ISU-MAVRIC/MAVRIC_Hardware/Pre-2016/Arm/Arm Design 2013-2014/Pictures/arm base.PNG

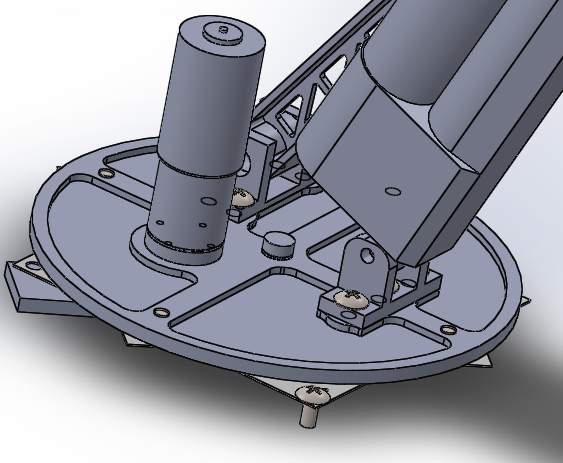
Pre-2016/Arm/Arm Design 2013-2014/Pictures/arm base.PNG
