ISU-MAVRIC/MAVRIC_Hardware/README.md

MAVRIC_Hardware
===============

Hardware design files for MAVRIC
