ISU-MAVRIC/MAVRIC_Hardware/Pre-2016/Chassis/Chassis 1 (Box Chassis)/Renders/Crossmember.JPG

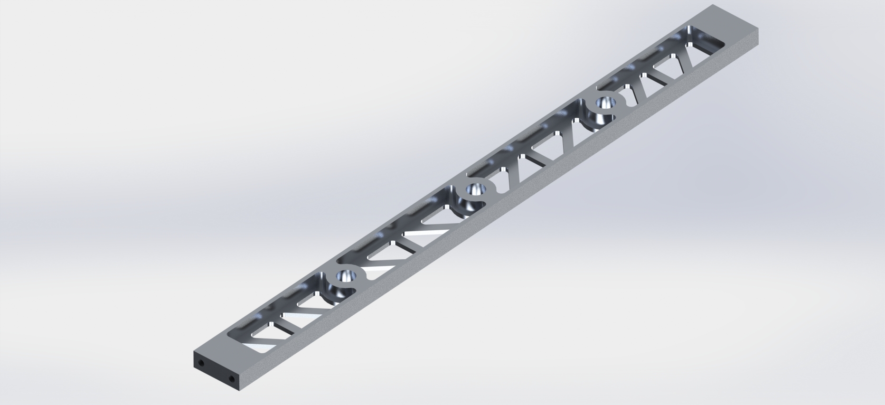
Pre-2016/Chassis/Chassis 1 (Box Chassis)/Renders/Crossmember.JPG
