ISU-MAVRIC/MAVRIC_Hardware/Pre-2016/Chassis/Chassis 1 (Box Chassis)/Renders/Diff Bar Render.JPG

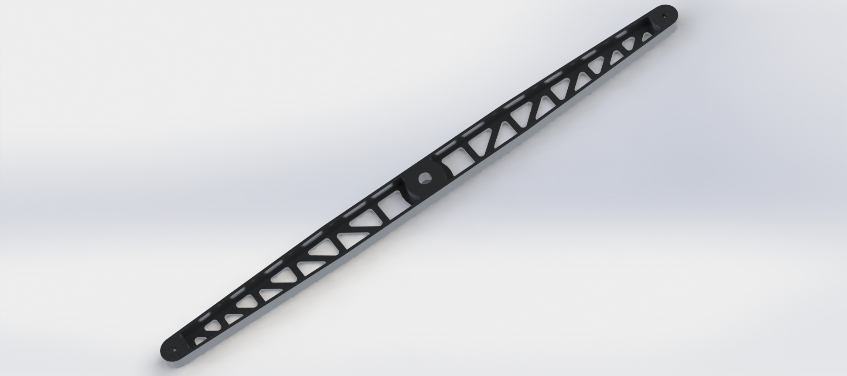
Pre-2016/Chassis/Chassis 1 (Box Chassis)/Renders/Diff Bar Render.JPG
