ISU-MAVRIC/MAVRIC_Hardware/Pre-2016/Photos/MAVRIC side view (Poster).JPG

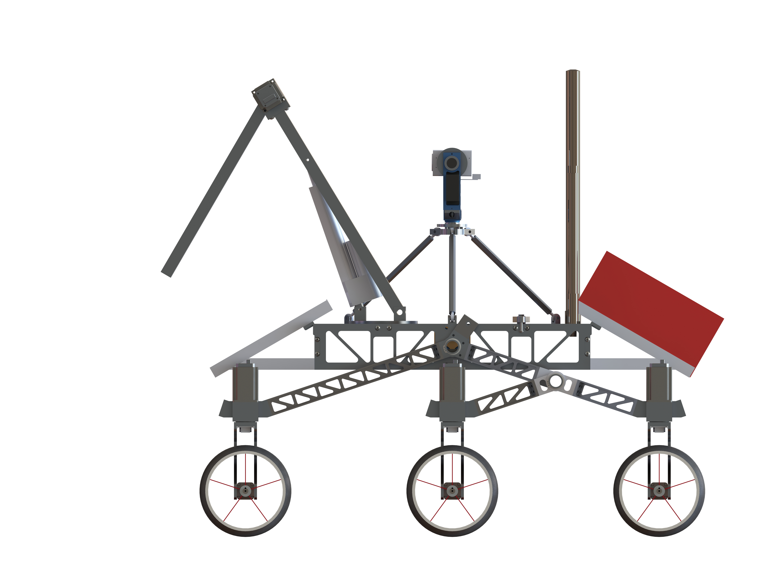
Pre-2016/Photos/MAVRIC side view (Poster).JPG
