ISU-MAVRIC/MAVRIC_Hardware/2017/Motherboard/BOMs/Motherboard BOM.xlsx

Sheet: BOM
Part | Package | Cost | Qty. | Total
Motherboard
4.7uF Cap (http://www.digikey.com/product-detail/en/samsung-electro-mechanics-america-inc/CL10B475KQ8NQNC/1276-2087-1-ND/3890173) | 603 | 0.1
0.1uF Cap (http://www.digikey.com/product-detail/en/avx-corporation/08055C104KAT2A/478-1395-1-ND/564427) | 805 | 0.1
22pF Cap (http://www.digikey.com/product-detail/en/avx-corporation/06035A220JAT2A/478-1167-1-ND/564199) | 603 | 0.1
10uF Cap (http://www.digikey.com/product-detail/en/murata-electronics-north-america/GRM21BR60J106ME19L/490-1718-1-ND/587425) | 805 | 0.1
22uF Cap (http://www.digikey.com/product-detail/en/samsung-electro-mechanics-america-inc/CL21A226MQCLQNC/1276-2412-1-ND/3890498) | 805 | 0.1
Green LED (http://www.digikey.com/product-detail/en/lite-on-inc/LTST-C191KGKT/160-1446-1-ND/386834) | 603 | 0.29
Red LED (http://www.digikey.com/product-detail/en/lite-on-inc/LTST-C190KRKT/160-1436-1-ND/386816) | 603 | 0.27
Female DB9 (http://www.digikey.com/product-detail/en/norcomp-inc/190-009-263R001/190-09FA-ND/1086934) | SMT | 2.53
Female DB9 (http://www.digikey.com/product-detail/en/assmann-wsw-components/A-DF-09-A-KG-T2S/AE10921-ND/1241800) | Through Hole | 0.78
PCIe 36 (http://www.digikey.com/product-detail/en/molex-llc/0877159008/WM12799-ND/3469125) | Through Hole | 1.36
10k Res (http://www.digikey.com/product-detail/en/stackpole-electronics-inc/RMCF0805JT10K0/RMCF0805JT10K0CT-ND/1942577) | 805 | 0.1
220 Res (http://www.digikey.com/product-detail/en/yageo/RC1206FR-07220RL/311-220FRCT-ND/731640) | 1206 | 0.1
2.2k Res (http://www.digikey.com/product-detail/en/stackpole-electronics-inc/RMCF0805JT2K20/RMCF0805JT2K20CT-ND/1942563) | 805 | 0.1
SPST Button (http://www.digikey.com/product-detail/en/c-k/PTS645SM43SMTR92-LFS/CKN9112CT-ND/1146934) | SW_SPSTEVQP0 | 0.15
MSP432P401 (http://www.digikey.com/product-detail/en/texas-instruments/MSP432P401RIPZR/296-44715-1-ND/6167110) | LQFP_100_14mmx14mm | 8.31
LM340MP-5.0 (http://www.digikey.com/product-detail/en/texas-instruments/LM340MP-5.0-NOPB/LM340MP-5.0-NOPBCT-ND/270747) | SOT-223-4 | 1.24
LD1086DT33TR (http://www.digikey.com/product-detail/en/stmicroelectronics/LD1086DT33TR/497-3446-1-ND/669240) | TO-252 | 0.98
MCP9808 (http://www.digikey.com/product-detail/en/microchip-technology/MCP9808T-E-MS/MCP9808T-E-MSCT-ND/5169548) | MSOP8_3mmx3mm | 1.16
Enclosure (http://www.newark.com/multicomp/mc001109/enclosure-ip65-pc-grey/dp/84Y6290) |  | 14.66

Sheet: Power Budget
Part | Qty | Voltage | Current (mA) | Total Current | Notes | Temp
Motherboard
Green LED (http://www.digikey.com/product-detail/en/lite-on-inc/LTST-C191KGKT/160-1446-1-ND/386834) | 3 | 3.3v | 0.05 | 0.15
Red LED (http://www.digikey.com/product-detail/en/lite-on-inc/LTST-C190KRKT/160-1436-1-ND/386816) | 4 | 3.3v | 0.05 | 0.2
MSP432P401 (http://www.digikey.com/product-detail/en/texas-instruments/MSP432P401RIPZR/296-44715-1-ND/6167110) | 1 | 3.3v | 3.84 | 3.84
LM340MP-5.0 (http://www.digikey.com/product-detail/en/texas-instruments/LM340MP-5.0-NOPB/LM340MP-5.0-NOPBCT-ND/270747) | -- | -- | -- | -- | 1.5A Limit
LD1086DT33TR (http://www.digikey.com/product-detail/en/stmicroelectronics/LD1086DT33TR/497-3446-1-ND/669240) | -- | -- | -- | -- | 1.5A Limit
MCP9808 (http://www.digikey.com/product-detail/en/microchip-technology/MCP9808T-E-MS/MCP9808T-E-MSCT-ND/5169548) | 1 | 3.3v | 0.2 | 0.2
PWM Board
PCA9685 (http://www.nxp.com/documents/data_sheet/PCA9685.pdf) | 1 | 3.3v | 200 | 200 | Per pin, can sink 25mA and source 10mA | -40C to +85C
ADS1015 (http://www.digikey.com/product-detail/en/texas-instruments/ADS1015IDGSR/296-41185-1-ND/5222640) | 2 | 3.3v | 0.15 | 0.3 |  | -40C to +125C
