ISU-MAVRIC/MAVRIC_Hardware/2017/Arduino Practice Board/Ordering Information/ArduinoPracticeBoard BOM.xlsx

Part | Package Size | Supplier | Price Each | # | Total Price
PCB (https://oshpark.com/) | 1.5"x1.44" | OSH Park | $11.00 | 1 | $11.00
10uf Tantalum Capacitor (http://www.digikey.com/product-detail/en/kemet/T491A106K010AT/399-3684-1-ND/819009) | 1206 | Digikey | $0.38 | 3 | $1.14
18pF Cer. Capacitor (http://www.digikey.com/product-detail/en/murata-electronics-north-america/GRM1555C1H180FA01D/490-6203-1-ND/3845400) | 0402 | Digikey | $0.04 | 10 | $0.43
Green LED (http://www.digikey.com/product-detail/en/lite-on-inc/LTST-C230KGKT/160-1456-1-ND/386854) | 1206 | Digikey | $0.34 | 3 | $1.02
10k Resistor (http://www.digikey.com/product-detail/en/yageo/RC0603JR-0710KL/311-10KGRCT-ND/729647) | 0603 | Digikey | $0.01 | 10 | $0.11
16MHz Crystal (http://www.digikey.com/product-detail/en/abracon-llc/ABLS-16.000MHZ-B4-T/535-10226-1-ND/2184261) | HC49/US | Digikey | $0.25 | 3 | $0.75
Tactile Switch (http://www.digikey.com/product-detail/en/c-k-components/PTS645SM43SMTR92-LFS/CKN9112CT-ND/1146934) | 6.0mmx6.0mm | Digikey | $0.15 | 3 | $0.45
ATMEGA328-AU-ND (http://www.digikey.com/scripts/DkSearch/dksus.dll?Detail&itemSeq=211061238&uq=636138769219925247) | 32-TQFP | Digikey | $3.25 | 3 | $9.75
2.54mm Header | 50pcsx40row | Amazon | $6.06 | 1 | $6.06
 |  |  |  |  | Total
 |  |  |  |  | $30.71
