ISU-MAVRIC/MAVRIC_Hardware/MAVRIC.SLDASM

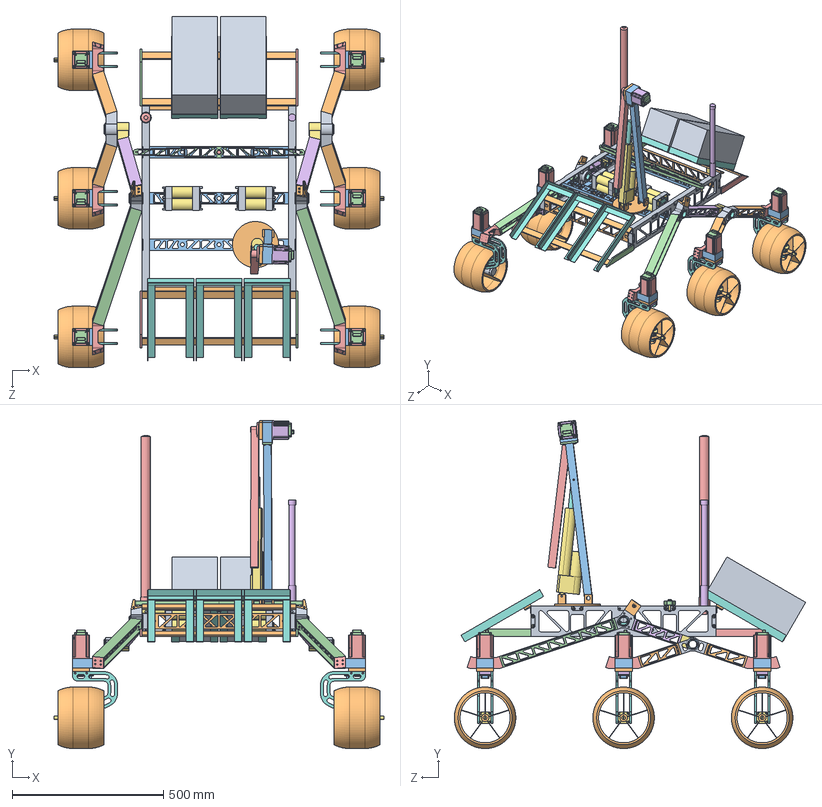
[picture p57: CAD file, 2013-12-05]
MAVRIC.SLDASM
1089.2 x 1083.1 x 1159.7 mm
Chassis Side Rail x 2
Front Bar x 2
Cross Bar x 3
Diff Bar
Diff Bar Axle
98585A109 x 2
socket button head cap screw_ai x 31
King Pin x 2
King Joint x 2
Diff Yoke x 2
98585A127 x 4
Rocker Leg x 2
Wheel Joint x 6
Rocker Rear Leg x 2
Bogie-Rocker Joint x 2
Joint Pin x 2
Bogie Joint x 2
Bogie Leg x 4
Dual Stage Housing x 7
6383K140 Input bearing x 7
Dual Stage Eccentric Cam x 7
5905K230 Roller Bearing x 7
First Stage Cycloidal Profile-Reduced Diameter Version x 7
Second Stage Cycloidal Profile-Reduced Diamter Version x 7
Dual Stage Output Disk-Reduced Diameter Version x 7
Cover x 7
6383K120 x 28
5909K370 x 14
Stepper 23079 x 6
Steering Top Plate x 6
P60_64_Gearbox x 6
Drop Plate x 12
RS555 Motor x 6
Wheel x 6
Wheel Driver x 6
Stepper Driver x 7
Data Antenna
Video Antenna
M Cell Battery x 8
Battery Bar x 6
Cell Holder x 8
Rotary Plate
Lower Arm
Gearbox Mount
Upper Arm
Stepper 23055
Firgelli Base
Firgelli Extension
Payload Support Clip x 2
Payload Cross Member x 4
Payload Bottom Clip x 2
Payload Bottom Member x 2
MirrorPayload Bottom Member x 2
MirrorPayload Bottom Clip x 2
MirrorPayload Support Clip x 2
Payload Frame x 5
Large Payload x 2
