ISU-MAVRIC/MAVRIC_Hardware/Pre-2016/Camera/Camera Assembly.SLDASM

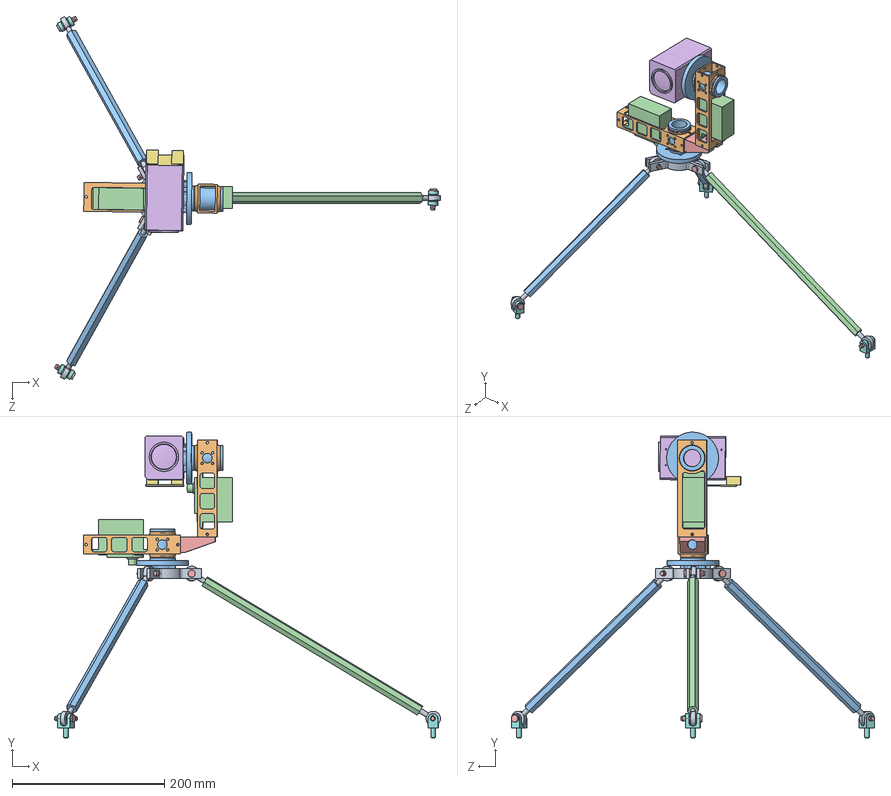
[picture p58: CAD file, 2014-04-26]
Pre-2016/Camera/Camera Assembly.SLDASM
507.2 x 401.7 x 477.6 mm
Camera Mount
Servo Frame x 2
Servo Axle x 2
HS785HB Servo x 2
Elbow
FCB EX1020
Camera Board
Camera Anchor x 3
Ball Joint Housing x 6
Ball Joint Ball x 6
Camera Leg x 2
Side Leg
90156A259 x 6
