ISU-MAVRIC/MAVRIC_Hardware/Pre-2016/Chassis/Chassis 1 (Box Chassis)/Chassis Assembly.SLDASM

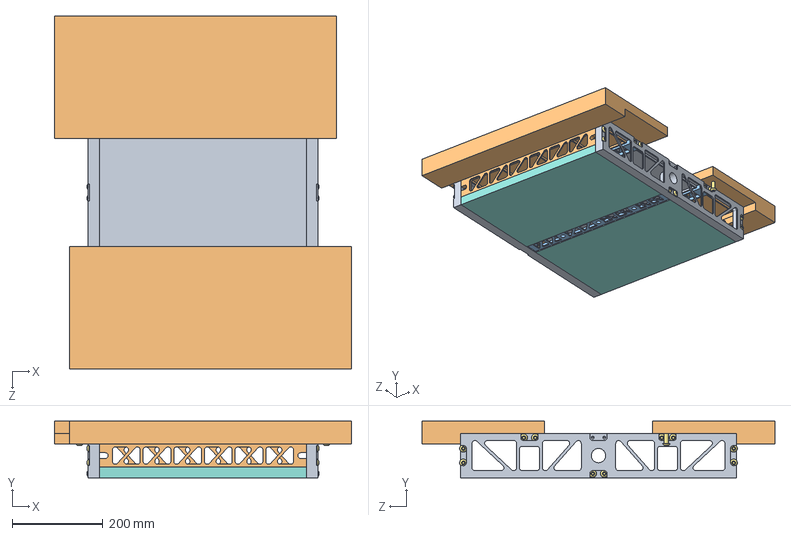
[picture p59: CAD file, 2014-04-26]
Pre-2016/Chassis/Chassis 1 (Box Chassis)/Chassis Assembly.SLDASM
656.0 x 125.4 x 779.5 mm
Chassis Side Rail x 2
Front Bar x 2
Cross Bar x 3
Diff Bar
Diff Bar Axle
98585A109 x 2
socket button head cap screw_ai x 22
Fiberglass Bottom Covers x 2
Center composite panel
Chassis Top Right Composite x 2
