ISU-MAVRIC/MAVRIC_Hardware/Pre-2016/Chassis/Chassis 1 (Box Chassis)/Major components/Mold Cavity.SLDASM

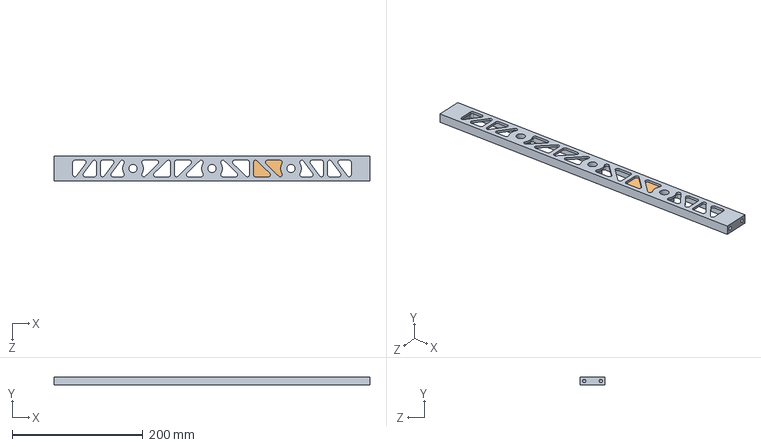
[picture p60: CAD file, 2014-04-17]
Pre-2016/Chassis/Chassis 1 (Box Chassis)/Major components/Mold Cavity.SLDASM
482.6 x 12.7 x 38.1 mm
Cross Bar
Cross Bar Mount 2
