ISU-MAVRIC/MAVRIC_Hardware/Pre-2016/Electrical/Cell Battery Assembly.SLDASM

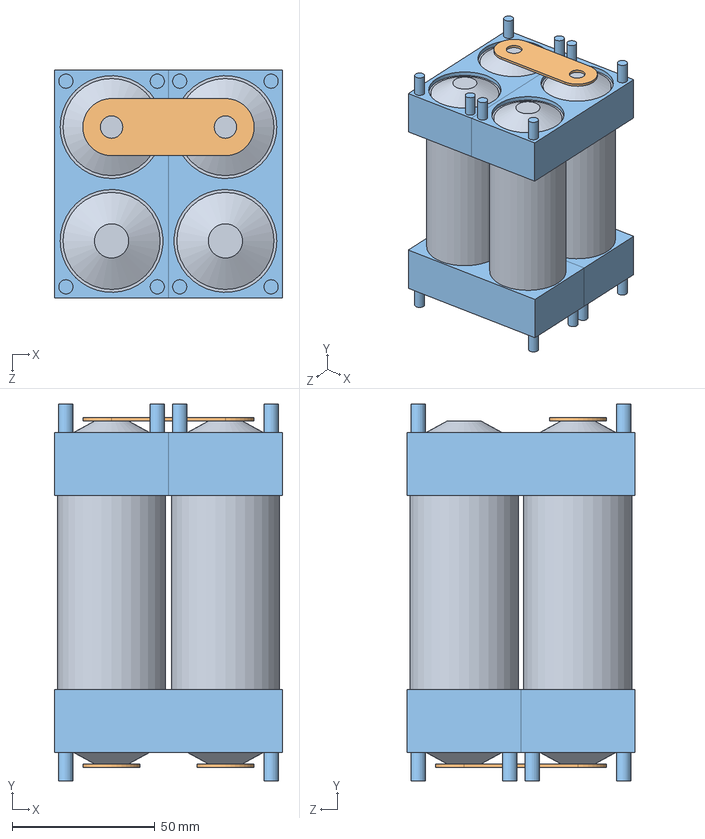
[picture p61: CAD file, 2014-04-26]
Pre-2016/Electrical/Cell Battery Assembly.SLDASM
80.0 x 132.0 x 80.0 mm
M Cell Battery x 4
Battery Bar x 3
Cell Holder x 4
