ISU-MAVRIC/MAVRIC_Hardware/Pre-2016/End Effector/End Effector Assemblies/End Effector Assembly 4.SLDASM

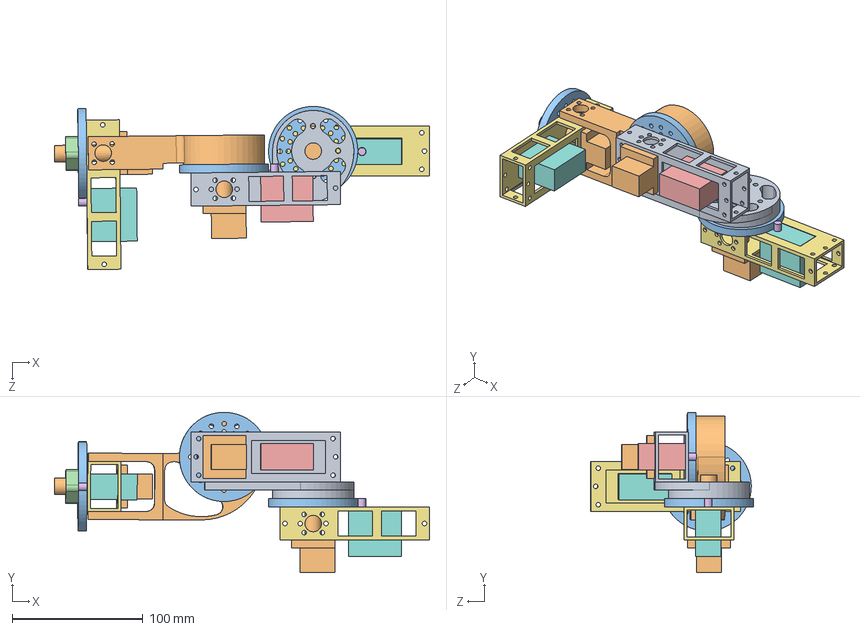
[picture p62: CAD file, 2014-04-15]
Pre-2016/End Effector/End Effector Assemblies/End Effector Assembly 4.SLDASM
286.7 x 122.6 x 124.7 mm
High Torque Gear Box Bracket
Large Spindle x 3
Big Gear x 3
Big Gear Hub x 3
High Torque Servo
Small Spindle x 3
Low Torque Gear Box Bracket x 2
Low Torque Servo x 2
bracket1-2
bracket2-3
