ISU-MAVRIC/MAVRIC_Hardware/Pre-2016/End Effector/Servo Assemblies/High Torque Gear Box Assembly.SLDASM

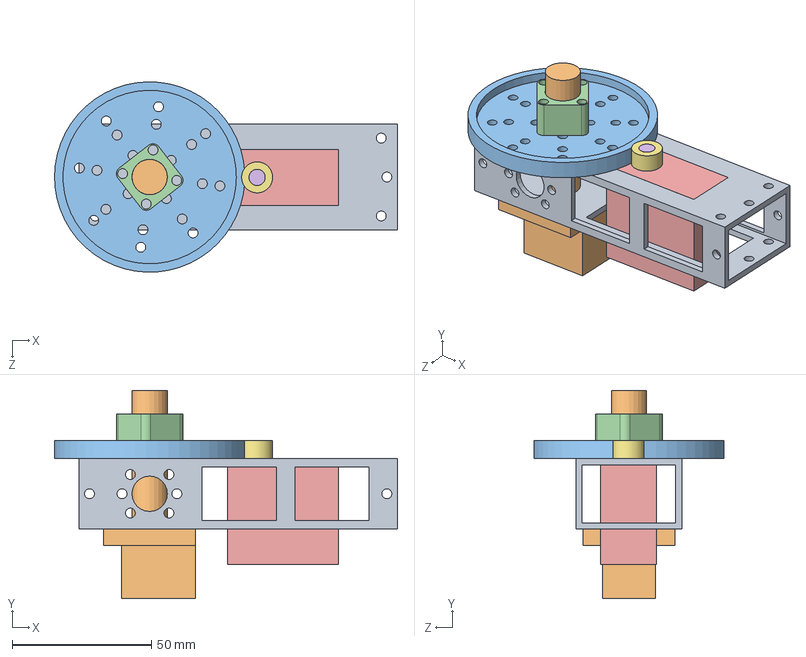
[picture p63: CAD file, 2014-03-13]
Pre-2016/End Effector/Servo Assemblies/High Torque Gear Box Assembly.SLDASM
123.0 x 74.7 x 68.2 mm
High Torque Gear Box Bracket
Large Spindle
Big Gear
Big Gear Hub
High Torque Servo
Small Spindle
Small Gear
