ISU-MAVRIC/MAVRIC_Hardware/Pre-2016/Steering Assembly.SLDASM

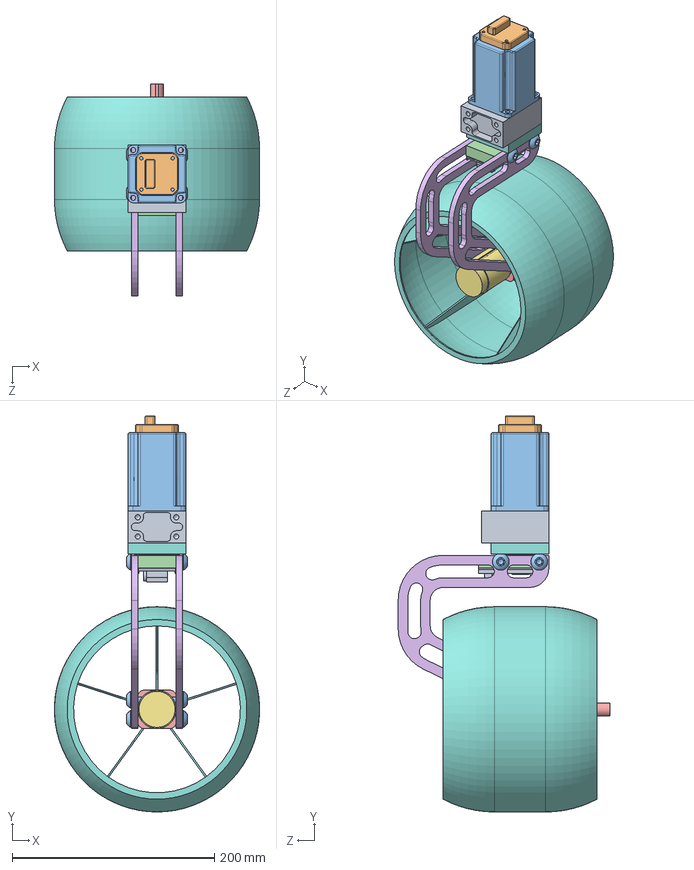
[picture p64: CAD file, 2014-02-13]
Pre-2016/Steering Assembly.SLDASM
203.0 x 391.9 x 209.6 mm
Dual Stage Housing
6383K140 Input bearing
Dual Stage Eccentric Cam
5905K230 Roller Bearing
First Stage Cycloidal Profile-Reduced Diameter Version
Second Stage Cycloidal Profile-Reduced Diamter Version
Dual Stage Output Disk-Reduced Diameter Version
Cover
6383K120 x 4
5909K370 x 2
Stepper 23079
Steering Top Plate
P60_64_Gearbox
Drop Plate x 2
RS555 Motor
Wheel
Wheel Driver
Stepper Driver
socket button head cap screw_ai x 13
