ISU-MAVRIC/MAVRIC_Hardware/Pre-2016/Steering Gearbox/Cover Assembly.SLDASM

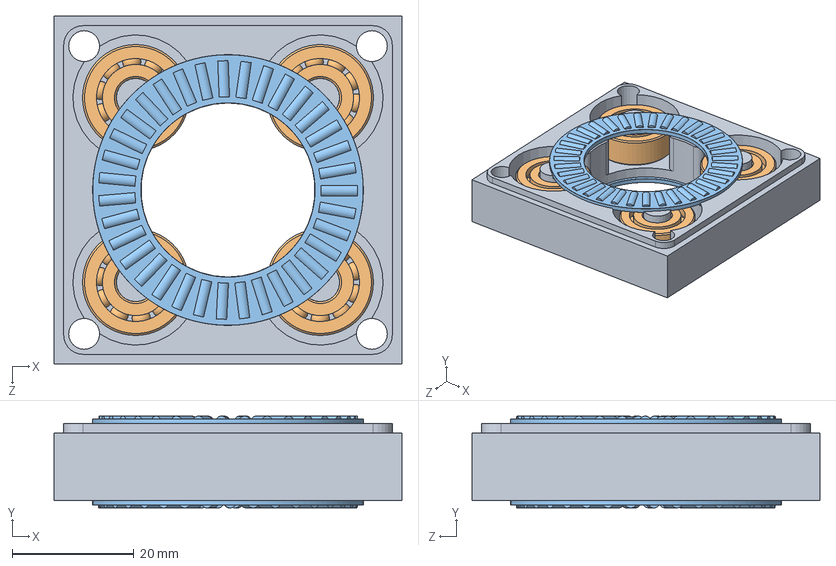
[picture p65: CAD file, 2014-04-26]
Pre-2016/Steering Gearbox/Cover Assembly.SLDASM
57.1 x 15.1 x 57.1 mm
Cover
6383K120 x 4
5909K370 x 2
