ISU-MAVRIC/MAVRIC_Hardware/Pre-2016/Suspension/Suspension Mirror.SLDASM

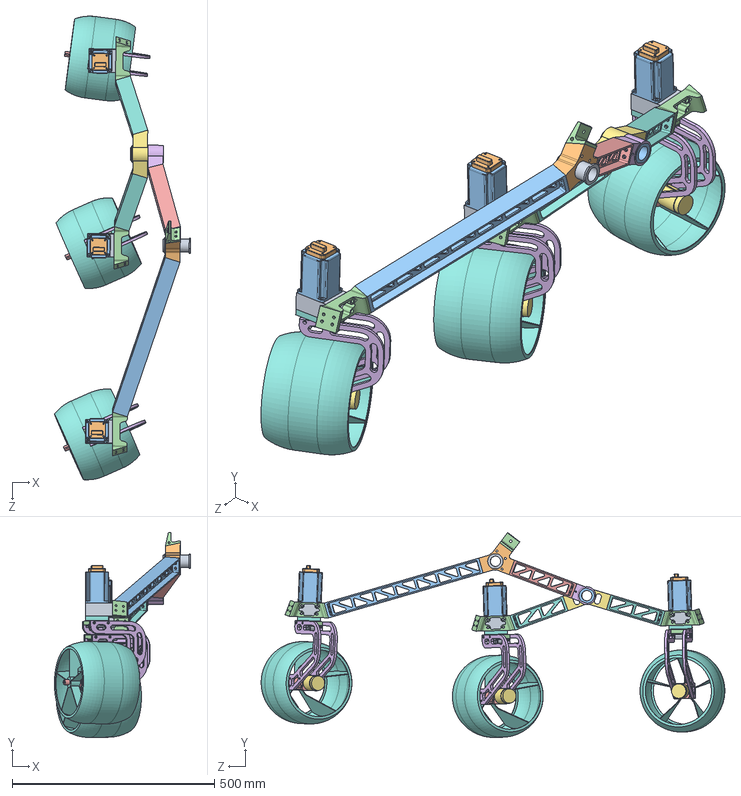
[picture p66: CAD file, 2014-04-26]
Pre-2016/Suspension/Suspension Mirror.SLDASM
337.0 x 507.4 x 1147.7 mm
King Pin
King Joint
Rocker Leg
Wheel Joint x 3
Rocker Rear Leg
Bogie-Rocker Joint
Bogie Joint
Bogie Leg x 2
Dual Stage Housing x 3
6383K140 Input bearing x 3
Dual Stage Eccentric Cam x 3
5905K230 Roller Bearing x 3
First Stage Cycloidal Profile-Reduced Diameter Version x 3
Second Stage Cycloidal Profile-Reduced Diamter Version x 3
Dual Stage Output Disk-Reduced Diameter Version x 3
Cover x 3
6383K120 x 12
5909K370 x 6
Stepper 23079 x 3
Steering Top Plate x 3
P60_64_Gearbox x 3
Drop Plate x 6
RS555 Motor x 3
Wheel x 3
Wheel Driver x 3
Stepper Driver x 3
Joint Pin
Diff Yoke
98585A127 x 2
