ISU-MAVRIC/MAVRIC_Hardware/Pre-2016/Wheel Pod/Wheel Assembly.SLDASM

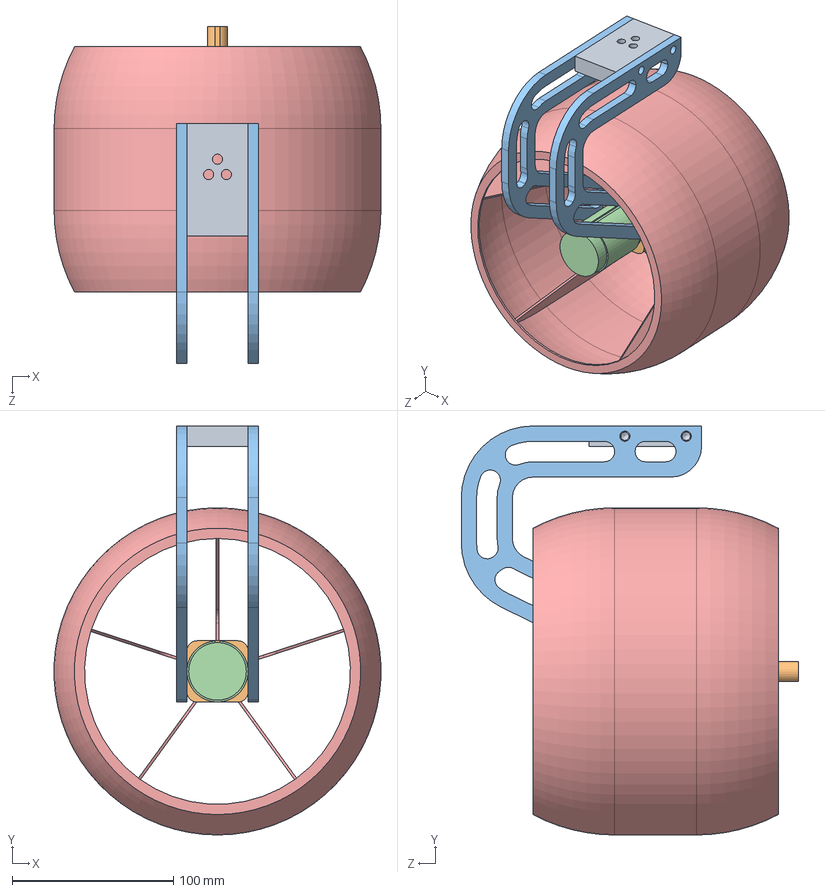
[picture p67: CAD file, 2014-04-26]
Pre-2016/Wheel Pod/Wheel Assembly.SLDASM
203.0 x 254.0 x 209.6 mm
Steering Top Plate
P60_64_Gearbox
Drop Plate x 2
RS555 Motor
Wheel
