ISU-MAVRIC/MAVRIC_Hardware/Pre-2016/Wheel Pod/Wheel Testing/Wheel Testing.SLDASM

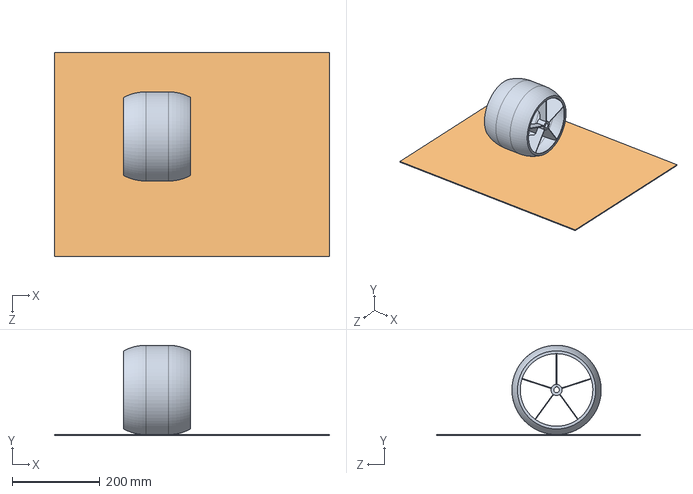
[picture p68: CAD file, 2013-11-02]
Pre-2016/Wheel Pod/Wheel Testing/Wheel Testing.SLDASM
625.5 x 205.7 x 464.9 mm
