ISU-MAVRIC/MAVRIC_Hardware/Pre-2016/Arm/Arm Design 2012-2013/Arm Assembly.SLDASM

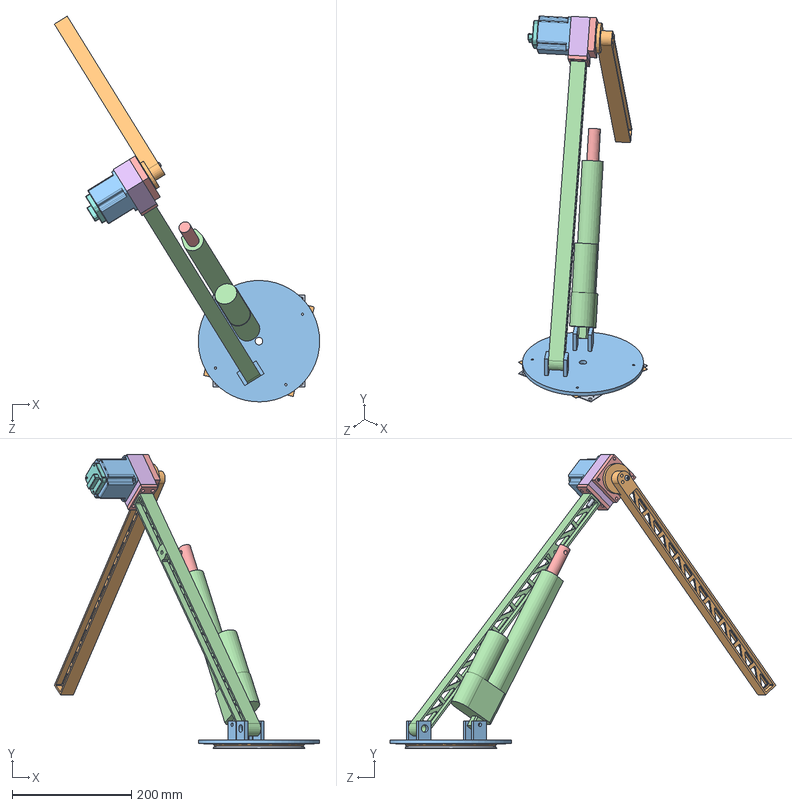
[picture p69: CAD file, 2014-02-13]
Pre-2016/Arm/Arm Design 2012-2013/Arm Assembly.SLDASM
444.2 x 492.1 x 645.7 mm
Turn Table Bottom
Turn Table Top
Rotary Plate
Lower Arm
Gearbox Mount
Dual Stage Housing
6383K140 Input bearing
Dual Stage Eccentric Cam
5905K230 Roller Bearing
First Stage Cycloidal Profile-Reduced Diameter Version
Second Stage Cycloidal Profile-Reduced Diamter Version
Dual Stage Output Disk-Reduced Diameter Version
Cover
6383K120 x 4
5909K370 x 2
Stepper Driver
socket button head cap screw_ai x 2
Upper Arm
Stepper 23055
Firgelli Base
Firgelli Extension
