ISU-MAVRIC/MAVRIC_Hardware/Pre-2016/Arm/Commercial Parts/Firgelli Linear/Firgelli Linear.SLDASM

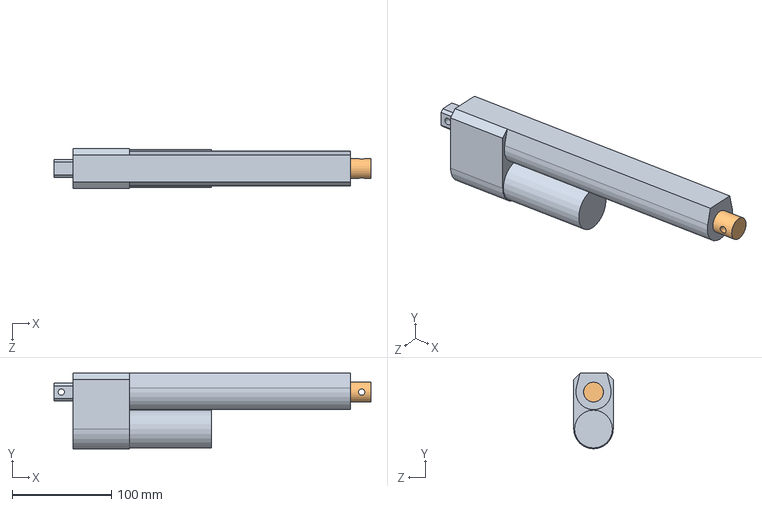
[picture p70: CAD file, 2013-12-04]
Pre-2016/Arm/Commercial Parts/Firgelli Linear/Firgelli Linear.SLDASM
319.0 x 76.2 x 39.9 mm
Firgelli Base
Firgelli Extension
