ISU-MAVRIC/MAVRIC_Hardware/Pre-2016/Camera/Camera CAM Mount Assembly.SLDASM

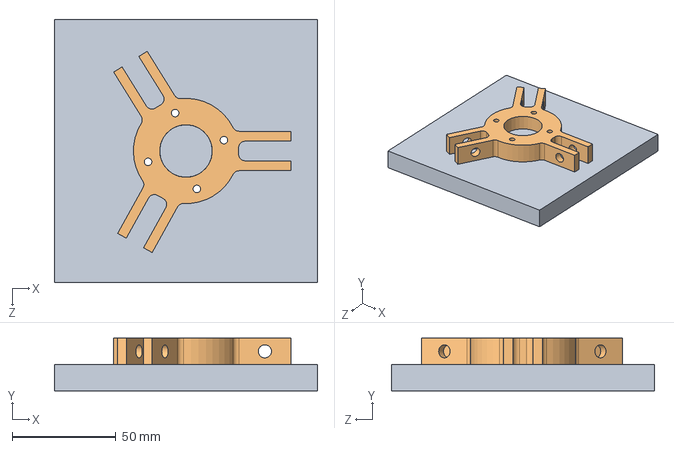
[picture p71: CAD file, 2014-02-20]
Pre-2016/Camera/Camera CAM Mount Assembly.SLDASM
127.0 x 25.4 x 127.0 mm
Camera Fixture
Camera Mount
