ISU-MAVRIC/MAVRIC_Hardware/Pre-2016/End Effector/End Effector Assemblies/End Effector Assembly 3.SLDASM

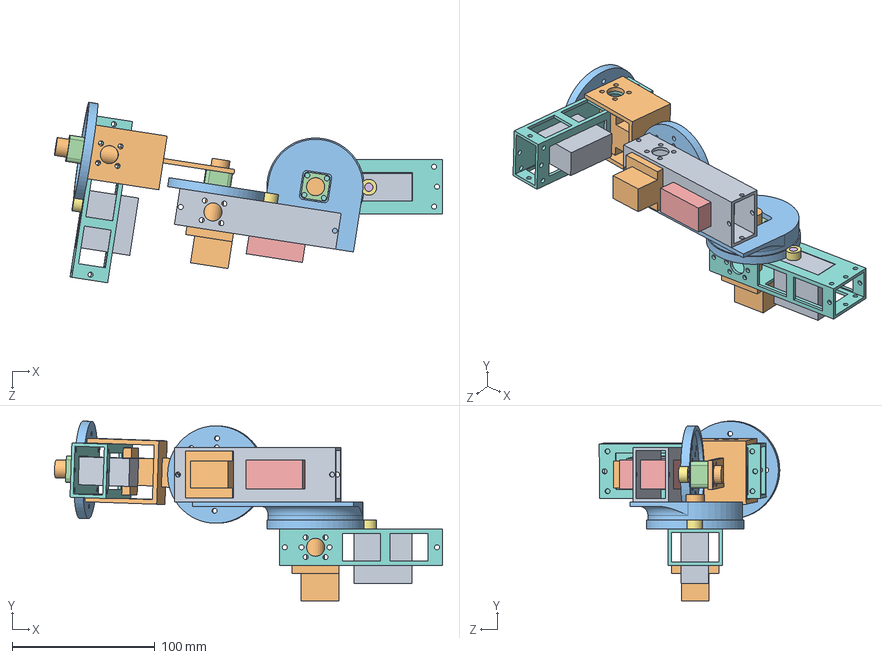
[picture p72: CAD file, 2014-03-08]
Pre-2016/End Effector/End Effector Assemblies/End Effector Assembly 3.SLDASM
271.8 x 126.0 x 126.5 mm
High Torque Gear Box Bracket
Large Spindle x 3
Big Gear x 3
Big Gear Hub x 3
High Torque Servo
Small Spindle x 3
Small Gear x 3
Low Torque Gear Box Bracket x 2
Low Torque Servo x 2
Bracket (s2 to s3)
bracket1-2
