ISU-MAVRIC/MAVRIC_Hardware/Pre-2016/Suspension/Fixturing/Hole Plate Assembly.SLDASM

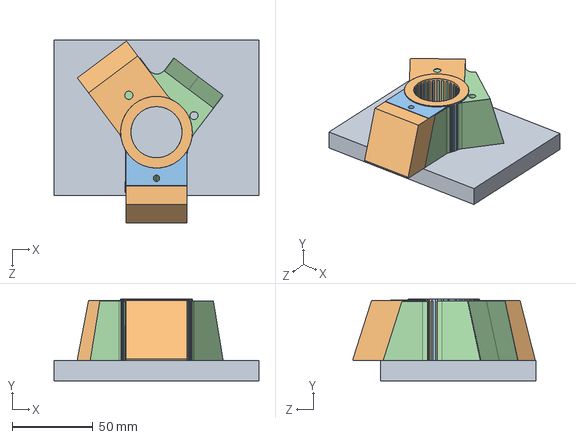
[picture p73: CAD file, 2014-01-03]
Pre-2016/Suspension/Fixturing/Hole Plate Assembly.SLDASM
127.0 x 50.8 x 113.5 mm
Hole Fixturing Plate
King Joint
