ISU-MAVRIC/MAVRIC_Hardware/Pre-2016/Suspension/Suspension Assembly.SLDASM

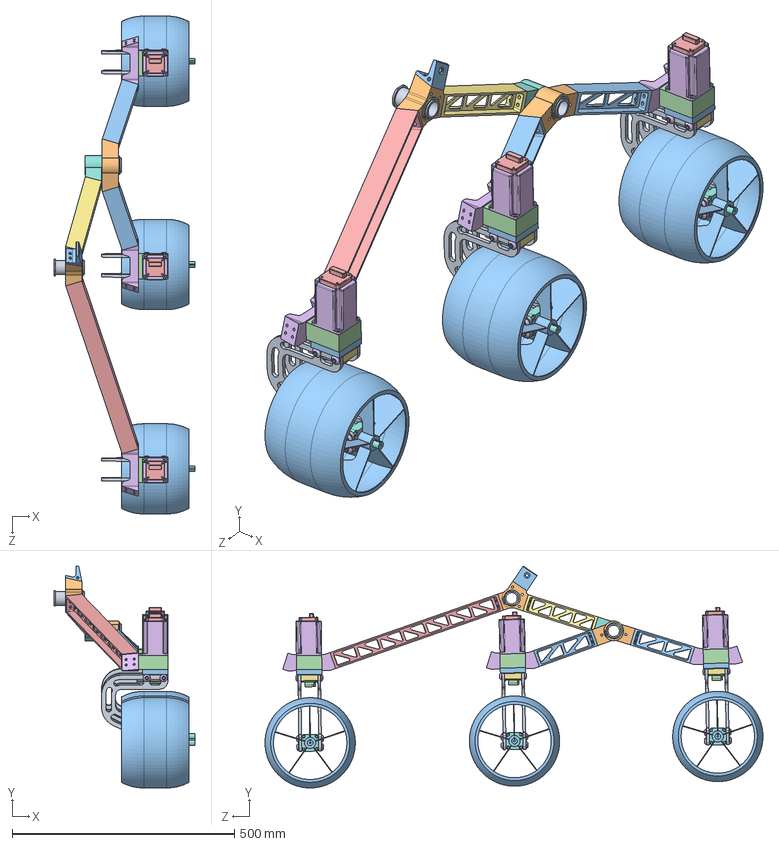
[picture p74: CAD file, 2014-04-26]
Pre-2016/Suspension/Suspension Assembly.SLDASM
316.0 x 499.1 x 1119.7 mm
King Pin
King Joint
Diff Yoke
98585A127 x 2
Rocker Leg
Wheel Joint x 3
Rocker Rear Leg
Bogie-Rocker Joint
Joint Pin
Bogie Joint
Bogie Leg x 2
Dual Stage Housing x 3
6383K140 Input bearing x 3
Dual Stage Eccentric Cam x 3
5905K230 Roller Bearing x 3
First Stage Cycloidal Profile-Reduced Diameter Version x 3
Second Stage Cycloidal Profile-Reduced Diamter Version x 3
Dual Stage Output Disk-Reduced Diameter Version x 3
Cover x 3
6383K120 x 12
5909K370 x 6
Stepper 23079 x 3
Steering Top Plate x 3
P60_64_Gearbox x 3
Drop Plate x 6
RS555 Motor x 3
Wheel x 3
Wheel Driver x 3
Stepper Driver x 3
socket button head cap screw_ai x 39
