ISU-MAVRIC/MAVRIC_Hardware/Pre-2016/Arm/Commercial Parts/Turn Table/Turn Table Assembly.SLDASM

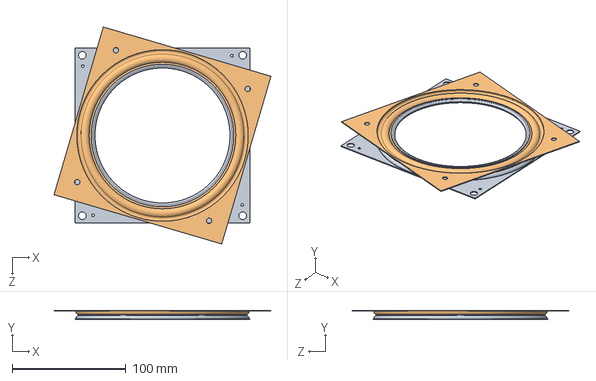
[picture p75: CAD file, 2014-01-10]
Pre-2016/Arm/Commercial Parts/Turn Table/Turn Table Assembly.SLDASM
191.2 x 8.13 x 191.2 mm
Turn Table Bottom
Turn Table Top
