ISU-MAVRIC/MAVRIC_Hardware/Pre-2016/Chassis/Chassis 1 (Box Chassis)/Diff/Diff Linkage Assembly.SLDASM

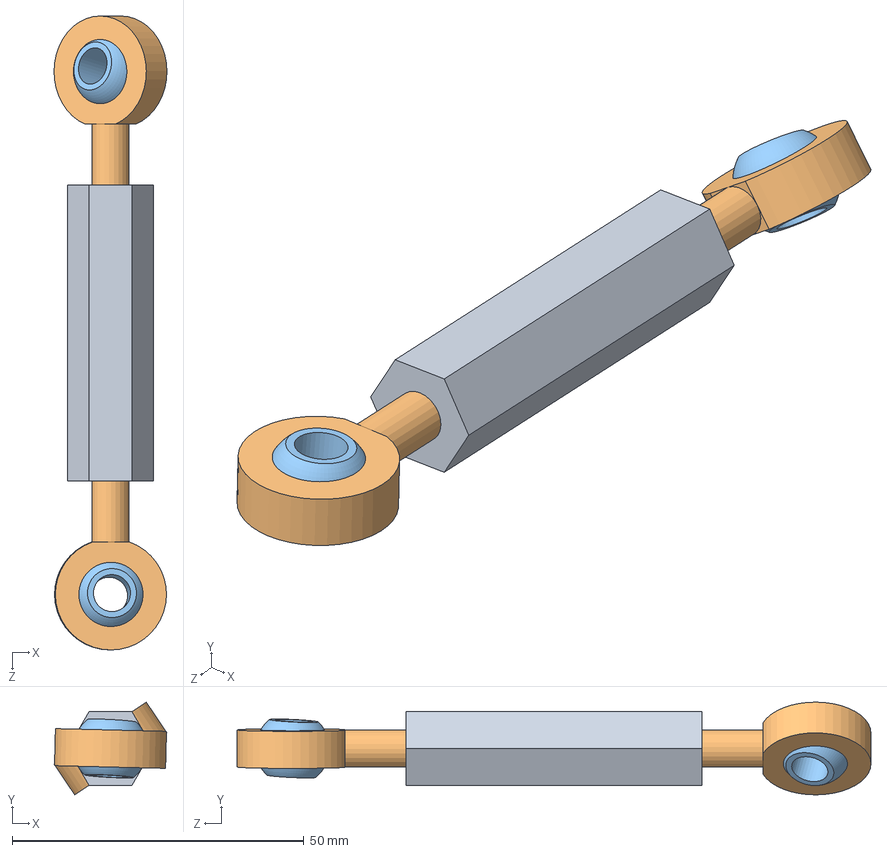
[picture p76: CAD file, 2013-11-14]
Pre-2016/Chassis/Chassis 1 (Box Chassis)/Diff/Diff Linkage Assembly.SLDASM
19.4 x 15.9 x 108.6 mm
Diff Link
Ball Joint Housing x 2
Ball Joint Ball x 2
