ISU-MAVRIC/MAVRIC_Hardware/Pre-2016/End Effector/End Effector Assemblies/End Effector Assembly 2.SLDASM

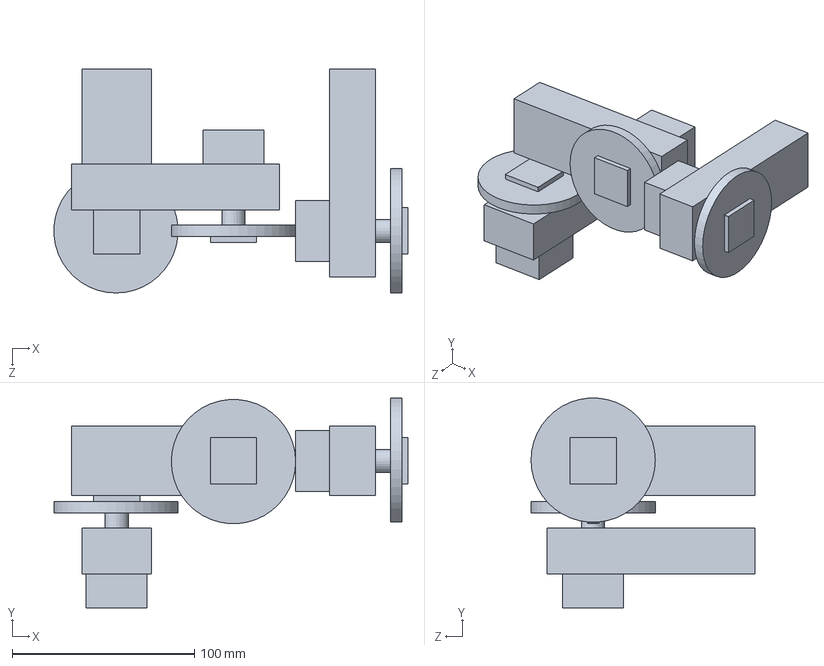
[picture p77: CAD file, 2014-02-22]
Pre-2016/End Effector/End Effector Assemblies/End Effector Assembly 2.SLDASM
194.5 x 115.2 x 123.0 mm
Test Servo x 3
