ISU-MAVRIC/MAVRIC_Hardware/Pre-2016/End Effector/Servo Assembly Components/Big Gear Assembly.SLDASM

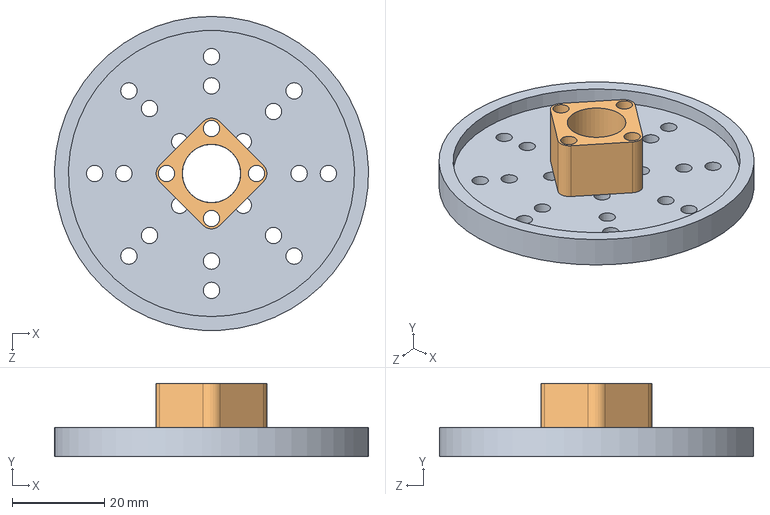
[picture p78: CAD file, 2014-04-10]
Pre-2016/End Effector/Servo Assembly Components/Big Gear Assembly.SLDASM
68.2 x 15.9 x 68.3 mm
Big Gear
Big Gear Hub
