ISU-MAVRIC/MAVRIC_Hardware/Pre-2016/Soil Sample Tool/bottomfixturingplate.SLDASM

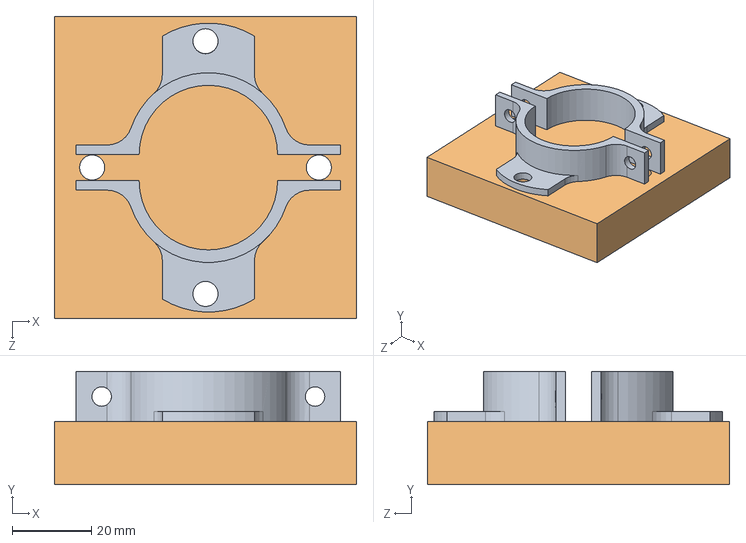
[picture p79: CAD file, 2014-01-09]
Pre-2016/Soil Sample Tool/bottomfixturingplate.SLDASM
76.2 x 28.6 x 76.2 mm
bottomtabssoilsamplenew2013
fixturing plate
