ISU-MAVRIC/MAVRIC_Hardware/Pre-2016/Wheel Pod/Fabrication/Drop Plate Waterjet.SLDASM

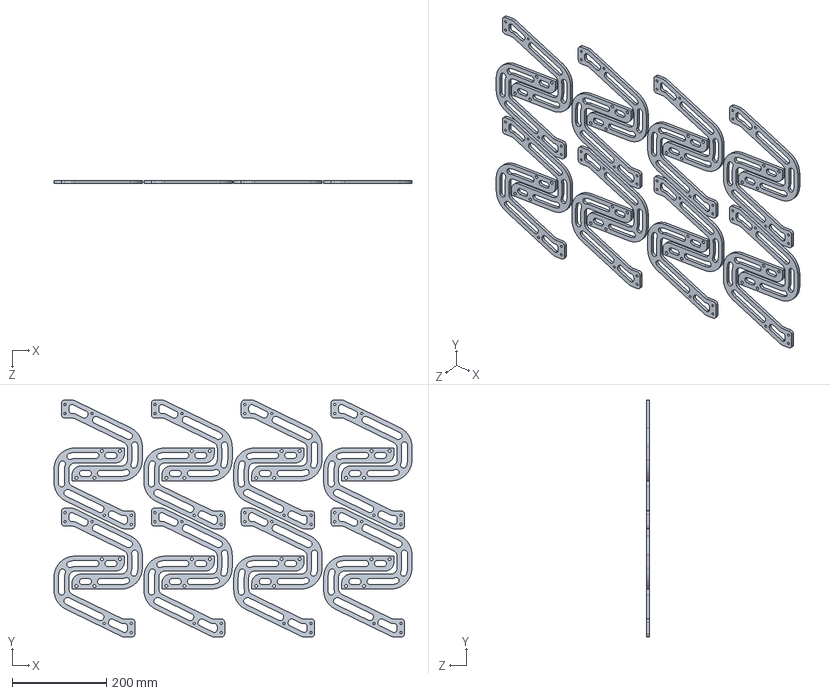
[picture p80: CAD file, 2014-01-06]
Pre-2016/Wheel Pod/Fabrication/Drop Plate Waterjet.SLDASM
758.8 x 502.2 x 6.35 mm
Drop Plate x 16
