ISU-MAVRIC/MAVRIC_Hardware/Pre-2016/Arm/Arm Design 2013-2014/gear assembly.SLDASM

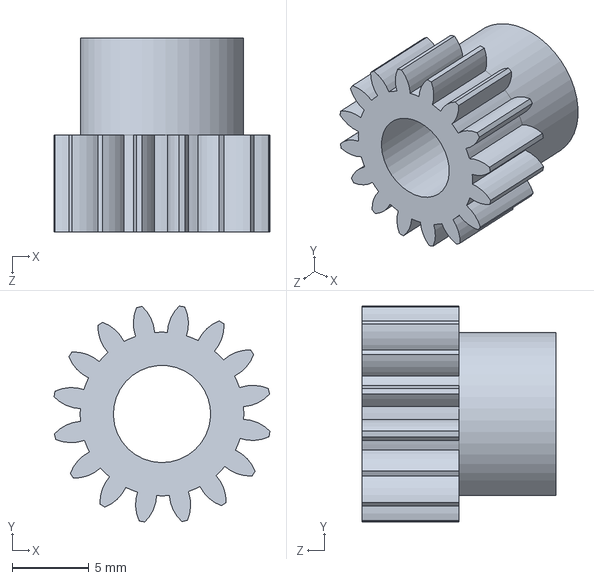
[picture p81: CAD file, 2014-04-26]
Pre-2016/Arm/Arm Design 2013-2014/gear assembly.SLDASM
14.1 x 14.1 x 12.7 mm
