ISU-MAVRIC/MAVRIC_Hardware/Pre-2016/Camera/Servo Assembly.SLDASM

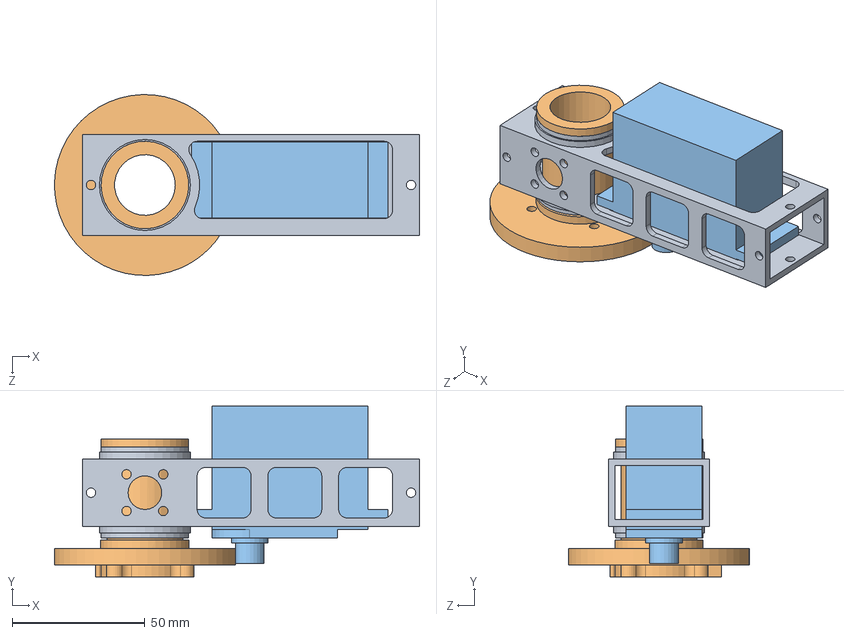
[picture p82: CAD file, 2014-01-21]
Pre-2016/Camera/Servo Assembly.SLDASM
137.6 x 64.4 x 68.2 mm
Servo Frame
Servo Axle
HS785HB Servo
