ISU-MAVRIC/MAVRIC_Hardware/Pre-2016/Chassis/Chassis 1 (Box Chassis)/Covers/Composite/Bottom cover Mold Assembly.SLDASM

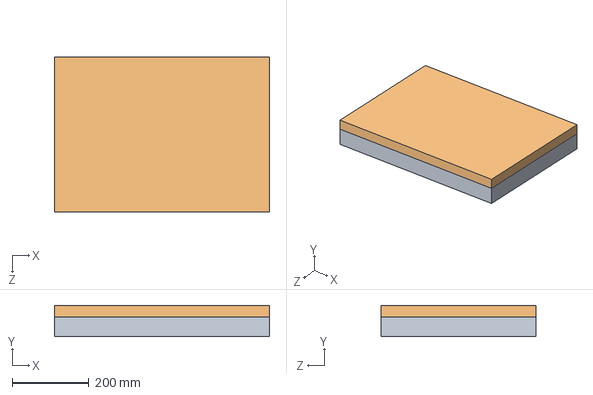
[picture p83: CAD file, 2014-04-01]
Pre-2016/Chassis/Chassis 1 (Box Chassis)/Covers/Composite/Bottom cover Mold Assembly.SLDASM
558.8 x 81.0 x 403.2 mm
Bottom Cover Mold
Bottom Cover Mold Top
