ISU-MAVRIC/MAVRIC_Hardware/Pre-2016/End Effector/End Effector Assemblies/End Effector Assembly.SLDASM

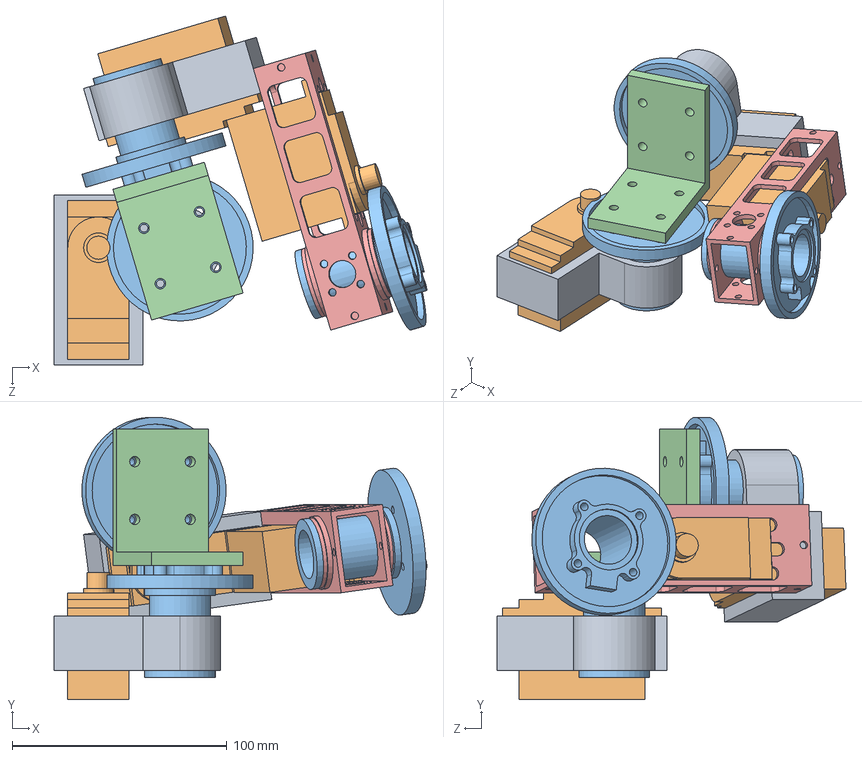
[picture p84: CAD file, 2014-02-13]
Pre-2016/End Effector/End Effector Assemblies/End Effector Assembly.SLDASM
173.6 x 131.5 x 162.5 mm
Servo Bracket x 2
HS785HB Servo x 3
Servo Axle x 3
L bracket
Servo Frame
