ISU-MAVRIC/MAVRIC_Hardware/Pre-2016/Steering Gearbox/Gearbox Assembly.SLDASM

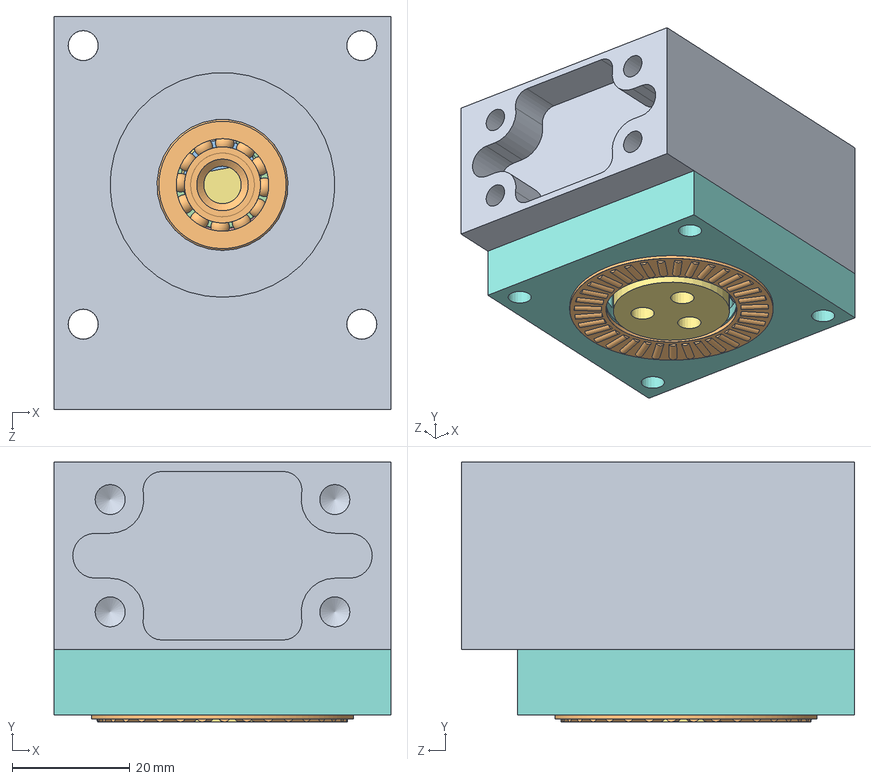
[picture p85: CAD file, 2014-02-13]
Pre-2016/Steering Gearbox/Gearbox Assembly.SLDASM
57.1 x 44.1 x 66.7 mm
Dual Stage Housing
6383K140 Input bearing
Dual Stage Eccentric Cam
5905K230 Roller Bearing
First Stage Cycloidal Profile-Reduced Diameter Version
Second Stage Cycloidal Profile-Reduced Diamter Version
Dual Stage Output Disk-Reduced Diameter Version
Cover
6383K120 x 4
5909K370 x 2
