ISU-MAVRIC/MAVRIC_Hardware/Pre-2016/Suspension/Fixturing/Wheel Joint Hole Pattern.SLDASM

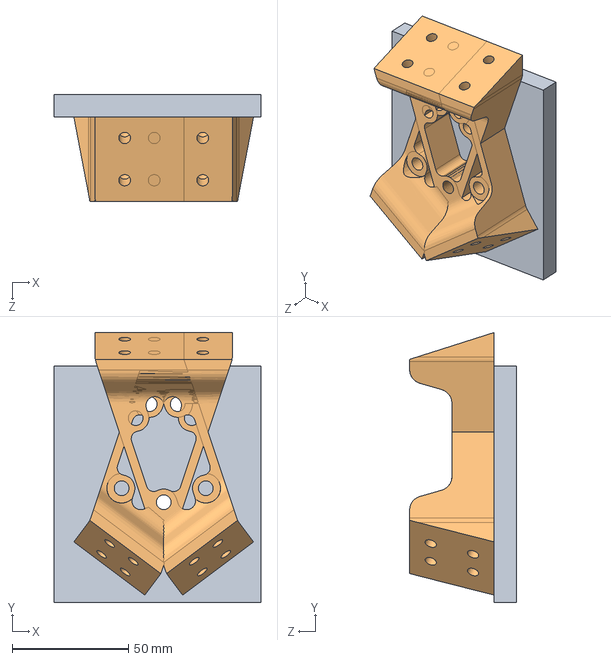
[picture p86: CAD file, 2014-01-03]
Pre-2016/Suspension/Fixturing/Wheel Joint Hole Pattern.SLDASM
88.9 x 116.0 x 45.8 mm
Wheel Joint Hole Plate
Wheel Joint x 2
