ISU-MAVRIC/MAVRIC_Hardware/Pre-2016/Wheel Pod/Wheel Cut Pattern.SLDASM

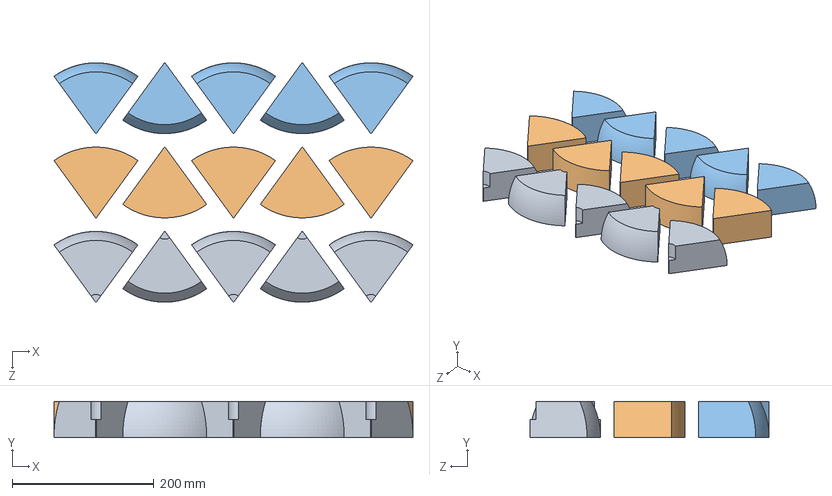
[picture p87: CAD file, 2013-11-14]
Pre-2016/Wheel Pod/Wheel Cut Pattern.SLDASM
506.6 x 50.8 x 337.8 mm
Wheel Fixturing Wedge1 x 5
Wheel Fixturing Wedge2 x 5
Wheel Fixturing Wedge3 x 5
