ISU-MAVRIC/MAVRIC_Hardware/Pre-2016/End Effector/Servo Assembly Components/Small Gear and Low Torque Servo Assembly.SLDASM

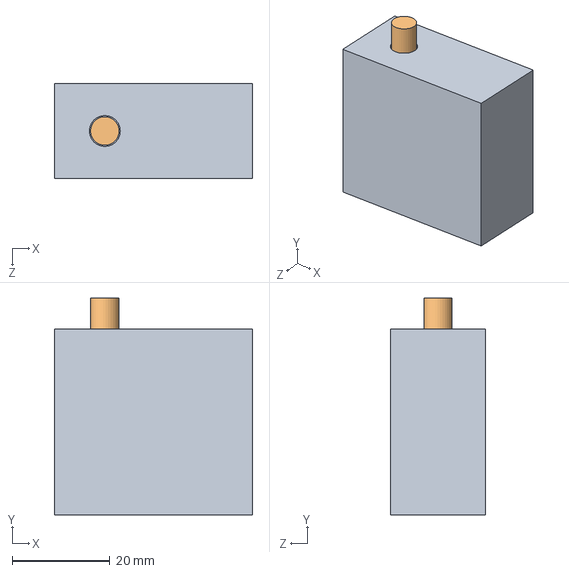
[picture p88: CAD file, 2014-03-27]
Pre-2016/End Effector/Servo Assembly Components/Small Gear and Low Torque Servo Assembly.SLDASM
40.6 x 44.5 x 19.6 mm
Low Torque Servo
Small Spindle
