ISU-MAVRIC/MAVRIC_Hardware/Pre-2016/Payload/Payload System.sldasm

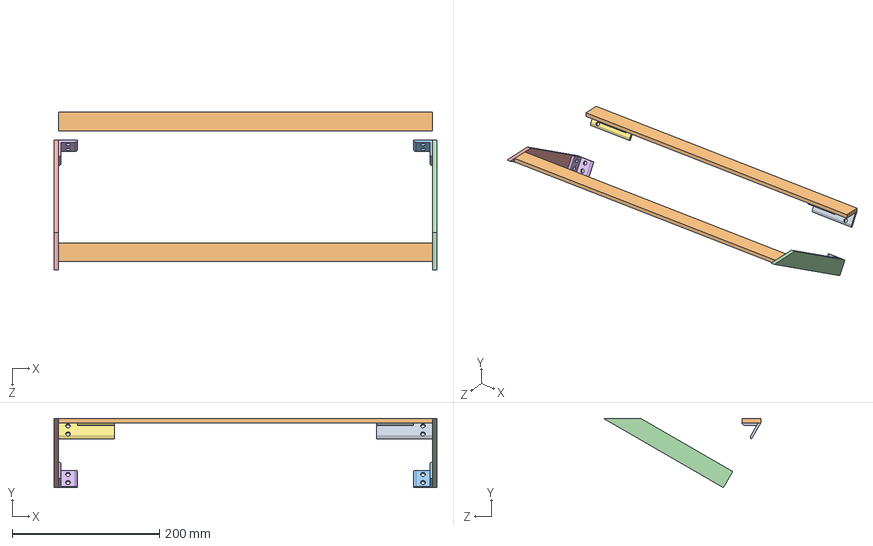
[picture p89: CAD file, 2013-12-05]
Pre-2016/Payload/Payload System.sldasm
520.7 x 94.3 x 214.2 mm
Payload Support Clip
Payload Cross Member x 2
Payload Bottom Clip
Payload Bottom Member
MirrorPayload Bottom Member
MirrorPayload Bottom Clip
MirrorPayload Support Clip
