ISU-MAVRIC/MAVRIC_Hardware/Pre-2016/End Effector/Servo Assembly Components/Small Gear Assembly.SLDASM

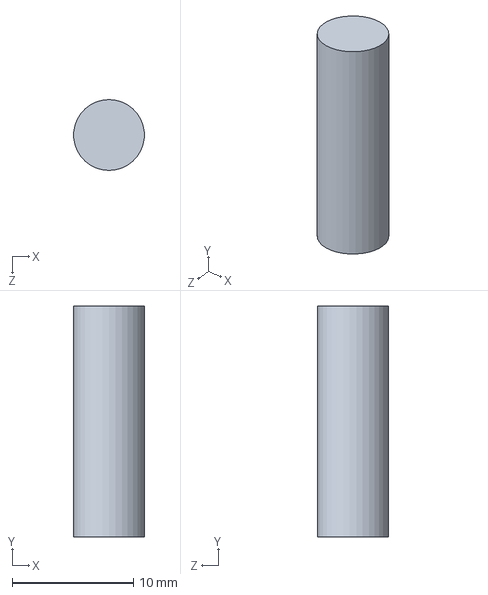
[picture p90: CAD file, 2014-03-27]
Pre-2016/End Effector/Servo Assembly Components/Small Gear Assembly.SLDASM
5.82 x 19.1 x 5.84 mm
