ISU-MAVRIC/MAVRIC_Hardware/Pre-2016/Arm/Arm Design 2013-2014/arm.SLDASM

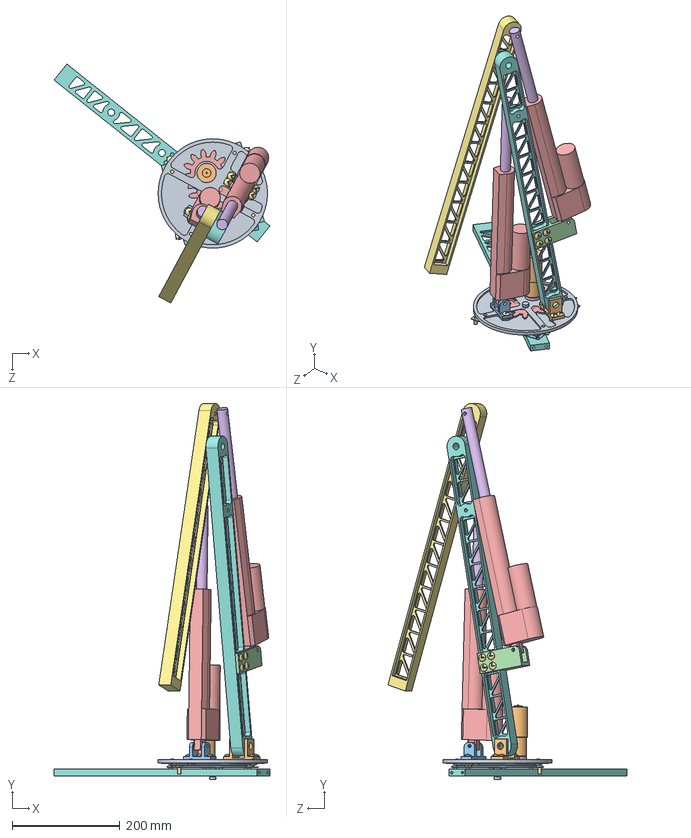
[picture p91: CAD file, 2014-04-26]
Pre-2016/Arm/Arm Design 2013-2014/arm.SLDASM
401.1 x 698.6 x 444.0 mm
rotary plate new
lower arm mount
lower actuator mount
actuator mount
Firgelli Base x 2
Firgelli Extension x 2
upper arm 2014
axis for base
Drive Motor
Turn Table Bottom
Turn Table Top
spur gear_ai x 2
motor mount
truss head screw_ai x 25
lower arm (1.5in Thick)
gear mount x 2
chassis mount 2
chassis mount
