ISU-MAVRIC/MAVRIC_Hardware/Pre-2016/End Effector/Servo Assembly Components/Small Gear and High Torque Servo Assembly.SLDASM

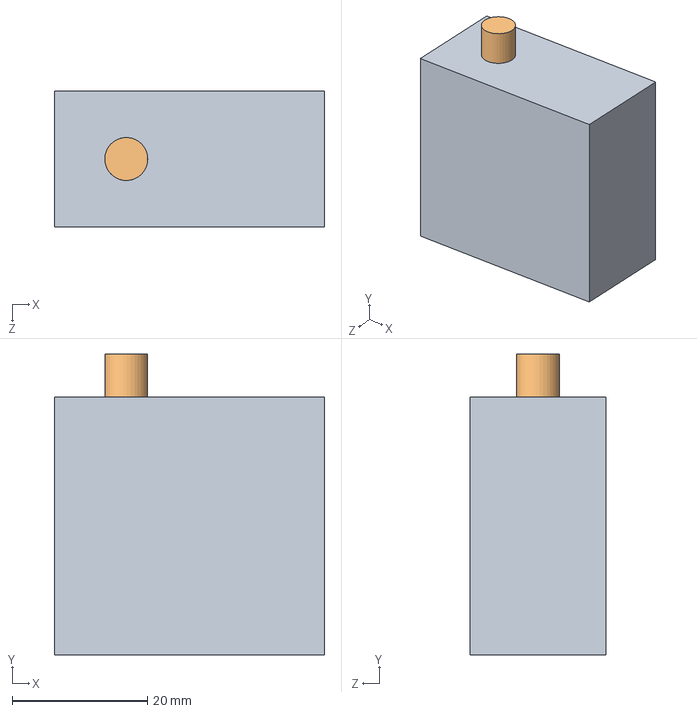
[picture p92: CAD file, 2014-03-27]
Pre-2016/End Effector/Servo Assembly Components/Small Gear and High Torque Servo Assembly.SLDASM
39.9 x 44.5 x 20.1 mm
High Torque Servo
Small Spindle
