ISU-MAVRIC/MAVRIC_Hardware/Pre-2016/Suspension/Fixturing/Wheel Joint Fixturing Assembly.SLDASM

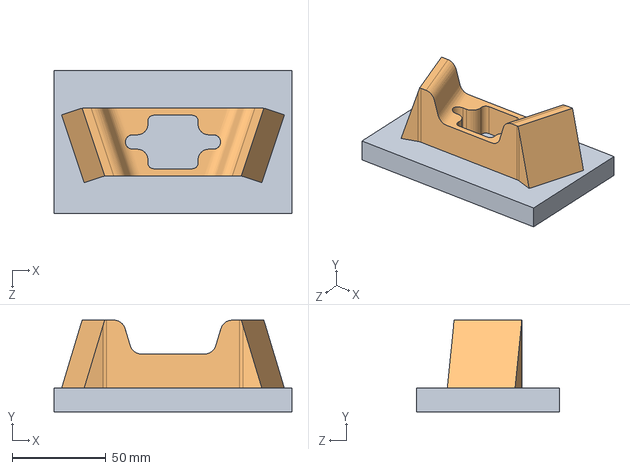
[picture p93: CAD file, 2013-12-13]
Pre-2016/Suspension/Fixturing/Wheel Joint Fixturing Assembly.SLDASM
127.0 x 49.0 x 76.2 mm
Wheel Joint Fixturing Plate
Wheel Joint (Modified for CAM)
