ISU-MAVRIC/MAVRIC_Hardware/Pre-2016/Wheel Pod/Wheel Fixture.SLDASM

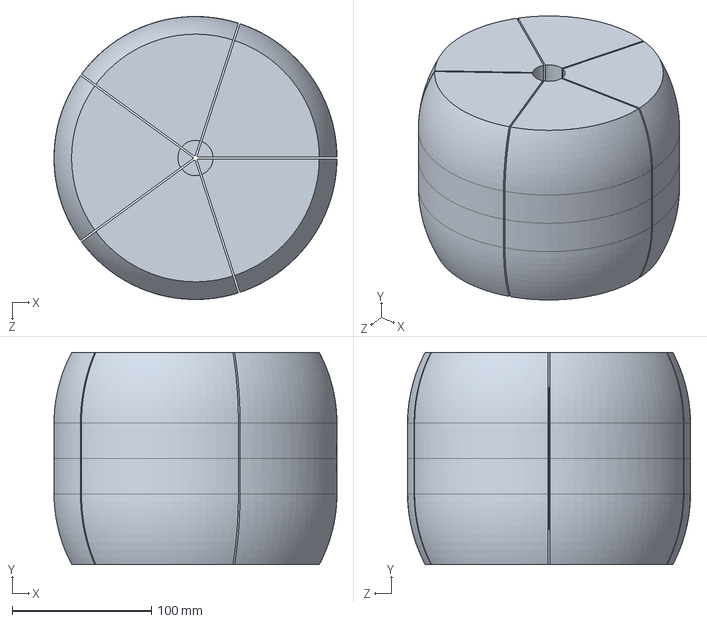
[picture p94: CAD file, 2013-11-02]
Pre-2016/Wheel Pod/Wheel Fixture.SLDASM
203.2 x 152.4 x 203.2 mm
Wheel Fixturing Wedge1 x 10
