ISU-MAVRIC/MAVRIC_Hardware/Pre-2016/Suspension/Fixturing/Bogie Joint Fixturing Assembly.SLDASM

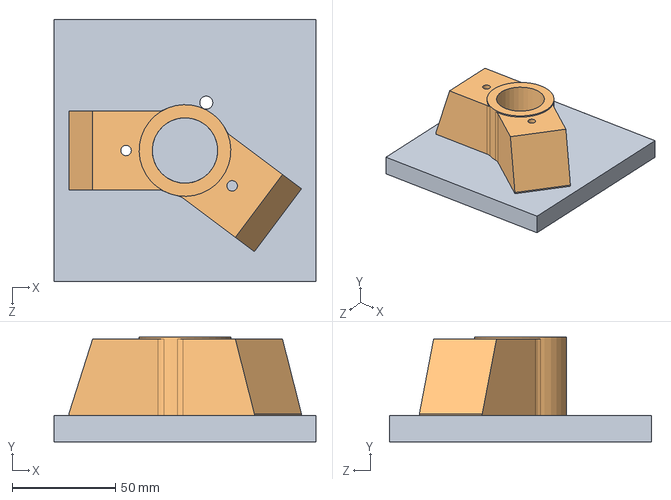
[picture p95: CAD file, 2013-12-11]
Pre-2016/Suspension/Fixturing/Bogie Joint Fixturing Assembly.SLDASM
127.0 x 50.8 x 127.0 mm
King Joint Fixturing plate
Bogie Joint (Modified for CAM)
