ISU-MAVRIC/MAVRIC_Hardware/Pre-2016/Suspension/Fixturing/Bogie-Rocker Fixture.SLDASM

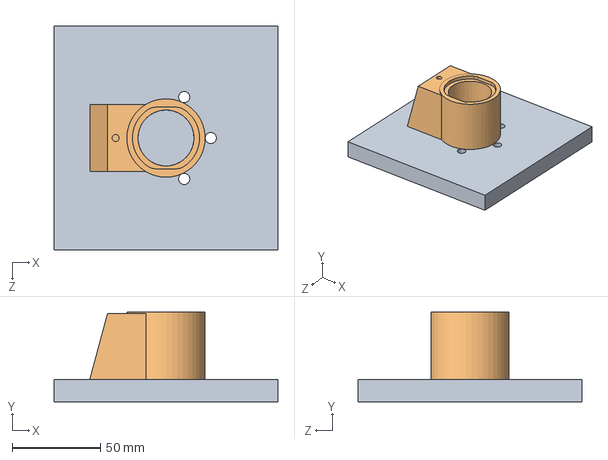
[picture p96: CAD file, 2013-11-26]
Pre-2016/Suspension/Fixturing/Bogie-Rocker Fixture.SLDASM
127.0 x 50.8 x 127.0 mm
King Joint Fixturing plate
Bogie-Rocker Joint (Modified for Cam)
