ISU-MAVRIC/MAVRIC_Hardware/Pre-2016/Suspension/Fixturing/Fixturing Assembly.SLDASM

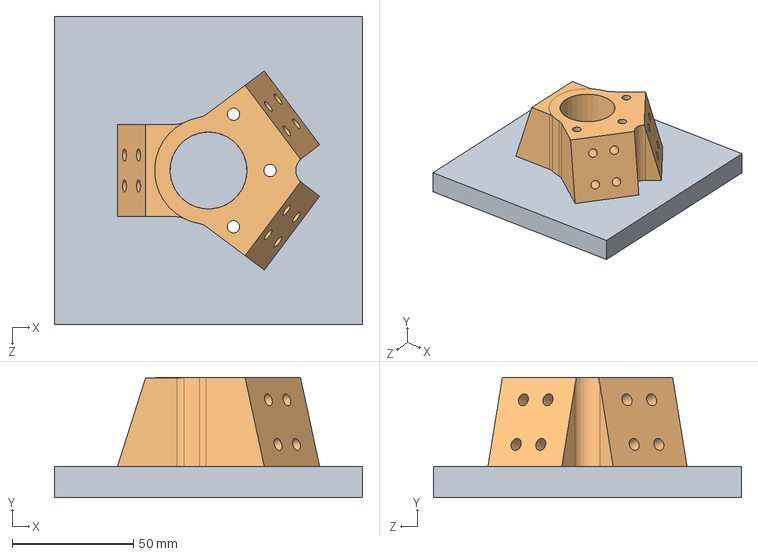
[picture p97: CAD file, 2013-11-22]
Pre-2016/Suspension/Fixturing/Fixturing Assembly.SLDASM
127.0 x 49.5 x 127.0 mm
King Joint Fixturing plate
King Joint
