ISU-MAVRIC/MAVRIC_Hardware/Pre-2016/Suspension/Fixturing/King Joint Fixturing Assembly.SLDASM

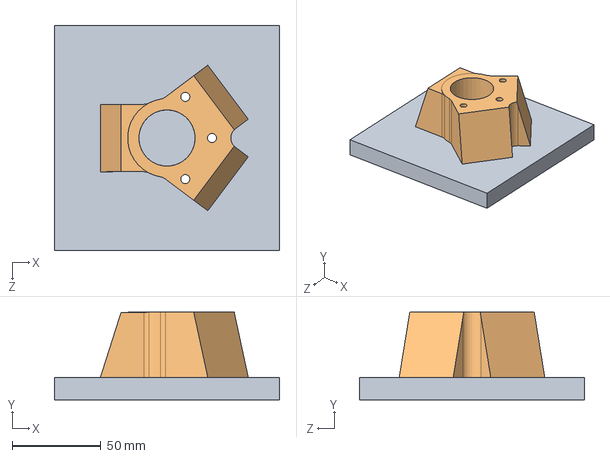
[picture p98: CAD file, 2013-11-22]
Pre-2016/Suspension/Fixturing/King Joint Fixturing Assembly.SLDASM
127.0 x 49.5 x 127.0 mm
King Joint Fixturing plate
King Joint
