ISU-MAVRIC/MAVRIC_Hardware/Pre-2016/Alex'scrap/alexWheel.SLDPRT

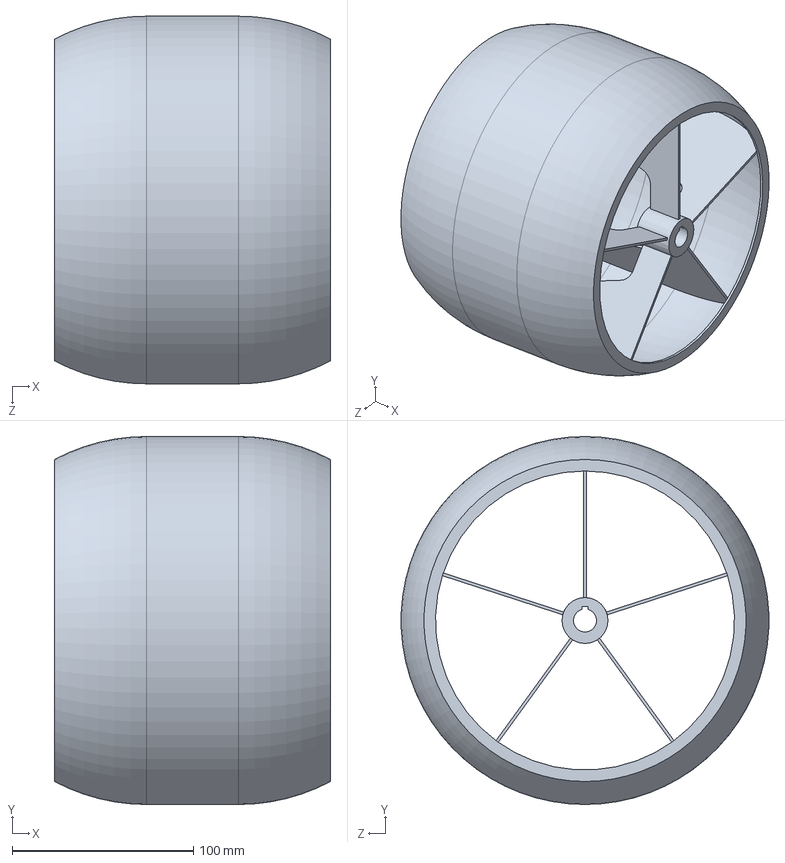
[picture p99: CAD file, 2014-01-10]
Pre-2016/Alex'scrap/alexWheel.SLDPRT
152.4 x 203.2 x 203.0 mm
