ISU-MAVRIC/MAVRIC_Hardware/Pre-2016/Arm/Arm Design 2012-2013/Rotary Plate.SLDPRT

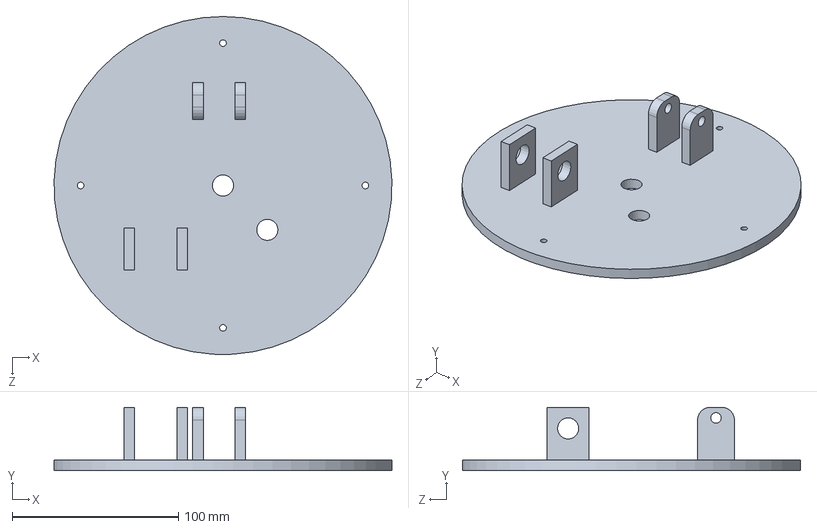
[picture p100: CAD file, 2014-02-18]
Pre-2016/Arm/Arm Design 2012-2013/Rotary Plate.SLDPRT
203.1 x 38.1 x 203.2 mm
