ISU-MAVRIC/MAVRIC_Hardware/Pre-2016/Arm/Arm Design 2013-2014/rotary plate new.SLDPRT

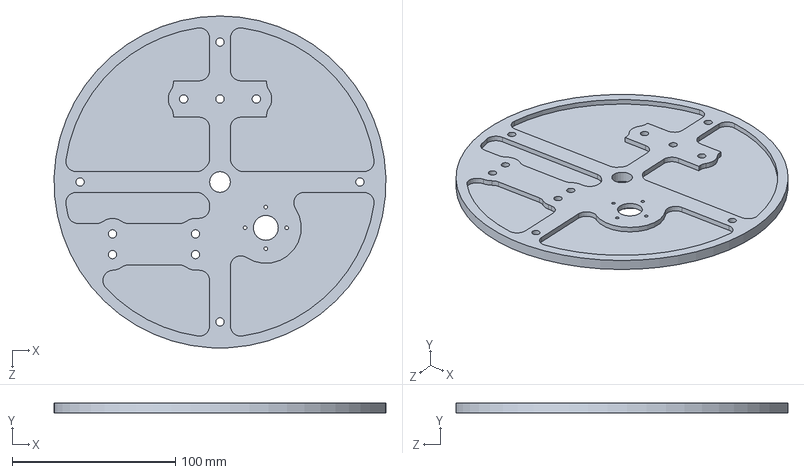
[picture p101: CAD file, 2014-04-26]
Pre-2016/Arm/Arm Design 2013-2014/rotary plate new.SLDPRT
203.1 x 6.35 x 203.2 mm
