ISU-MAVRIC/MAVRIC_Hardware/Pre-2016/Arm/Commercial Parts/Firgelli Linear/Firgelli Base.SLDPRT

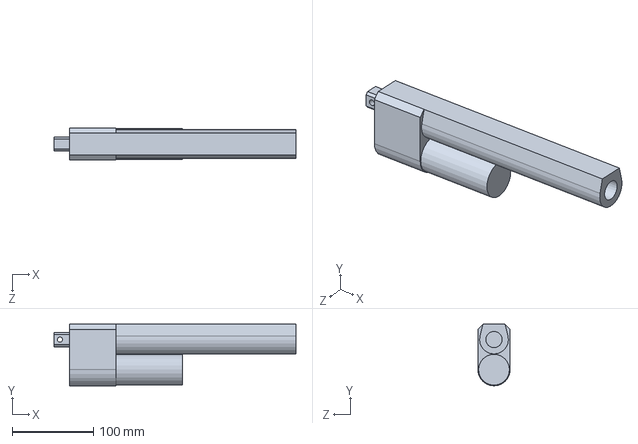
[picture p102: CAD file, 2014-04-26]
Pre-2016/Arm/Commercial Parts/Firgelli Linear/Firgelli Base.SLDPRT
298.4 x 76.2 x 39.9 mm
