ISU-MAVRIC/MAVRIC_Hardware/Pre-2016/Arm/Commercial Parts/Stepper 23055.SLDPRT

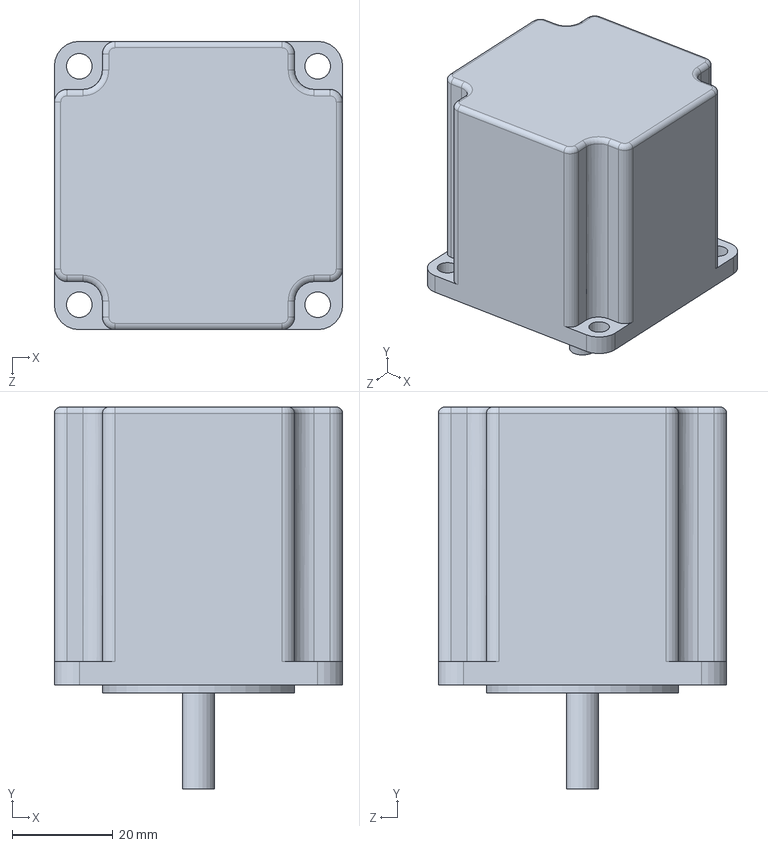
[picture p103: CAD file, 2013-12-04]
Pre-2016/Arm/Commercial Parts/Stepper 23055.SLDPRT
57.1 x 75.7 x 57.1 mm
