ISU-MAVRIC/MAVRIC_Hardware/Pre-2016/Arm/Commercial Parts/Turn Table/Turn Table Bottom.SLDPRT

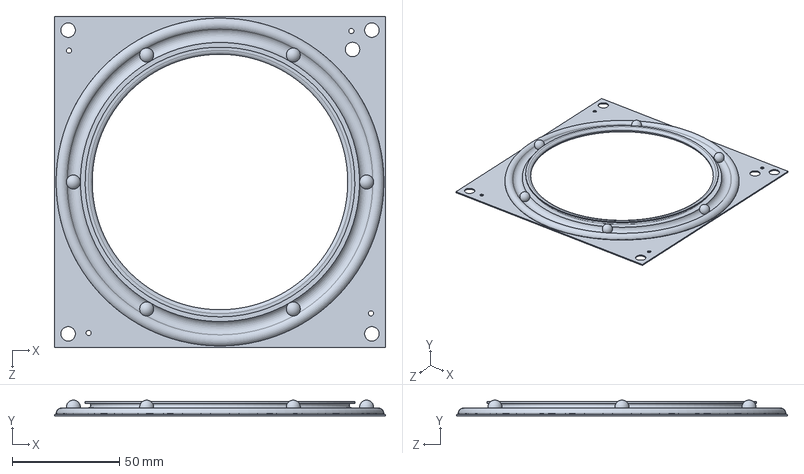
[picture p104: CAD file, 2014-04-17]
Pre-2016/Arm/Commercial Parts/Turn Table/Turn Table Bottom.SLDPRT
154.0 x 7.34 x 154.0 mm
