ISU-MAVRIC/MAVRIC_Hardware/Pre-2016/Chassis/Chassis 1 (Box Chassis)/Covers/Composite/Chassis Top Right Composite.SLDPRT

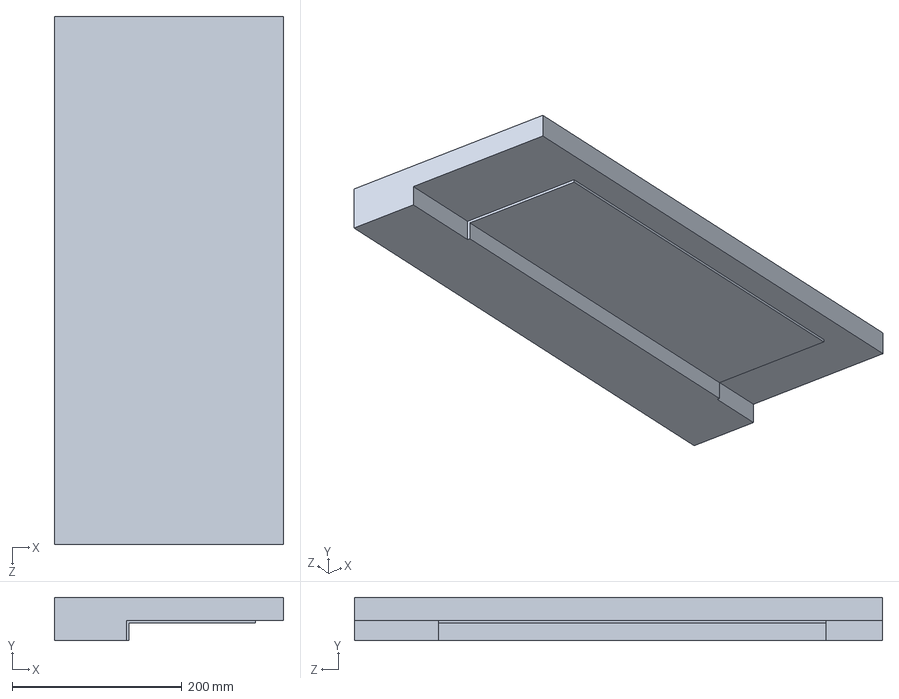
[picture p105: CAD file, 2014-04-26]
Pre-2016/Chassis/Chassis 1 (Box Chassis)/Covers/Composite/Chassis Top Right Composite.SLDPRT
270.3 x 50.8 x 623.0 mm
