ISU-MAVRIC/MAVRIC_Hardware/Pre-2016/Chassis/Chassis 1 (Box Chassis)/Covers/Metal/Chassis cover Bottom.SLDPRT

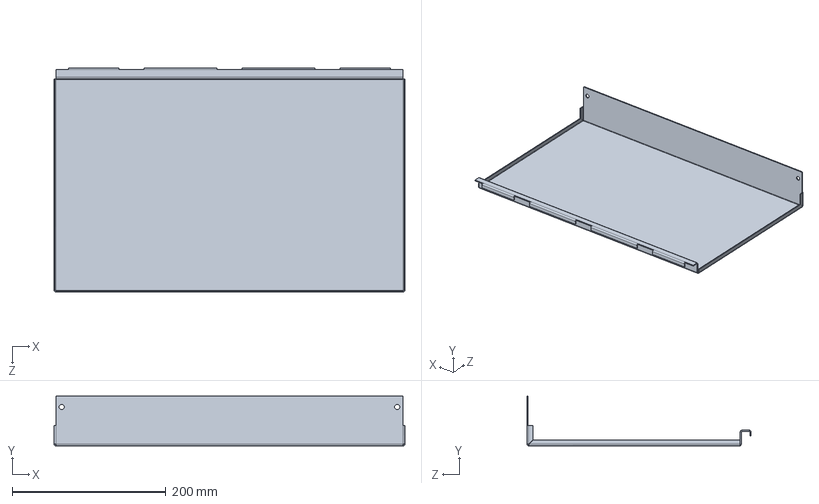
[picture p107: CAD file, 2014-03-08]
Pre-2016/Chassis/Chassis 1 (Box Chassis)/Covers/Metal/Chassis cover Bottom.SLDPRT
457.2 x 65.1 x 292.0 mm
