ISU-MAVRIC/MAVRIC_Hardware/Pre-2016/Chassis/Chassis 1 (Box Chassis)/Diff/Diff Bar.SLDPRT

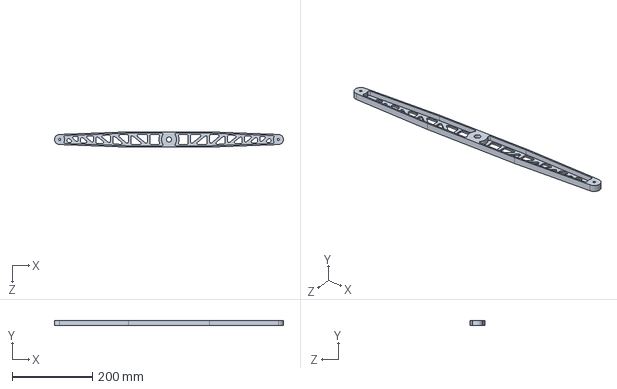
[picture p108: CAD file, 2014-01-11]
Pre-2016/Chassis/Chassis 1 (Box Chassis)/Diff/Diff Bar.SLDPRT
571.5 x 12.7 x 38.1 mm
