ISU-MAVRIC/MAVRIC_Hardware/Pre-2016/End Effector/Servo Assembly Components/bracket1-2.SLDPRT

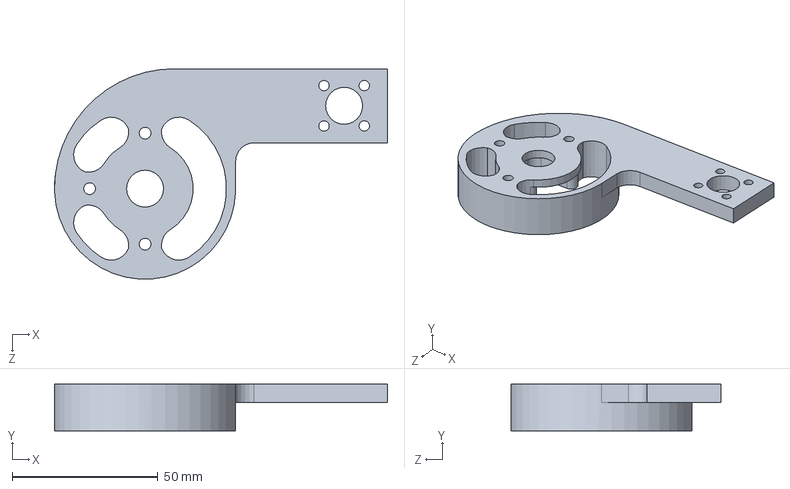
[picture p109: CAD file, 2014-04-15]
Pre-2016/End Effector/Servo Assembly Components/bracket1-2.SLDPRT
114.3 x 16.0 x 72.2 mm
