ISU-MAVRIC/MAVRIC_Hardware/Pre-2016/End Effector/Servo Brackets and Test Servo/Test Servo.SLDPRT

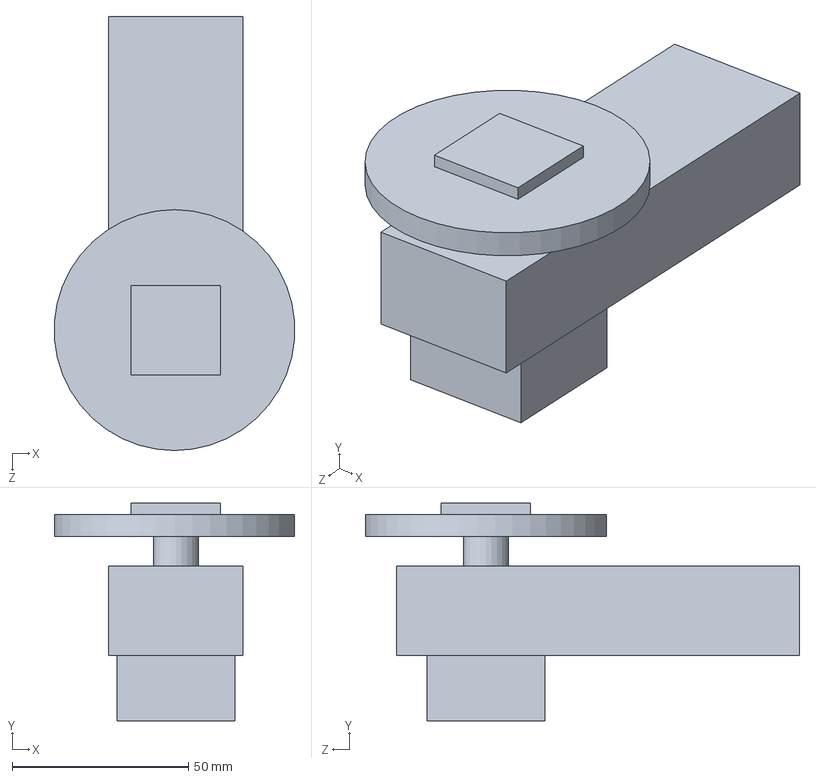
[picture p110: CAD file, 2014-02-13]
Pre-2016/End Effector/Servo Brackets and Test Servo/Test Servo.SLDPRT
68.1 x 61.7 x 123.0 mm
