ISU-MAVRIC/MAVRIC_Hardware/Pre-2016/Payload/Commercial Parts/Large Payload.SLDPRT

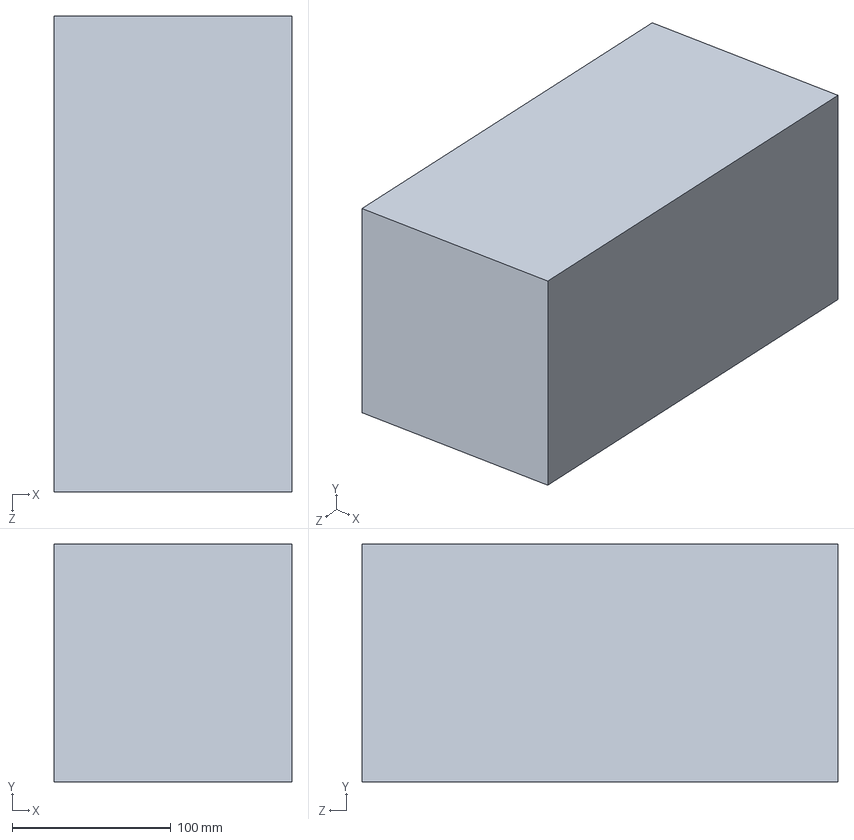
[picture p111: CAD file, 2013-12-05]
Pre-2016/Payload/Commercial Parts/Large Payload.SLDPRT
150.0 x 150.0 x 300.0 mm
