ISU-MAVRIC/MAVRIC_Hardware/Pre-2016/Soil Sample Tool/Bucket.SLDPRT

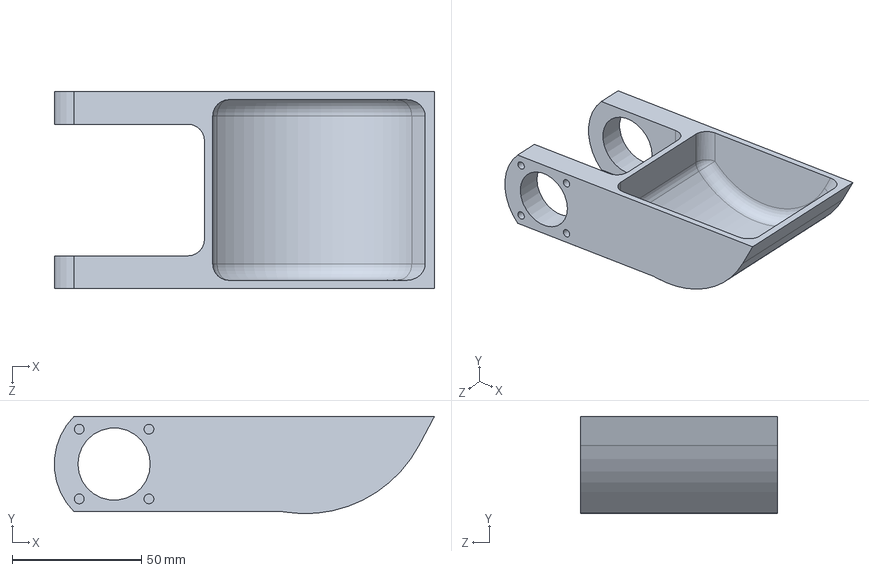
[picture p112: CAD file, 2014-02-13]
Pre-2016/Soil Sample Tool/Bucket.SLDPRT
146.9 x 37.6 x 76.2 mm
