ISU-MAVRIC/MAVRIC_Hardware/Pre-2016/Suspension/Fixturing/Hole Fixturing Plate.SLDPRT

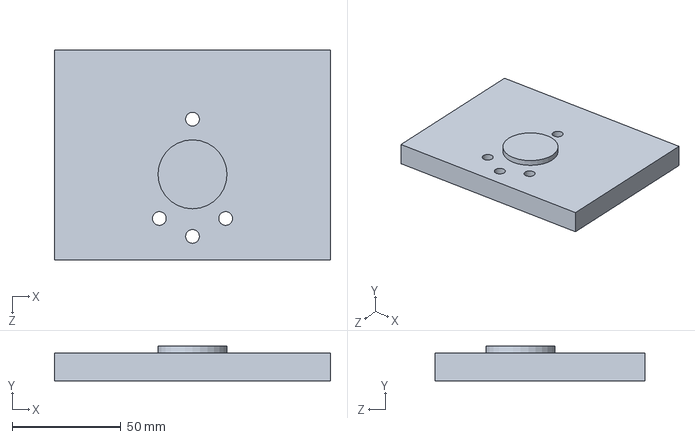
[picture p113: CAD file, 2014-01-03]
Pre-2016/Suspension/Fixturing/Hole Fixturing Plate.SLDPRT
127.0 x 15.9 x 96.5 mm
