ISU-MAVRIC/MAVRIC_Hardware/Pre-2016/Wheel Pod/Commercial/P60_64_Gearbox.SLDPRT

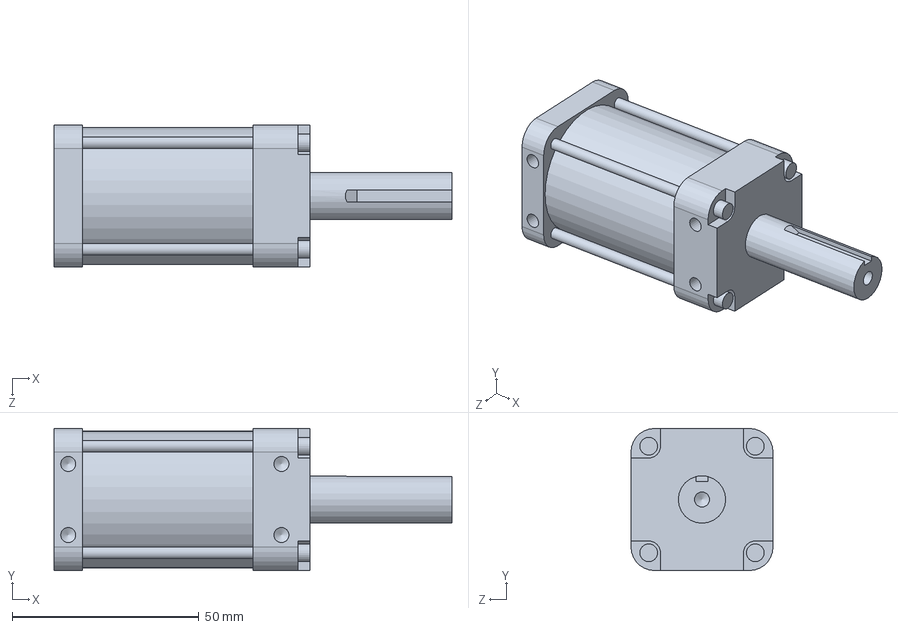
[picture p114: CAD file, 2014-01-15]
Pre-2016/Wheel Pod/Commercial/P60_64_Gearbox.SLDPRT
106.7 x 38.1 x 38.1 mm
