ISU-MAVRIC/MAVRIC_Hardware/Pre-2016/Arm/Arm Design 2013-2014/upper arm 2014.SLDPRT

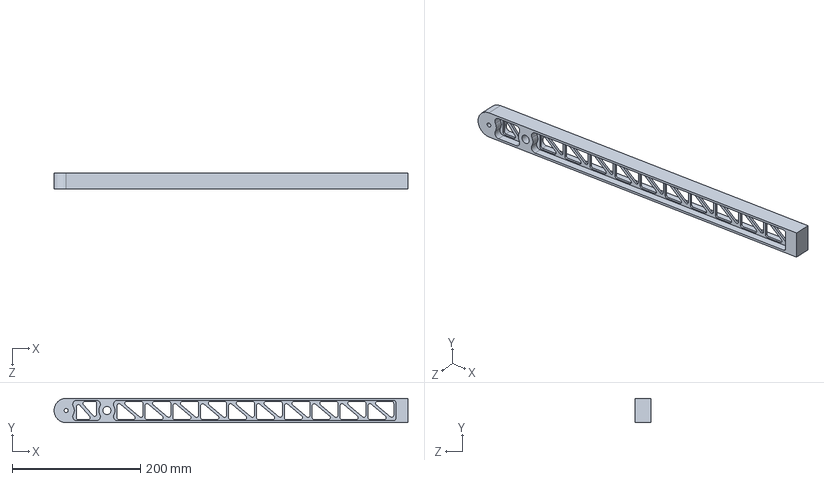
[picture p115: CAD file, 2014-04-26]
Pre-2016/Arm/Arm Design 2013-2014/upper arm 2014.SLDPRT
552.5 x 38.1 x 25.4 mm
