ISU-MAVRIC/MAVRIC_Hardware/Pre-2016/Arm/Commercial Parts/Turn Table/Turn Table Top.SLDPRT

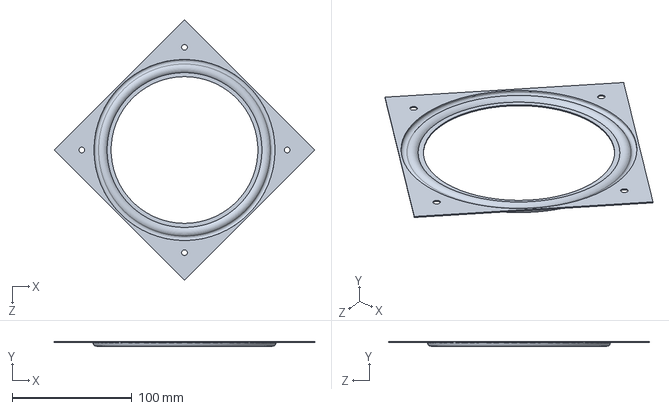
[picture p116: CAD file, 2014-01-10]
Pre-2016/Arm/Commercial Parts/Turn Table/Turn Table Top.SLDPRT
217.8 x 3.78 x 217.8 mm
