ISU-MAVRIC/MAVRIC_Hardware/Pre-2016/Chassis/Chassis 1 (Box Chassis)/Covers/Composite/Fiberglass Bottom Covers.SLDPRT

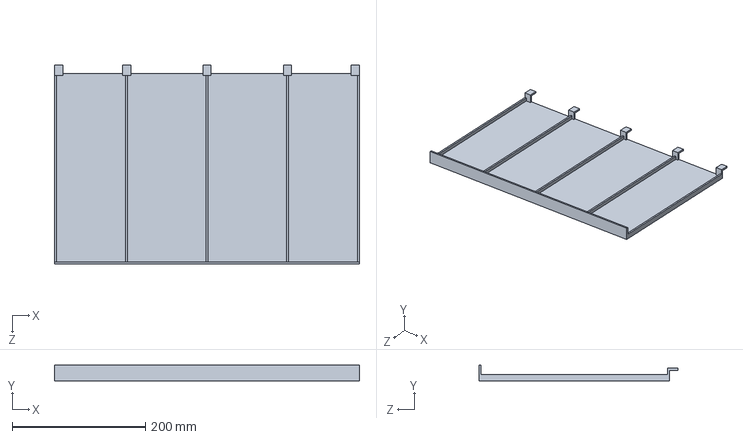
[picture p117: CAD file, 2014-04-26]
Pre-2016/Chassis/Chassis 1 (Box Chassis)/Covers/Composite/Fiberglass Bottom Covers.SLDPRT
457.2 x 23.8 x 298.4 mm
