ISU-MAVRIC/MAVRIC_Hardware/Pre-2016/Chassis/Chassis 1 (Box Chassis)/Covers/Composite/Molds/Bottom Cover Mold.SLDPRT

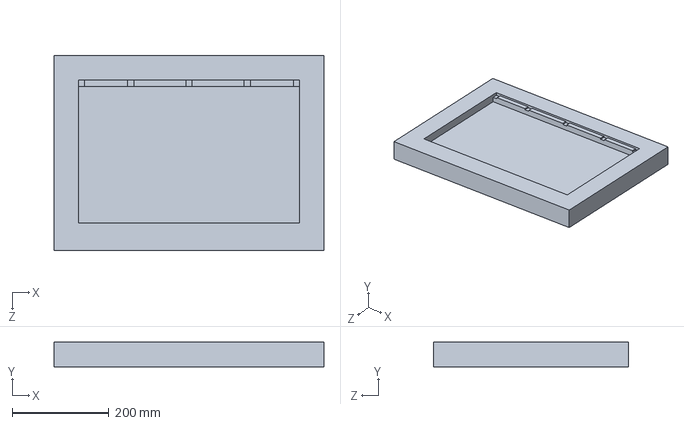
[picture p118: CAD file, 2014-03-27]
Pre-2016/Chassis/Chassis 1 (Box Chassis)/Covers/Composite/Molds/Bottom Cover Mold.SLDPRT
558.8 x 50.8 x 403.2 mm
