ISU-MAVRIC/MAVRIC_Hardware/Pre-2016/Chassis/Chassis 1 (Box Chassis)/Covers/Metal/Chassis Center cover.SLDPRT

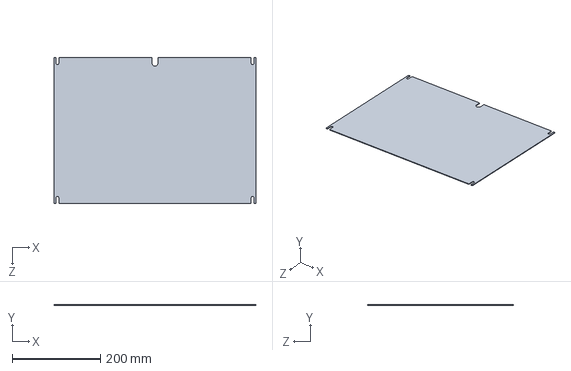
[picture p119: CAD file, 2014-03-08]
Pre-2016/Chassis/Chassis 1 (Box Chassis)/Covers/Metal/Chassis Center cover.SLDPRT
457.2 x 1.59 x 330.2 mm
