ISU-MAVRIC/MAVRIC_Hardware/Pre-2016/Chassis/Chassis 1 (Box Chassis)/Diff/Diff Link.SLDPRT

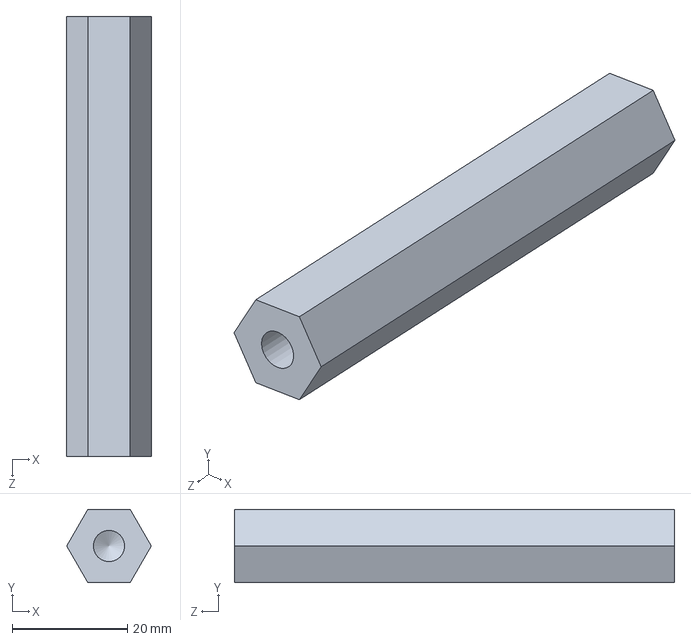
[picture p120: CAD file, 2013-11-26]
Pre-2016/Chassis/Chassis 1 (Box Chassis)/Diff/Diff Link.SLDPRT
14.7 x 12.7 x 76.2 mm
