ISU-MAVRIC/MAVRIC_Hardware/Pre-2016/Electrical/Stepper Driver.SLDPRT

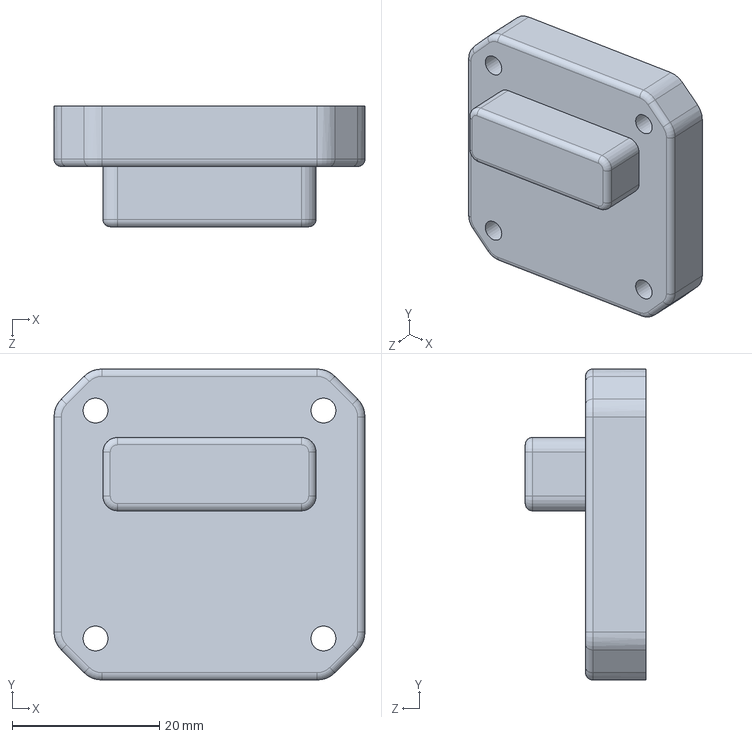
[picture p121: CAD file, 2013-11-26]
Pre-2016/Electrical/Stepper Driver.SLDPRT
42.3 x 42.3 x 16.4 mm
