ISU-MAVRIC/MAVRIC_Hardware/Pre-2016/End Effector/Servo Assembly Components/bracket2-3.SLDPRT

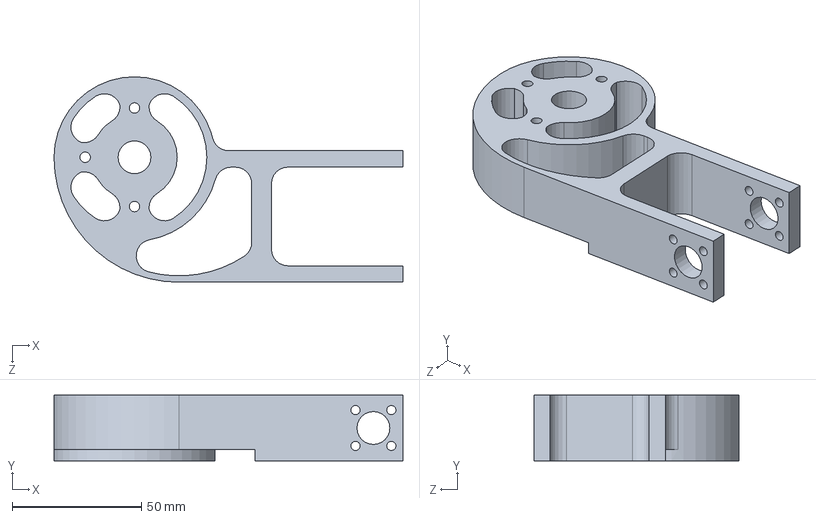
[picture p122: CAD file, 2014-04-15]
Pre-2016/End Effector/Servo Assembly Components/bracket2-3.SLDPRT
134.8 x 25.4 x 79.3 mm
