ISU-MAVRIC/MAVRIC_Hardware/Pre-2016/End Effector/Servo Brackets and Test Servo/U bracket.SLDPRT

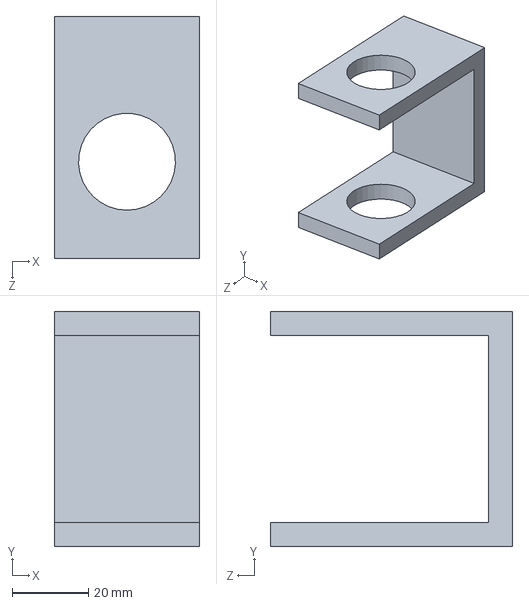
[picture p123: CAD file, 2014-02-13]
Pre-2016/End Effector/Servo Brackets and Test Servo/U bracket.SLDPRT
38.1 x 61.6 x 63.5 mm
