ISU-MAVRIC/MAVRIC_Hardware/Pre-2016/Payload/Payload Support Clip.SLDPRT

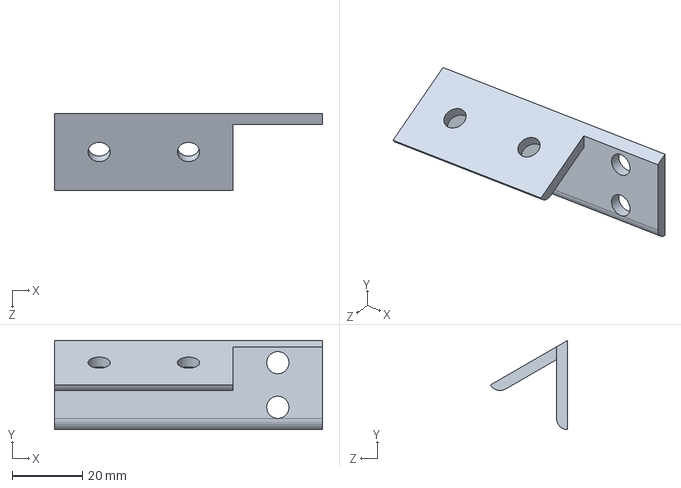
[picture p124: CAD file, 2013-12-05]
Pre-2016/Payload/Payload Support Clip.SLDPRT
76.2 x 25.4 x 22.0 mm
