ISU-MAVRIC/MAVRIC_Hardware/Pre-2016/Soil Sample Tool/fixturing plate.SLDPRT

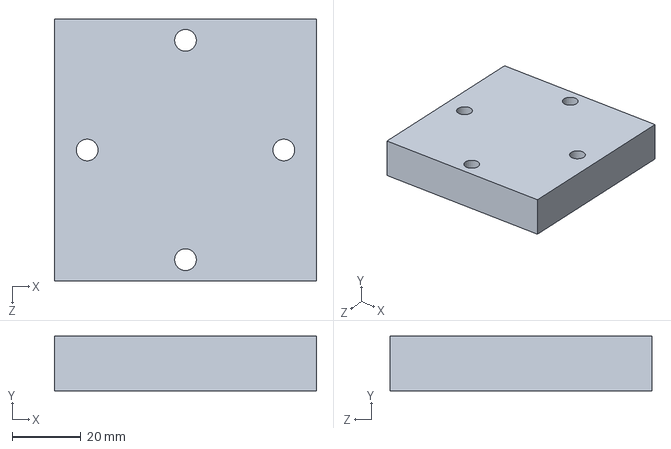
[picture p125: CAD file, 2014-01-09]
Pre-2016/Soil Sample Tool/fixturing plate.SLDPRT
76.2 x 15.9 x 76.2 mm
