ISU-MAVRIC/MAVRIC_Hardware/Pre-2016/Steering Gearbox/Commercial/Stepper 23079.SLDPRT

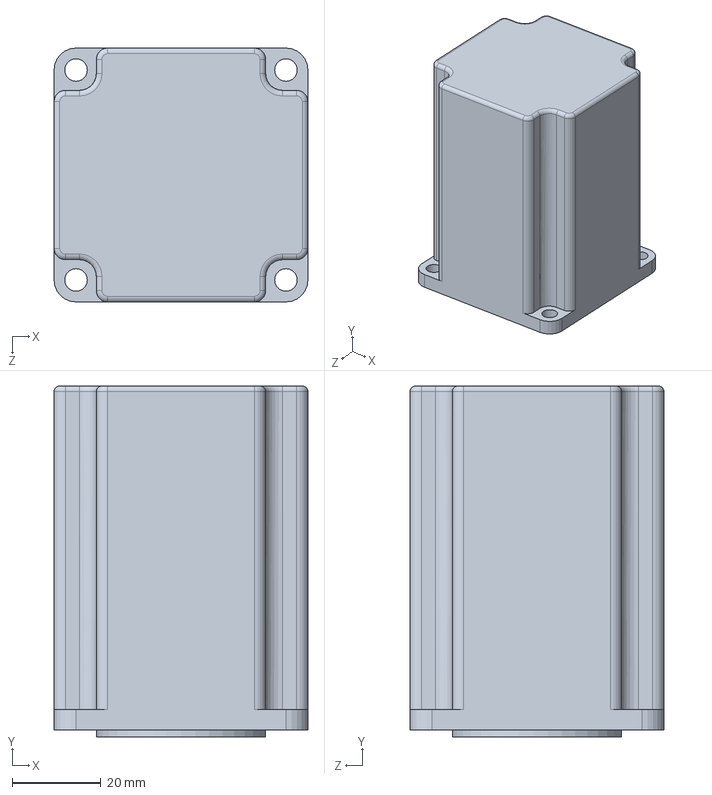
[picture p126: CAD file, 2013-10-17]
Pre-2016/Steering Gearbox/Commercial/Stepper 23079.SLDPRT
57.1 x 79.0 x 57.1 mm
