ISU-MAVRIC/MAVRIC_Hardware/Pre-2016/Steering Gearbox/Dual Stage Output Disk.SLDPRT

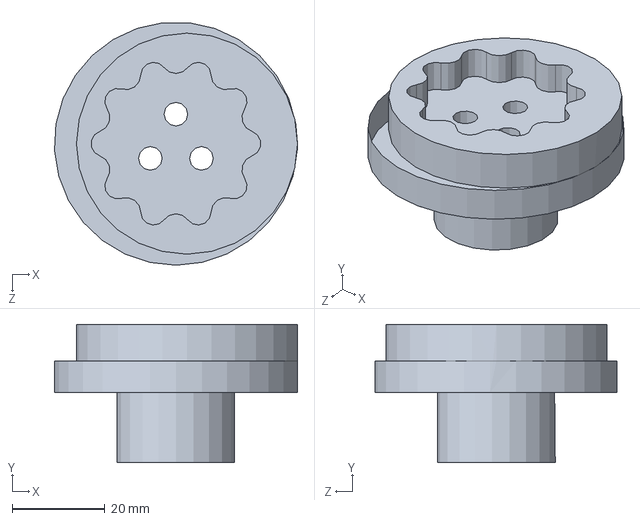
[picture p127: CAD file, 2014-02-13]
Pre-2016/Steering Gearbox/Dual Stage Output Disk.SLDPRT
52.3 x 29.8 x 52.2 mm
