ISU-MAVRIC/MAVRIC_Hardware/Pre-2016/Wheel Pod/Commercial/RS555 Motor.SLDPRT

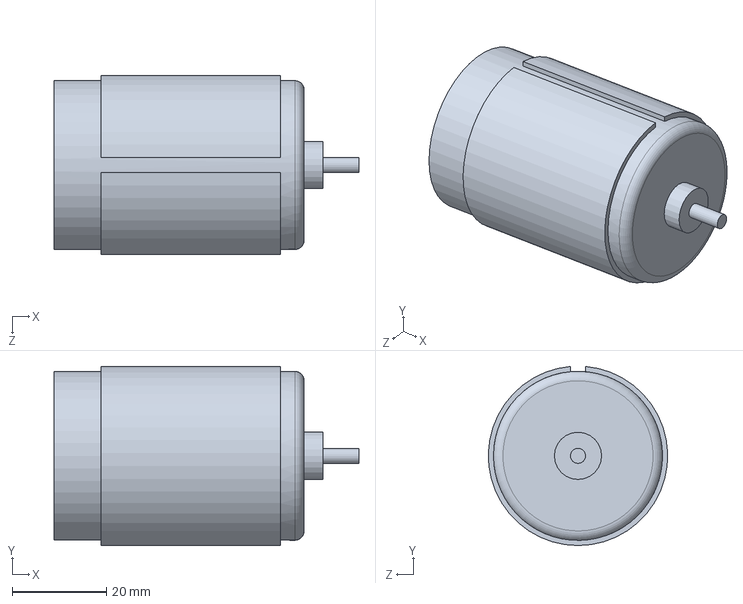
[picture p128: CAD file, 2013-11-06]
Pre-2016/Wheel Pod/Commercial/RS555 Motor.SLDPRT
64.6 x 37.9 x 38.0 mm
