ISU-MAVRIC/MAVRIC_Hardware/Pre-2016/Wheel Pod/Drop Plate.SLDPRT

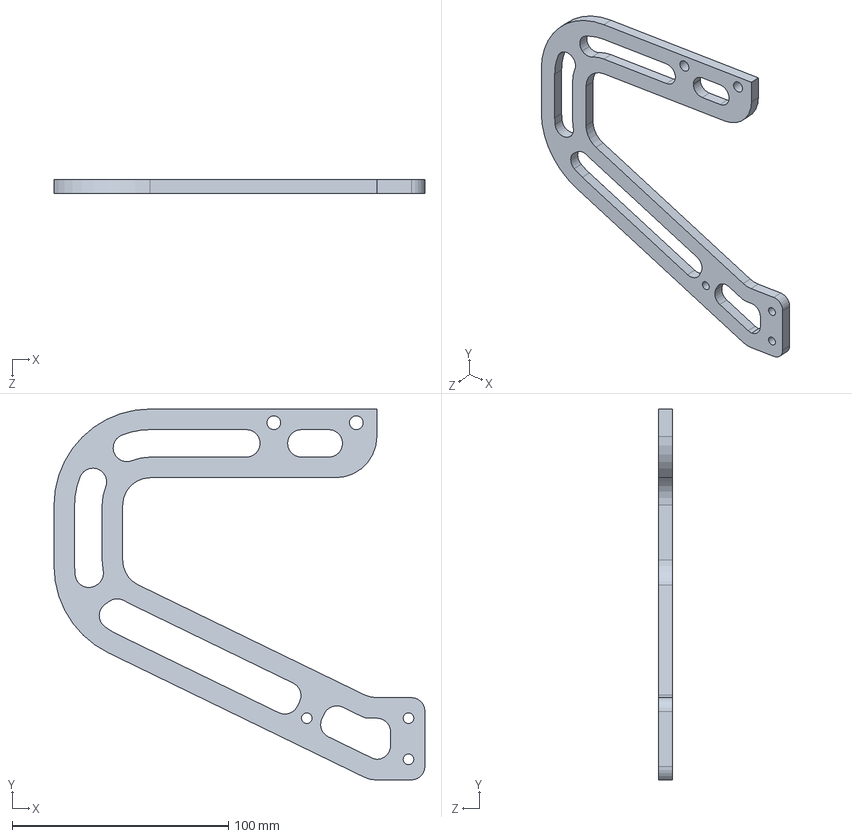
[picture p129: CAD file, 2014-01-15]
Pre-2016/Wheel Pod/Drop Plate.SLDPRT
171.4 x 171.4 x 6.35 mm
