ISU-MAVRIC/MAVRIC_Hardware/Pre-2016/Wheel Pod/Wheel Testing/The Ground.SLDPRT

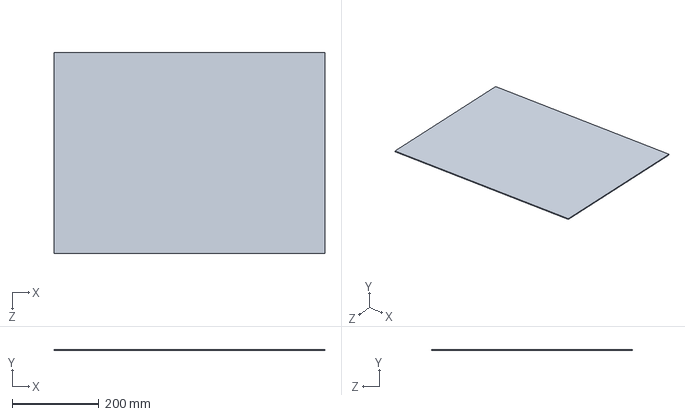
[picture p130: CAD file, 2013-11-02]
Pre-2016/Wheel Pod/Wheel Testing/The Ground.SLDPRT
625.5 x 2.54 x 464.9 mm
