ISU-MAVRIC/MAVRIC_Hardware/Pre-2016/Arm/Arm Design 2012-2013/Lower Arm.SLDPRT

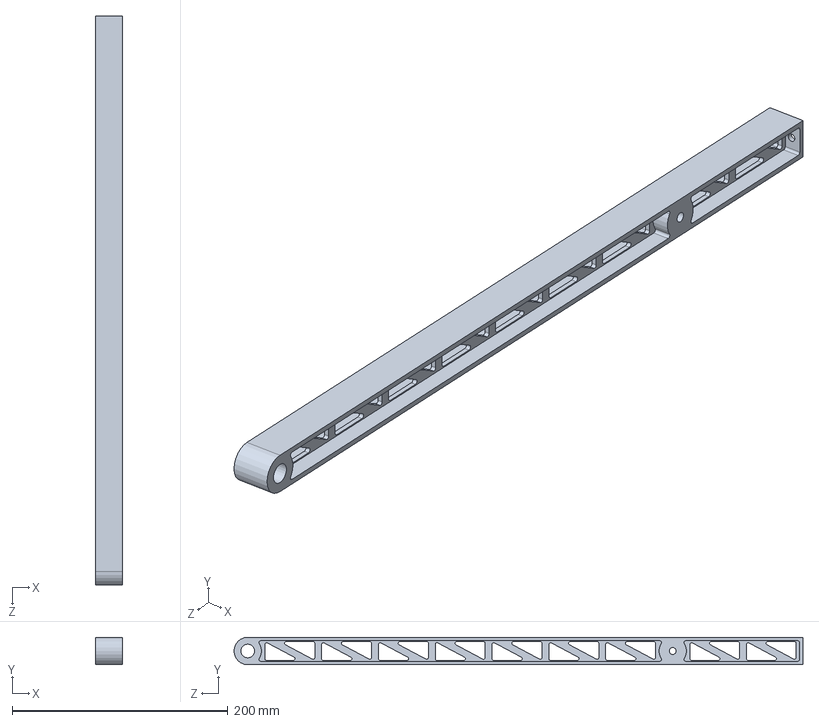
[picture p131: CAD file, 2014-01-06]
Pre-2016/Arm/Arm Design 2012-2013/Lower Arm.SLDPRT
25.4 x 25.4 x 527.0 mm
