ISU-MAVRIC/MAVRIC_Hardware/Pre-2016/Arm/Arm Design 2013-2014/lower actuator mount.SLDPRT

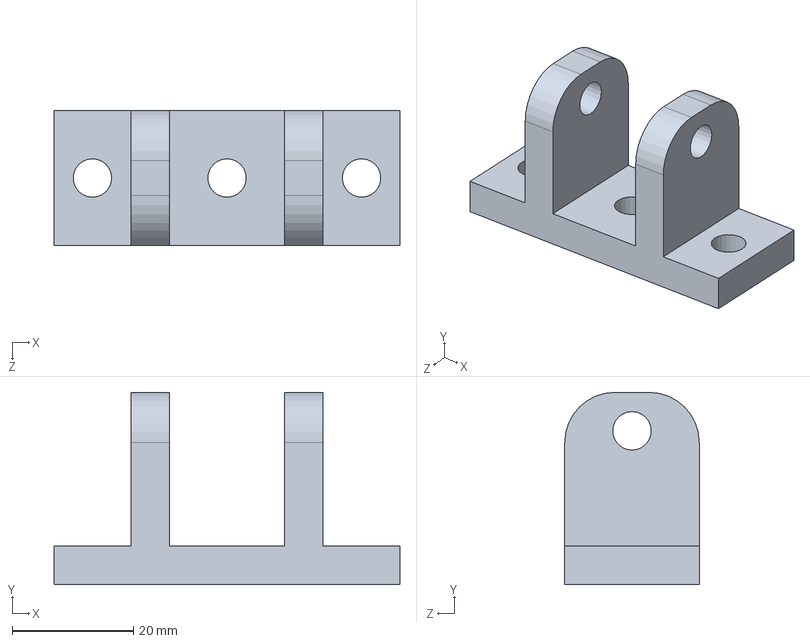
[picture p132: CAD file, 2014-04-26]
Pre-2016/Arm/Arm Design 2013-2014/lower actuator mount.SLDPRT
57.1 x 31.8 x 22.2 mm
