ISU-MAVRIC/MAVRIC_Hardware/Pre-2016/Arm/Commercial Parts/Firgelli Linear/Firgelli Extension.SLDPRT

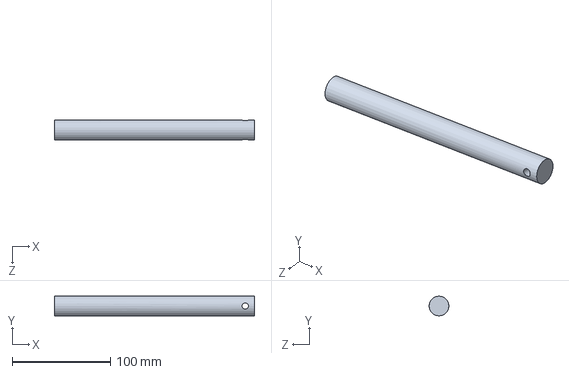
[picture p133: CAD file, 2013-12-04]
Pre-2016/Arm/Commercial Parts/Firgelli Linear/Firgelli Extension.SLDPRT
203.2 x 20.1 x 20.1 mm
