ISU-MAVRIC/MAVRIC_Hardware/Pre-2016/Camera/Camera Fixture.SLDPRT

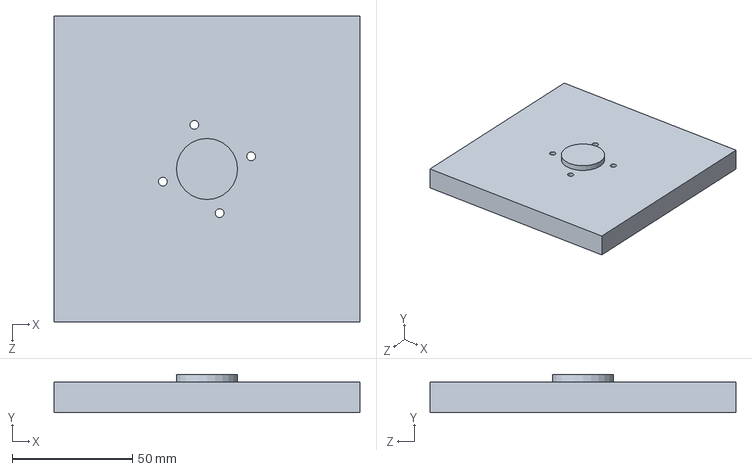
[picture p134: CAD file, 2014-02-20]
Pre-2016/Camera/Camera Fixture.SLDPRT
127.0 x 15.9 x 127.0 mm
