ISU-MAVRIC/MAVRIC_Hardware/Pre-2016/Chassis/Chassis 1 (Box Chassis)/Covers/Composite/Center composite panel.SLDPRT

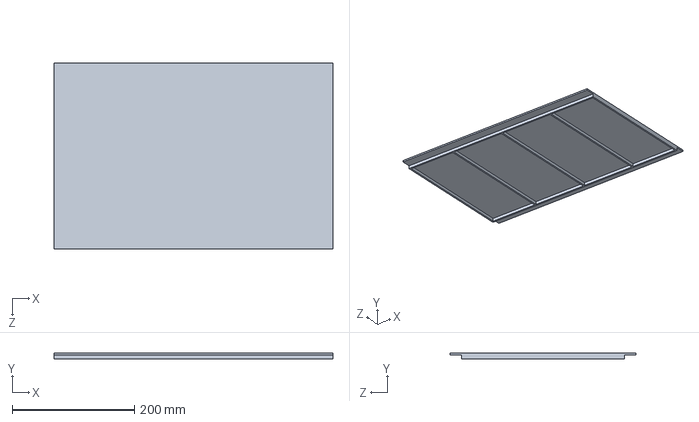
[picture p135: CAD file, 2014-04-26]
Pre-2016/Chassis/Chassis 1 (Box Chassis)/Covers/Composite/Center composite panel.SLDPRT
457.2 x 9.52 x 304.8 mm
