ISU-MAVRIC/MAVRIC_Hardware/Pre-2016/Chassis/Chassis 1 (Box Chassis)/Covers/Metal/Top Front Cover panel.SLDPRT

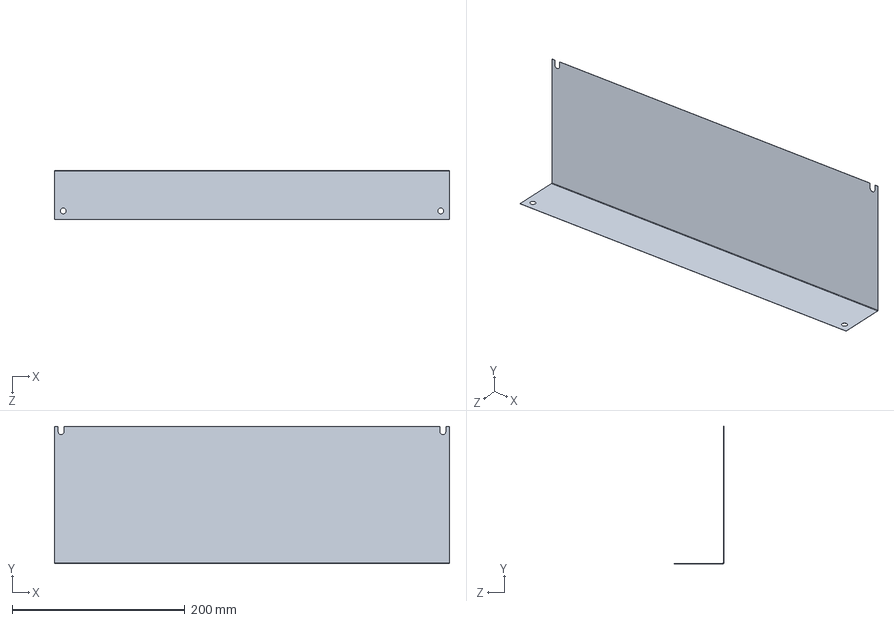
[picture p136: CAD file, 2014-03-08]
Pre-2016/Chassis/Chassis 1 (Box Chassis)/Covers/Metal/Top Front Cover panel.SLDPRT
457.2 x 158.9 x 57.1 mm
