ISU-MAVRIC/MAVRIC_Hardware/Pre-2016/Chassis/Chassis 1 (Box Chassis)/Major components/Cross Bar.SLDPRT

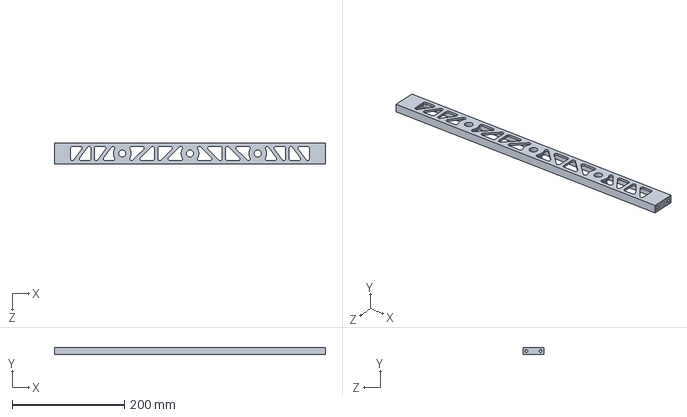
[picture p137: CAD file, 2014-04-17]
Pre-2016/Chassis/Chassis 1 (Box Chassis)/Major components/Cross Bar.SLDPRT
482.6 x 12.7 x 38.1 mm
