ISU-MAVRIC/MAVRIC_Hardware/Pre-2016/Electrical/Video Antenna.SLDPRT

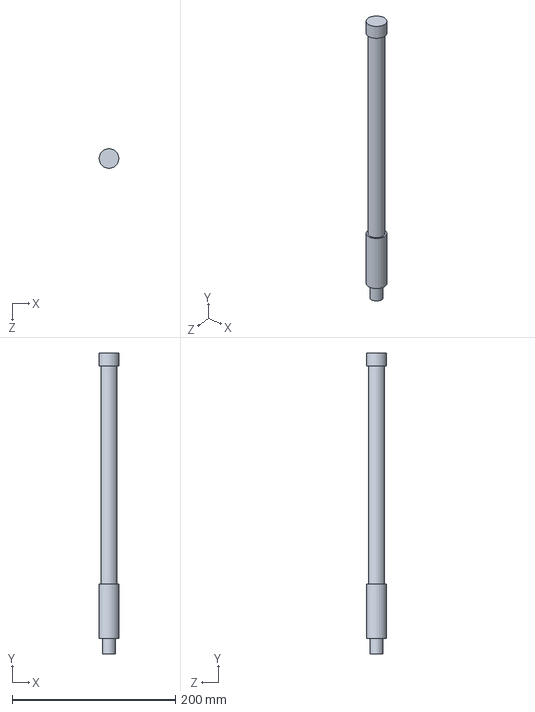
[picture p138: CAD file, 2013-11-26]
Pre-2016/Electrical/Video Antenna.SLDPRT
24.1 x 368.3 x 24.1 mm
