ISU-MAVRIC/MAVRIC_Hardware/Pre-2016/End Effector/Servo Brackets and Test Servo/L bracket.SLDPRT

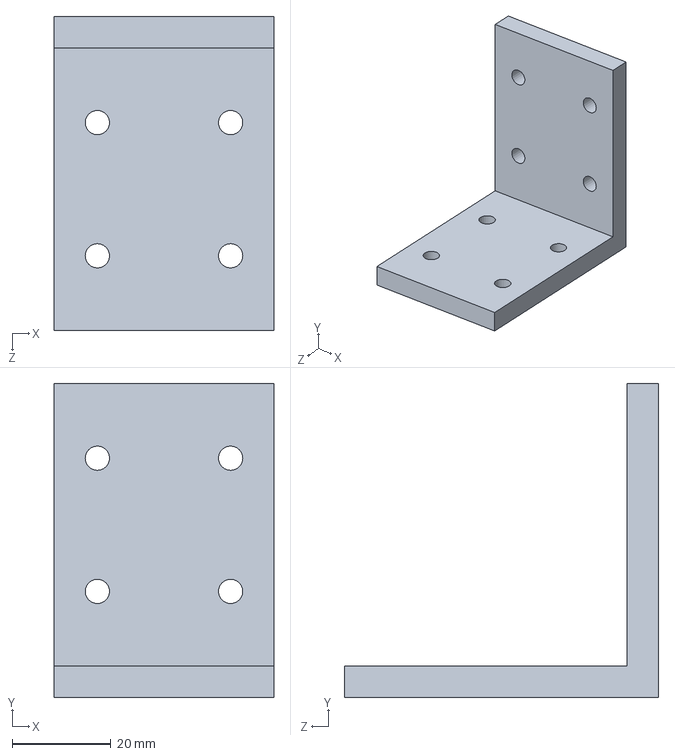
[picture p139: CAD file, 2014-02-13]
Pre-2016/End Effector/Servo Brackets and Test Servo/L bracket.SLDPRT
44.5 x 63.5 x 63.5 mm
