ISU-MAVRIC/MAVRIC_Hardware/Pre-2016/Payload/Payload Cross Member.SLDPRT

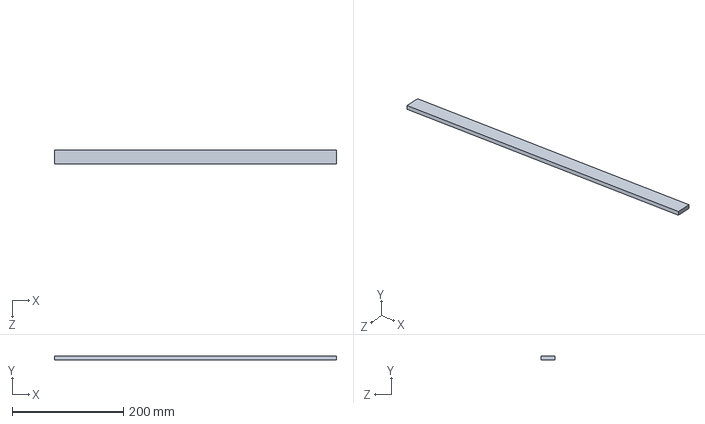
[picture p140: CAD file, 2013-12-05]
Pre-2016/Payload/Payload Cross Member.SLDPRT
508.0 x 6.35 x 25.4 mm
