ISU-MAVRIC/MAVRIC_Hardware/Pre-2016/Steering Gearbox/Second Stage Cycloidal Profile.SLDPRT

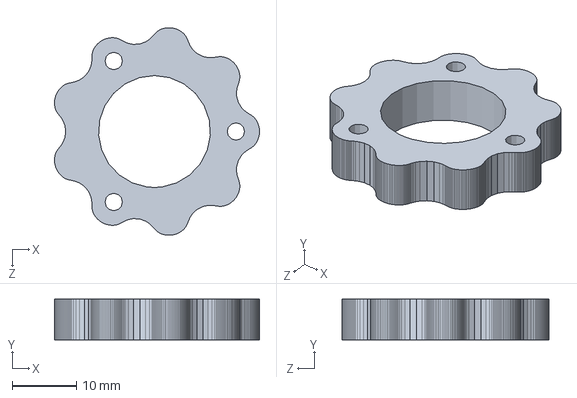
[picture p141: CAD file, 2014-02-13]
Pre-2016/Steering Gearbox/Second Stage Cycloidal Profile.SLDPRT
32.0 x 6.35 x 32.4 mm
