ISU-MAVRIC/MAVRIC_Hardware/Pre-2016/Suspension/Diff Yoke.SLDPRT

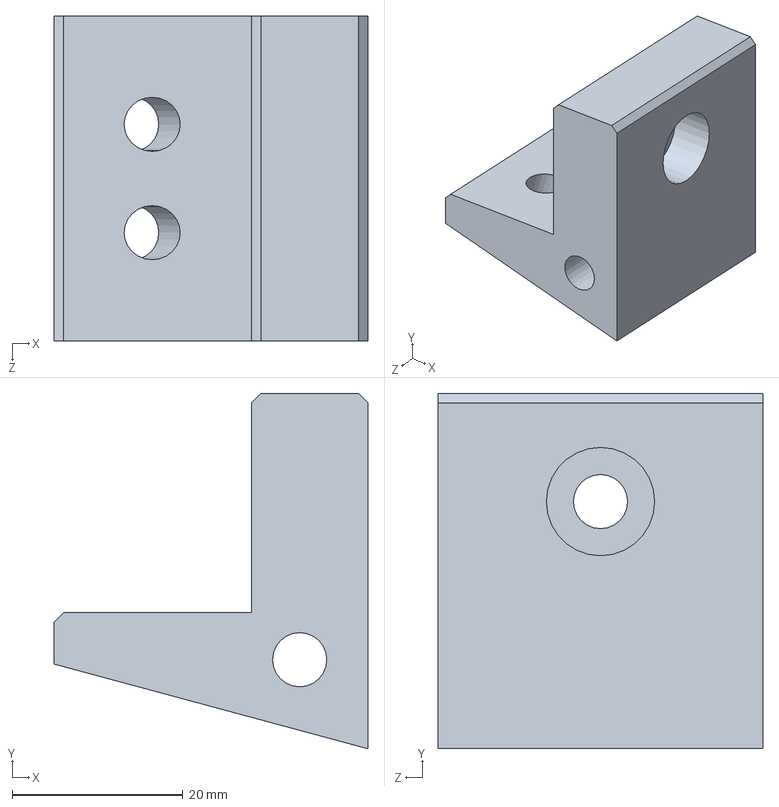
[picture p142: CAD file, 2014-03-04]
Pre-2016/Suspension/Diff Yoke.SLDPRT
36.8 x 41.7 x 38.1 mm
