ISU-MAVRIC/MAVRIC_Hardware/Pre-2016/Suspension/Fixturing/Wheel Joint Hole Plate.SLDPRT

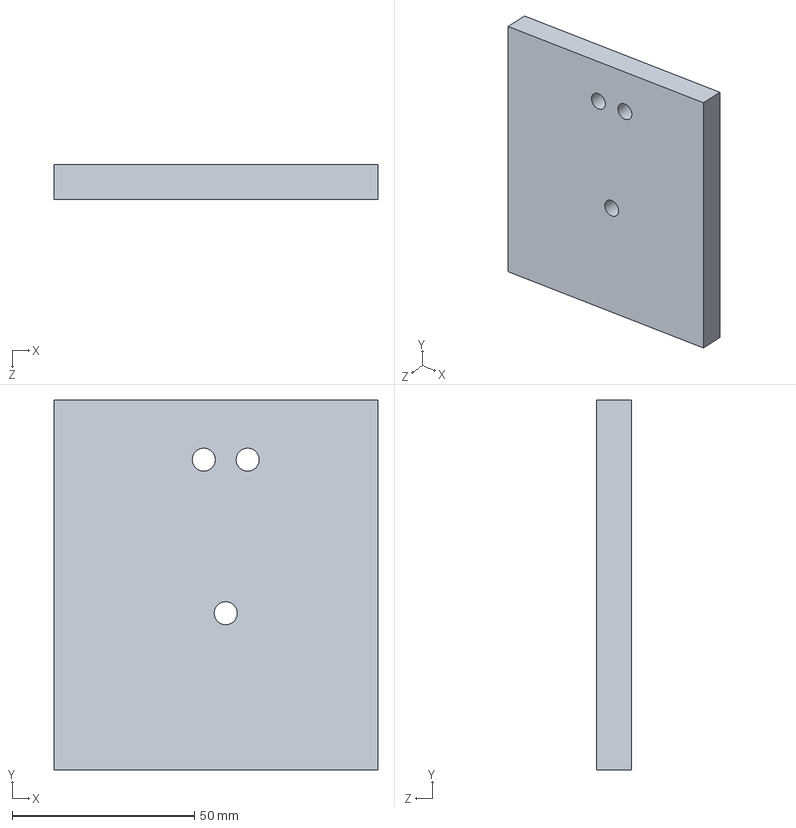
[picture p143: CAD file, 2014-01-03]
Pre-2016/Suspension/Fixturing/Wheel Joint Hole Plate.SLDPRT
88.9 x 101.6 x 9.53 mm
