ISU-MAVRIC/MAVRIC_Hardware/Pre-2016/Wheel Pod/Steering Top Plate.SLDPRT

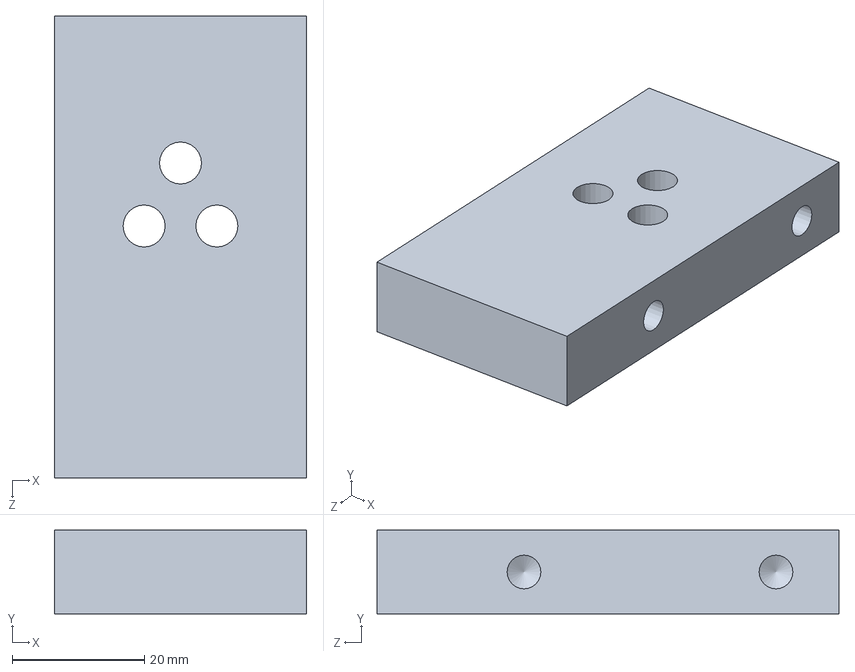
[picture p144: CAD file, 2014-01-06]
Pre-2016/Wheel Pod/Steering Top Plate.SLDPRT
38.1 x 12.7 x 69.8 mm
