ISU-MAVRIC/MAVRIC_Hardware/Pre-2016/Arm/Arm Design 2012-2013/Upper Arm.SLDPRT

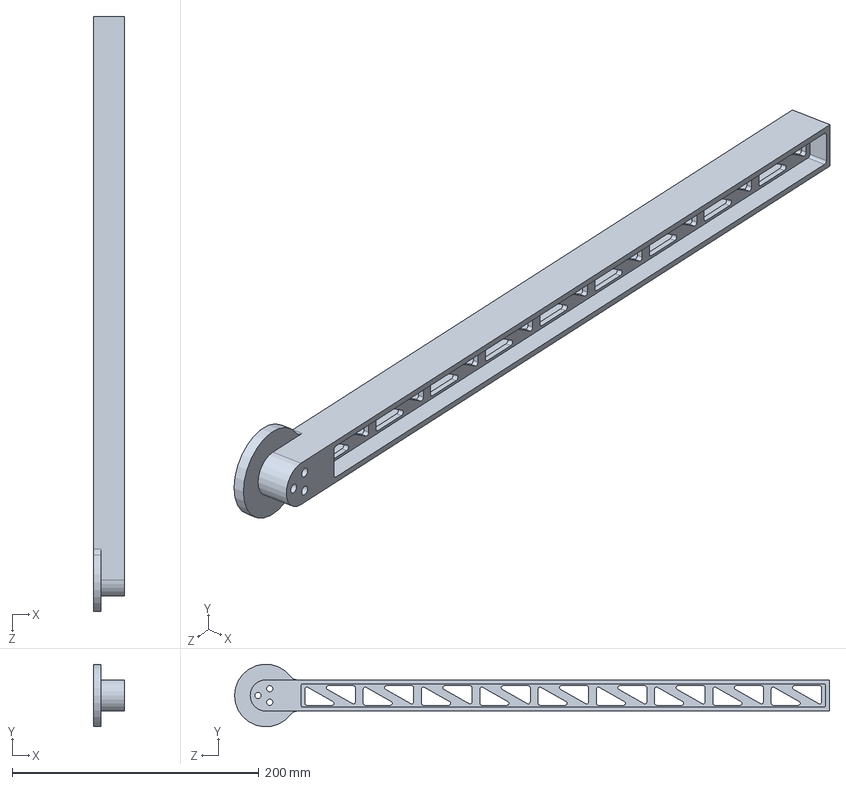
[picture p145: CAD file, 2014-01-06]
Pre-2016/Arm/Arm Design 2012-2013/Upper Arm.SLDPRT
25.4 x 50.7 x 482.6 mm
