ISU-MAVRIC/MAVRIC_Hardware/Pre-2016/Chassis/Chassis 1 (Box Chassis)/Diff/Diff Bar Axle.SLDPRT

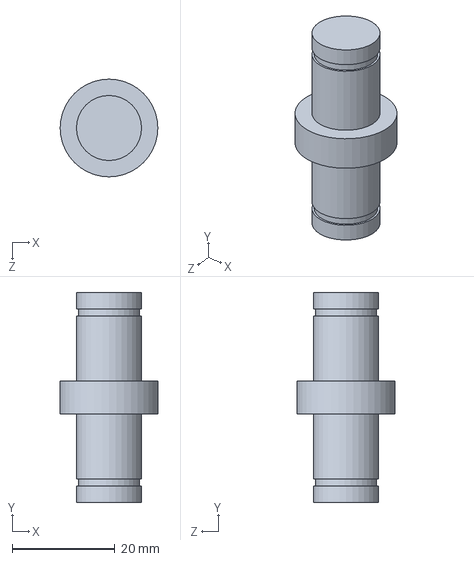
[picture p146: CAD file, 2013-11-14]
Pre-2016/Chassis/Chassis 1 (Box Chassis)/Diff/Diff Bar Axle.SLDPRT
19.1 x 40.9 x 19.1 mm
