ISU-MAVRIC/MAVRIC_Hardware/Pre-2016/Chassis/Chassis 1 (Box Chassis)/Major components/Battery Bracket.SLDPRT

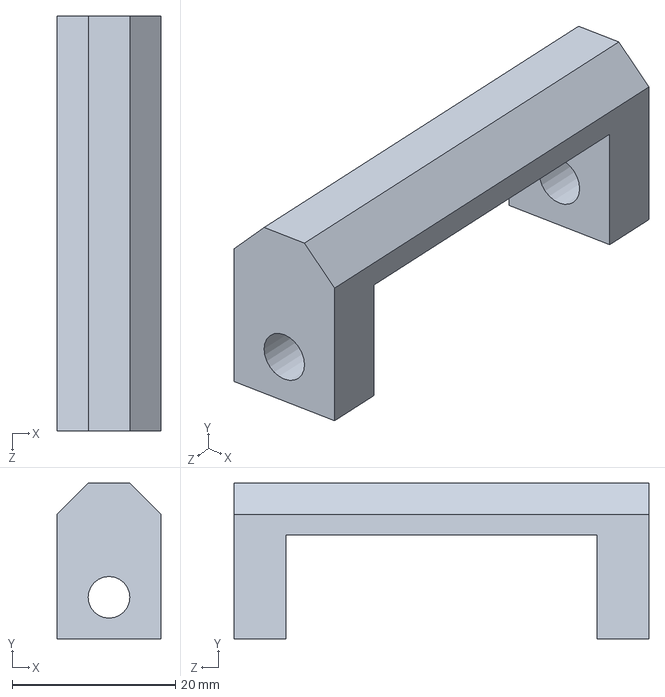
[picture p147: CAD file, 2014-03-08]
Pre-2016/Chassis/Chassis 1 (Box Chassis)/Major components/Battery Bracket.SLDPRT
12.7 x 19.1 x 50.8 mm
