ISU-MAVRIC/MAVRIC_Hardware/Pre-2016/Electrical/Data Antenna.SLDPRT

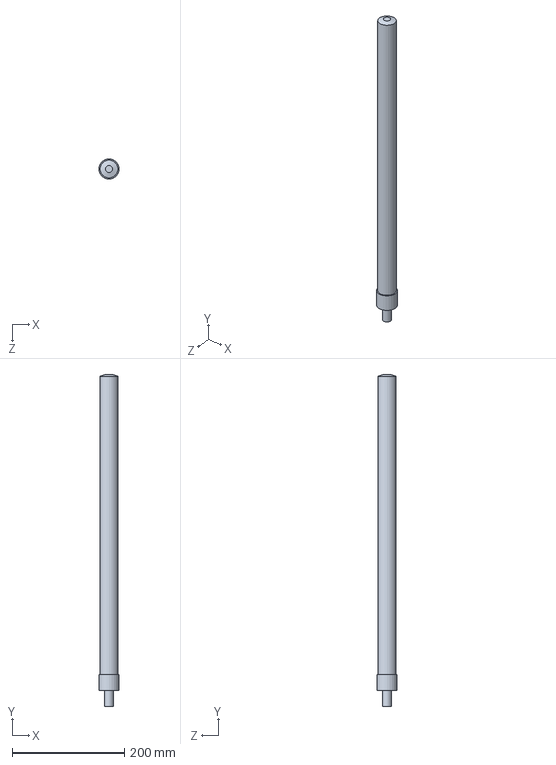
[picture p148: CAD file, 2013-11-26]
Pre-2016/Electrical/Data Antenna.SLDPRT
35.9 x 590.5 x 35.9 mm
