ISU-MAVRIC/MAVRIC_Hardware/Pre-2016/End Effector/Servo Assembly Components/Big Gear Hub.SLDPRT

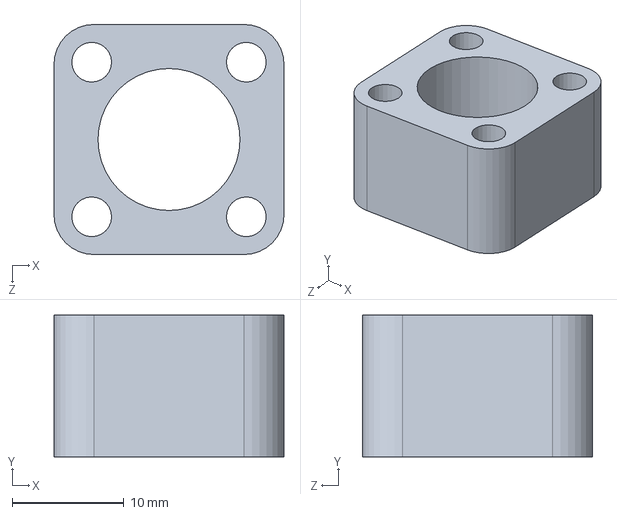
[picture p149: CAD file, 2014-04-10]
Pre-2016/End Effector/Servo Assembly Components/Big Gear Hub.SLDPRT
20.6 x 12.7 x 20.6 mm
