ISU-MAVRIC/MAVRIC_Hardware/Pre-2016/End Effector/Servo Brackets and Test Servo/Servo Bracket.SLDPRT

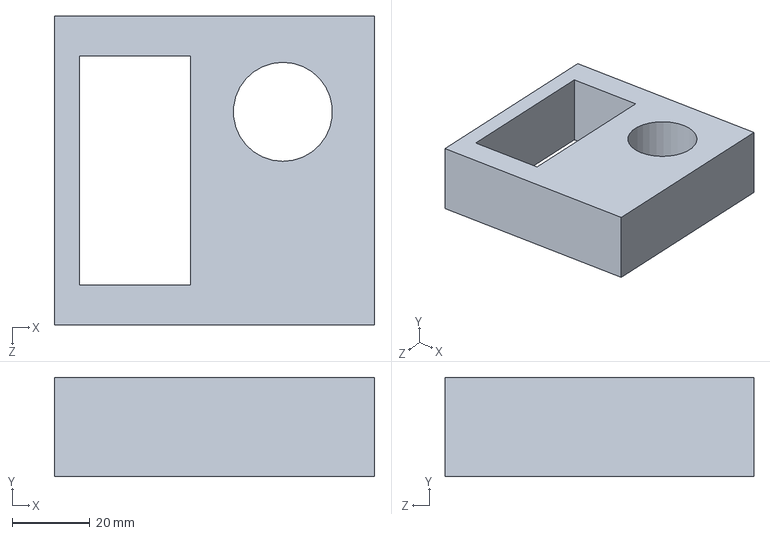
[picture p150: CAD file, 2014-02-13]
Pre-2016/End Effector/Servo Brackets and Test Servo/Servo Bracket.SLDPRT
82.1 x 25.4 x 79.1 mm
