ISU-MAVRIC/MAVRIC_Hardware/Pre-2016/Payload/Payload Bottom Clip.SLDPRT

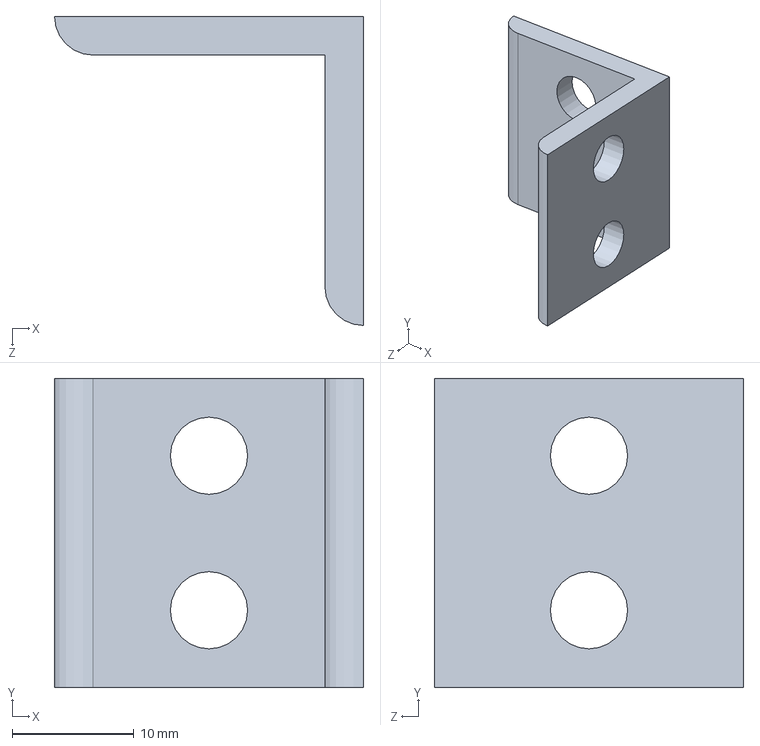
[picture p151: CAD file, 2013-12-05]
Pre-2016/Payload/Payload Bottom Clip.SLDPRT
25.4 x 25.4 x 25.4 mm
