ISU-MAVRIC/MAVRIC_Hardware/Pre-2016/Soil Sample Tool/topfaseningpicenewsoilsample2013.SLDPRT

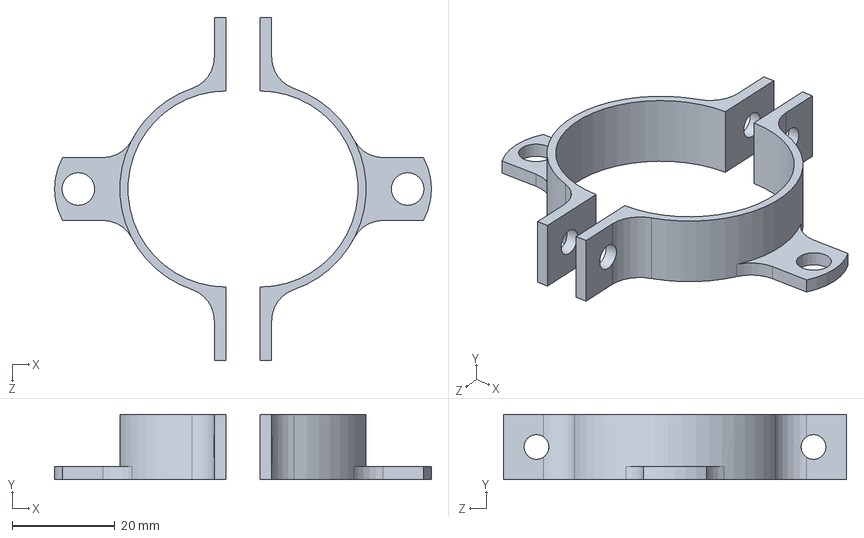
[picture p152: CAD file, 2014-01-09]
Pre-2016/Soil Sample Tool/topfaseningpicenewsoilsample2013.SLDPRT
73.3 x 12.7 x 66.7 mm
