ISU-MAVRIC/MAVRIC_Hardware/Pre-2016/Suspension/Bogie Joint.SLDPRT

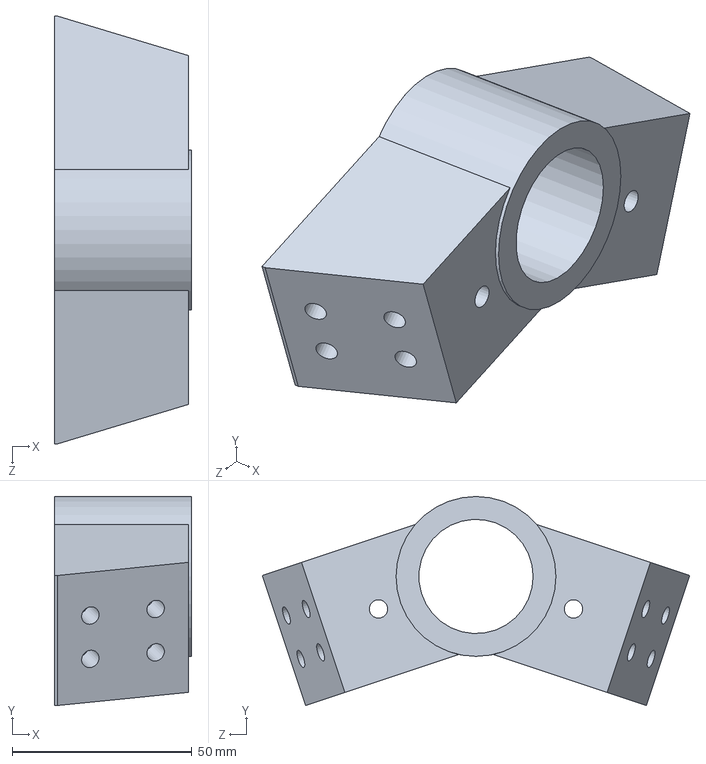
[picture p153: CAD file, 2014-01-09]
Pre-2016/Suspension/Bogie Joint.SLDPRT
38.1 x 58.1 x 118.9 mm
