ISU-MAVRIC/MAVRIC_Hardware/Pre-2016/Arm/Arm Design 2013-2014/lower arm mount.SLDPRT

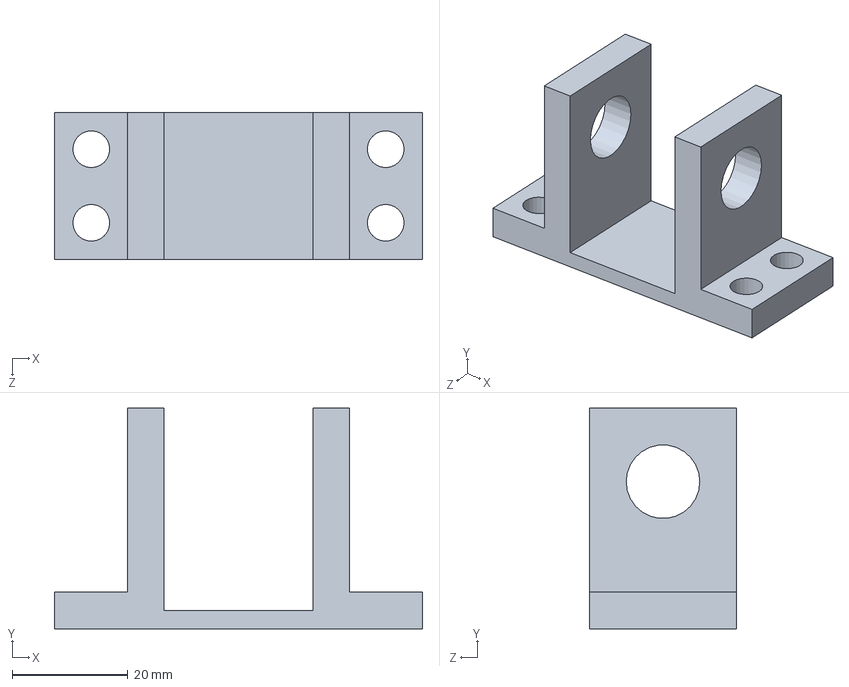
[picture p154: CAD file, 2014-04-26]
Pre-2016/Arm/Arm Design 2013-2014/lower arm mount.SLDPRT
63.5 x 38.1 x 25.4 mm
