ISU-MAVRIC/MAVRIC_Hardware/Pre-2016/Camera/Camera Mount.SLDPRT

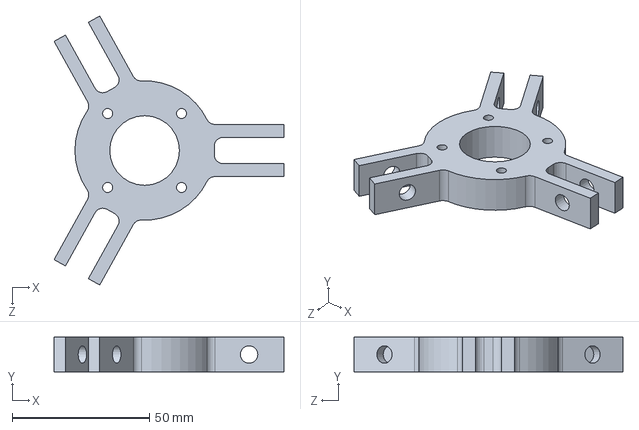
[picture p155: CAD file, 2014-01-08]
Pre-2016/Camera/Camera Mount.SLDPRT
83.8 x 12.7 x 98.1 mm
