ISU-MAVRIC/MAVRIC_Hardware/Pre-2016/Chassis/Chassis 1 (Box Chassis)/Major components/Front Bar.SLDPRT

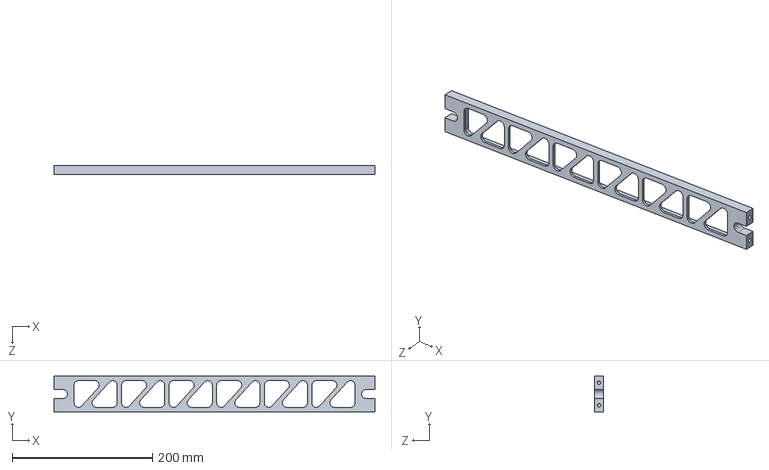
[picture p156: CAD file, 2014-01-11]
Pre-2016/Chassis/Chassis 1 (Box Chassis)/Major components/Front Bar.SLDPRT
457.2 x 50.8 x 12.7 mm
