ISU-MAVRIC/MAVRIC_Hardware/Pre-2016/Electrical/Wheel Driver.SLDPRT

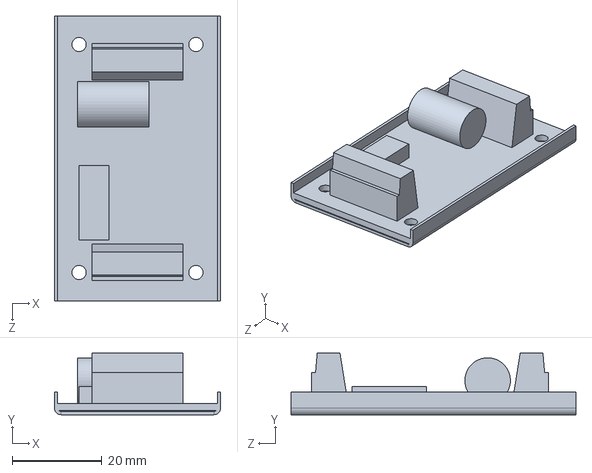
[picture p157: CAD file, 2013-11-25]
Pre-2016/Electrical/Wheel Driver.SLDPRT
37.0 x 13.7 x 63.5 mm
