ISU-MAVRIC/MAVRIC_Hardware/Pre-2016/End Effector/Servo Assembly Components/Big Gear.SLDPRT

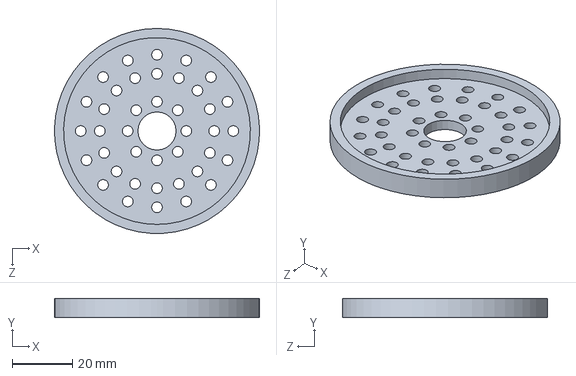
[picture p158: CAD file, 2014-04-08]
Pre-2016/End Effector/Servo Assembly Components/Big Gear.SLDPRT
68.2 x 6.35 x 68.3 mm
