ISU-MAVRIC/MAVRIC_Hardware/Pre-2016/Soil Sample Tool/bottomtabssoilsamplenew2013.SLDPRT

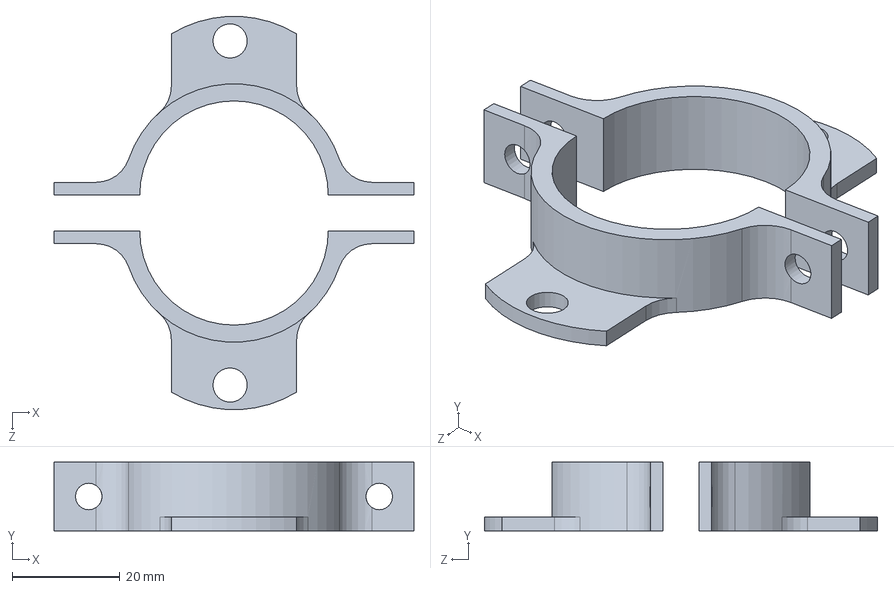
[picture p159: CAD file, 2014-01-09]
Pre-2016/Soil Sample Tool/bottomtabssoilsamplenew2013.SLDPRT
66.7 x 12.7 x 72.8 mm
