ISU-MAVRIC/MAVRIC_Hardware/Pre-2016/Steering Gearbox/First Stage Cycloidal Profile.SLDPRT

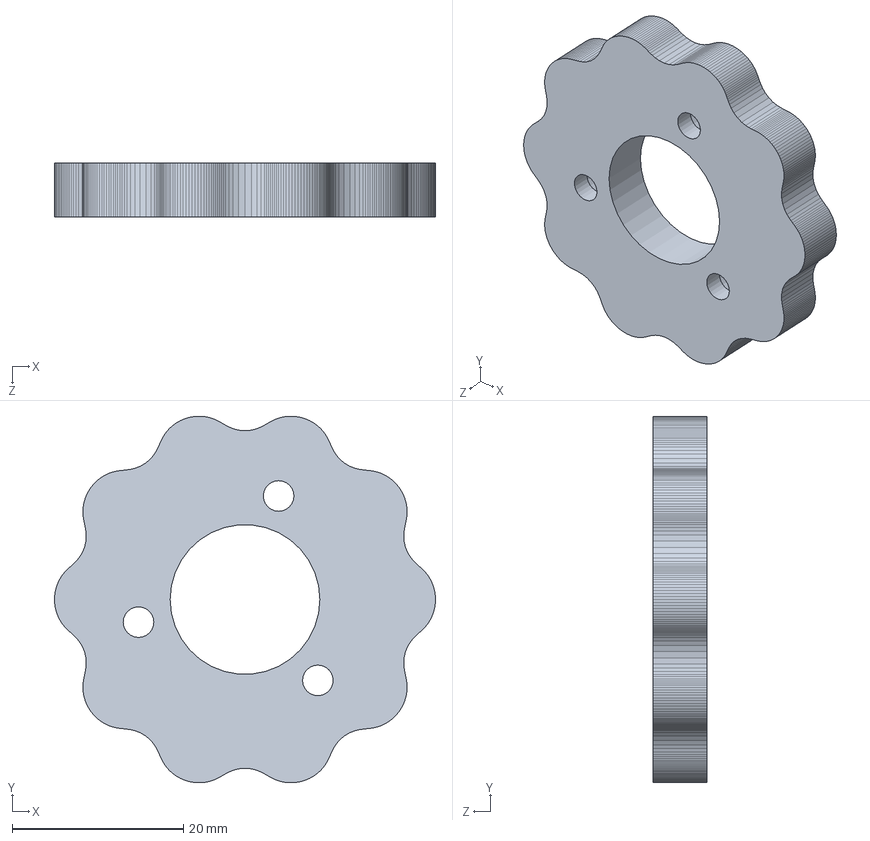
[picture p160: CAD file, 2014-02-13]
Pre-2016/Steering Gearbox/First Stage Cycloidal Profile.SLDPRT
44.5 x 42.8 x 6.35 mm
