ISU-MAVRIC/MAVRIC_Hardware/Pre-2016/Suspension/Fixturing/Yoke Fixture Plate.SLDPRT

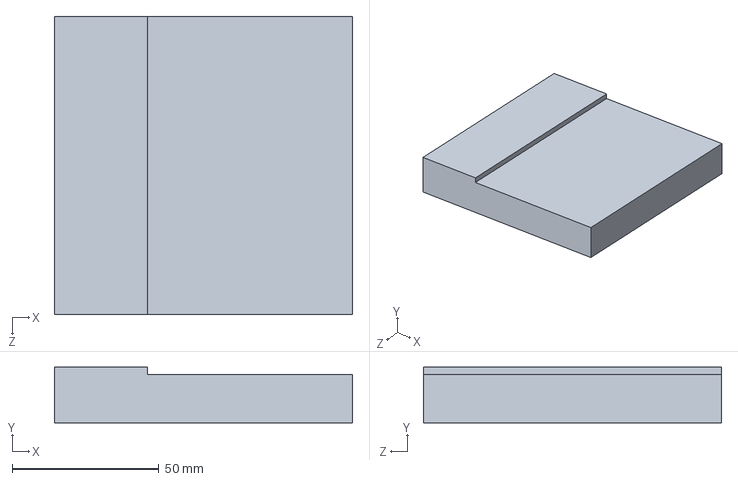
[picture p161: CAD file, 2014-01-03]
Pre-2016/Suspension/Fixturing/Yoke Fixture Plate.SLDPRT
101.6 x 19.1 x 101.6 mm
