ISU-MAVRIC/MAVRIC_Hardware/Pre-2016/Suspension/Wheel Joint.SLDPRT

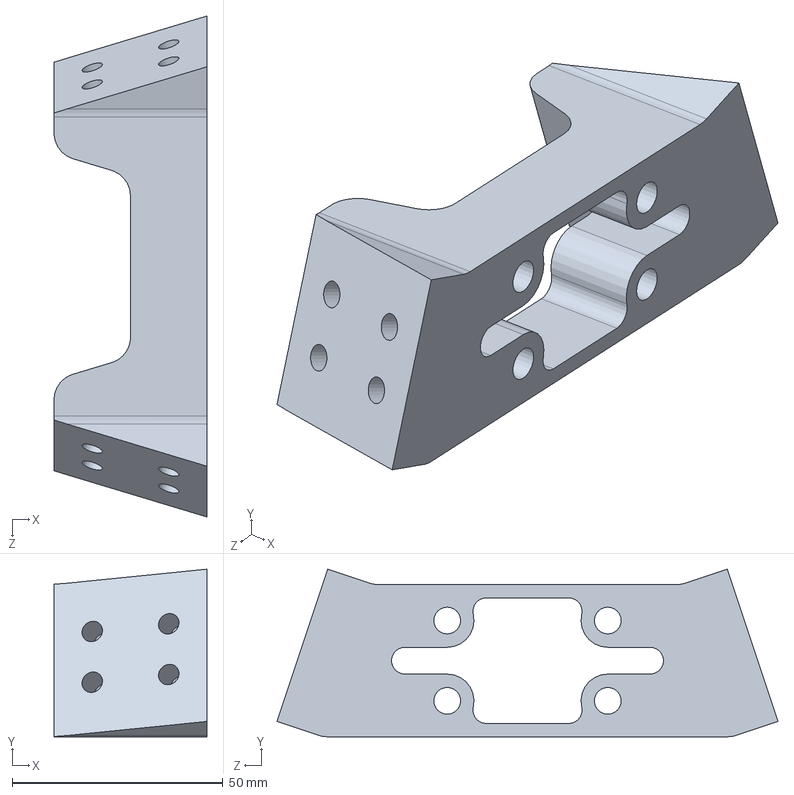
[picture p162: CAD file, 2013-12-13]
Pre-2016/Suspension/Wheel Joint.SLDPRT
36.3 x 39.8 x 118.9 mm
