ISU-MAVRIC/MAVRIC_Hardware/Pre-2016/Wheel Pod/Wheel Fixturing Wedge3.SLDPRT

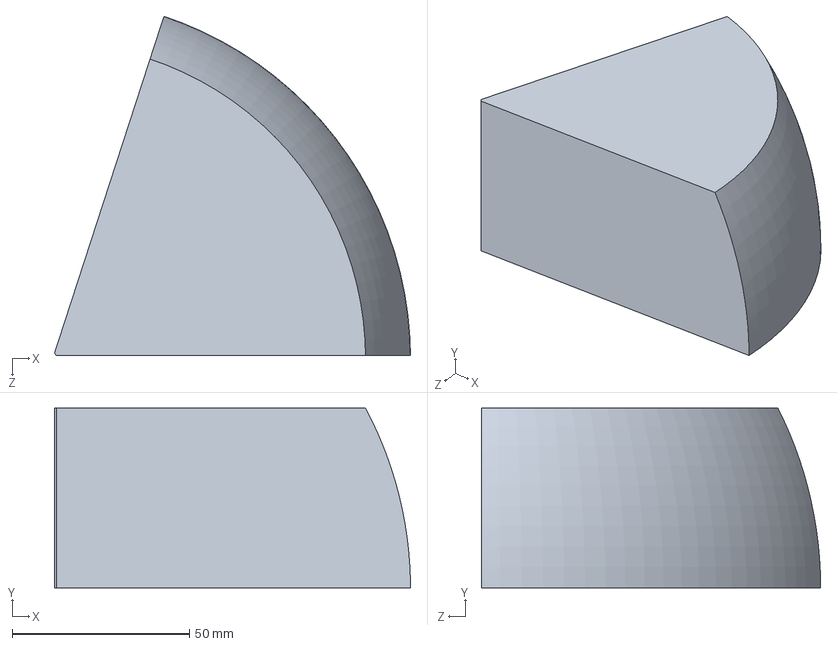
[picture p163: CAD file, 2013-11-14]
Pre-2016/Wheel Pod/Wheel Fixturing Wedge3.SLDPRT
100.5 x 50.8 x 95.8 mm
