ISU-MAVRIC/MAVRIC_Hardware/Pre-2016/Arm/Arm Design 2013-2014/Drive Motor.SLDPRT

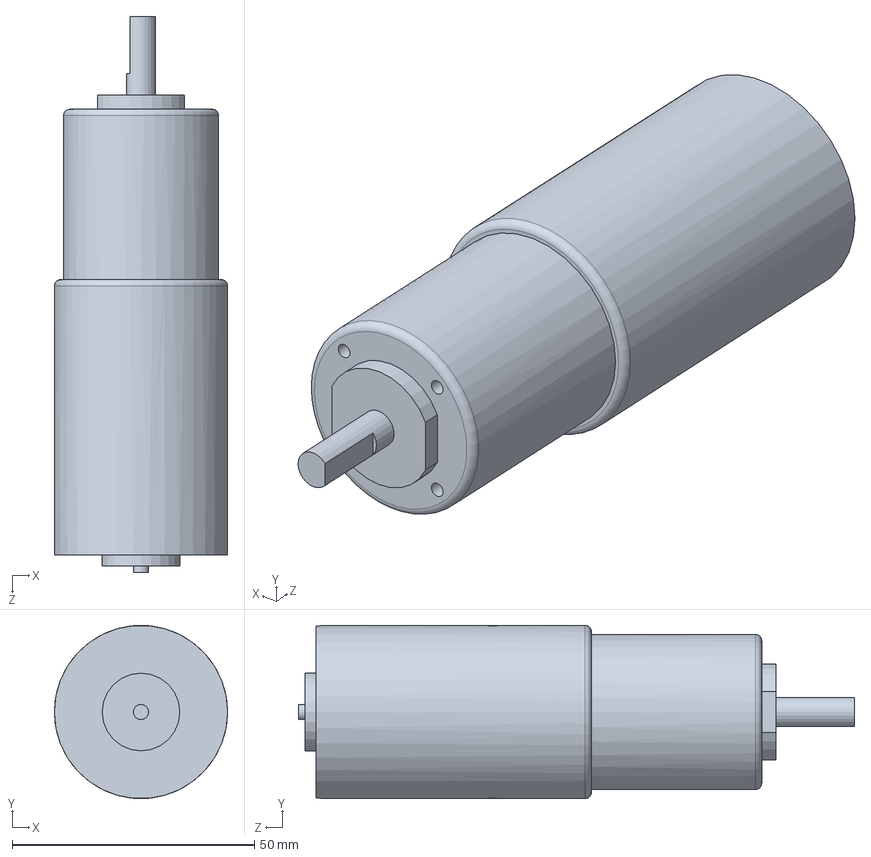
[picture p164: CAD file, 2014-04-26]
Pre-2016/Arm/Arm Design 2013-2014/Drive Motor.SLDPRT
35.7 x 35.7 x 114.7 mm
