ISU-MAVRIC/MAVRIC_Hardware/Pre-2016/Camera/Camera Leg.SLDPRT

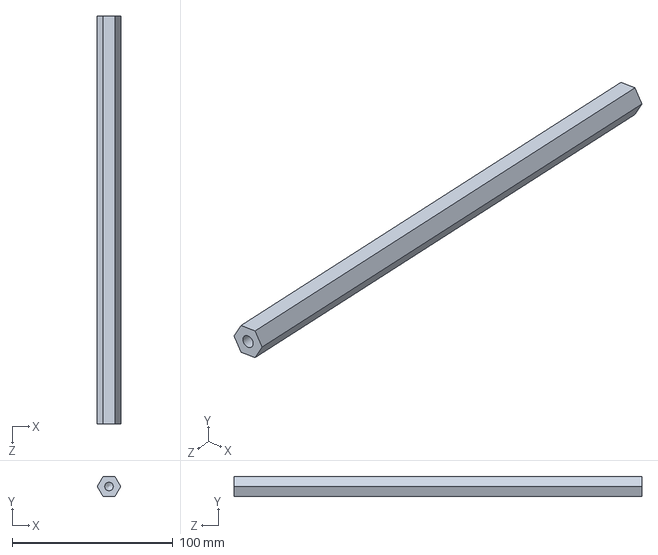
[picture p165: CAD file, 2013-12-05]
Pre-2016/Camera/Camera Leg.SLDPRT
14.7 x 12.7 x 254.0 mm
