ISU-MAVRIC/MAVRIC_Hardware/Pre-2016/Chassis/Chassis 1 (Box Chassis)/Major components/Chassis Side Rail.SLDPRT

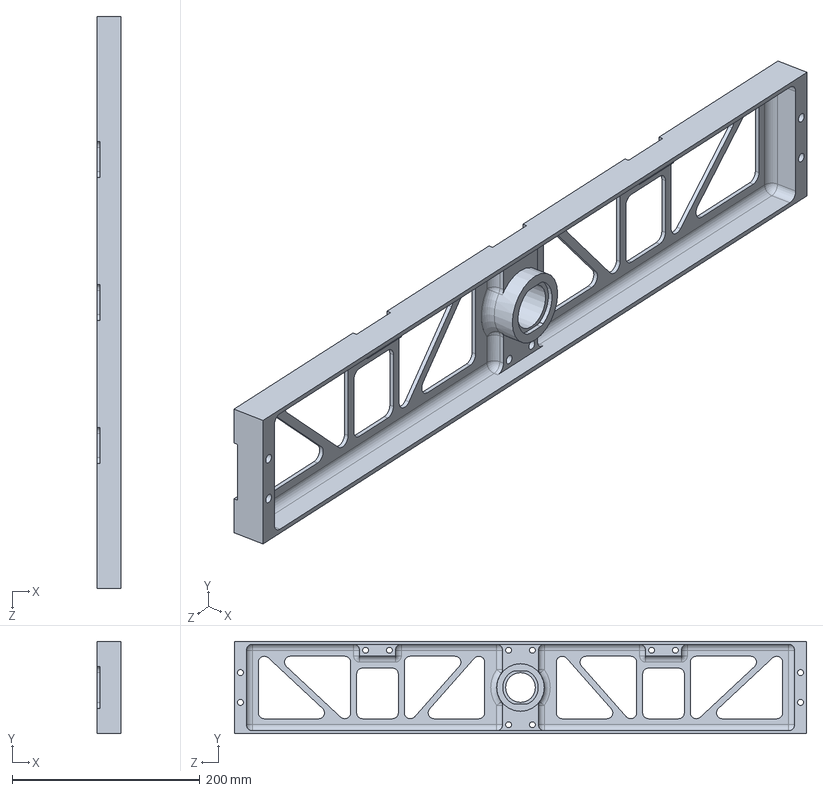
[picture p166: CAD file, 2014-01-06]
Pre-2016/Chassis/Chassis 1 (Box Chassis)/Major components/Chassis Side Rail.SLDPRT
25.4 x 98.4 x 609.6 mm
