ISU-MAVRIC/MAVRIC_Hardware/Pre-2016/Electrical/Battery Bar.SLDPRT

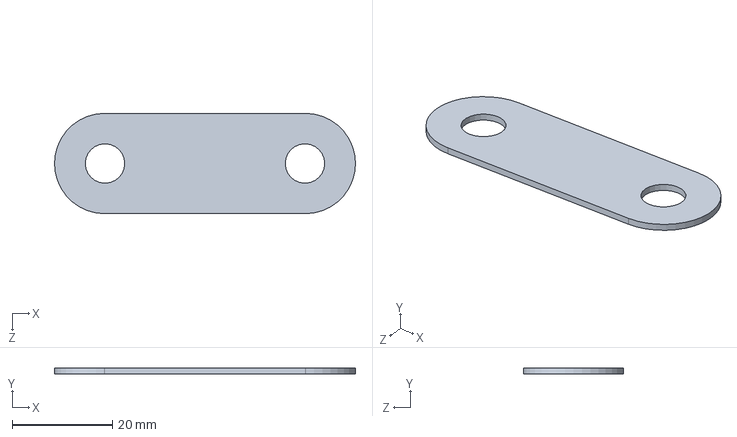
[picture p167: CAD file, 2013-10-17]
Pre-2016/Electrical/Battery Bar.SLDPRT
60.0 x 1.20 x 20.0 mm
