ISU-MAVRIC/MAVRIC_Hardware/Pre-2016/Soil Sample Tool/bottomdrillbithousingnewfall2013.SLDPRT

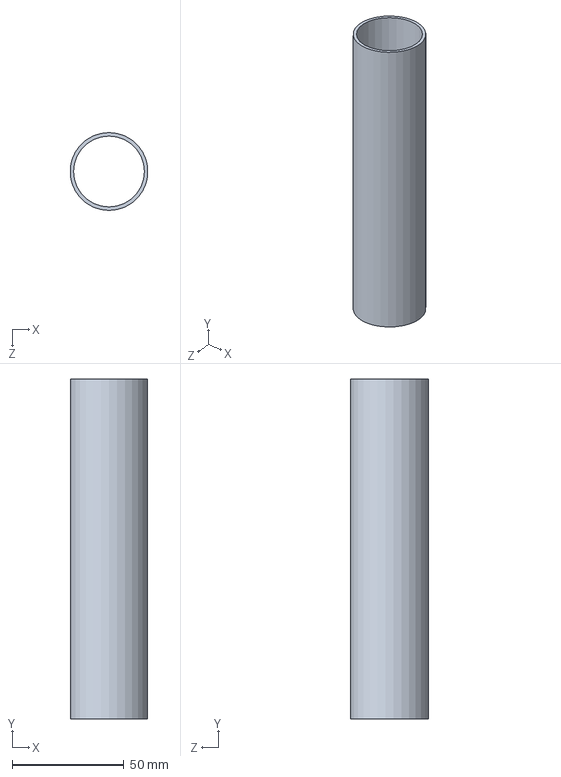
[picture p168: CAD file, 2013-11-14]
Pre-2016/Soil Sample Tool/bottomdrillbithousingnewfall2013.SLDPRT
34.7 x 152.4 x 34.9 mm
