ISU-MAVRIC/MAVRIC_Hardware/Pre-2016/Suspension/Fixturing/Wheel Joint Fixturing Plate.SLDPRT

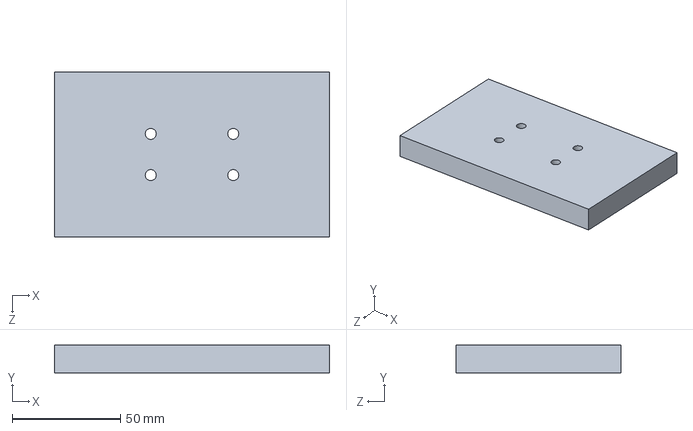
[picture p169: CAD file, 2013-12-13]
Pre-2016/Suspension/Fixturing/Wheel Joint Fixturing Plate.SLDPRT
127.0 x 12.7 x 76.2 mm
