ISU-MAVRIC/MAVRIC_Hardware/Pre-2016/Suspension/King Joint.SLDPRT

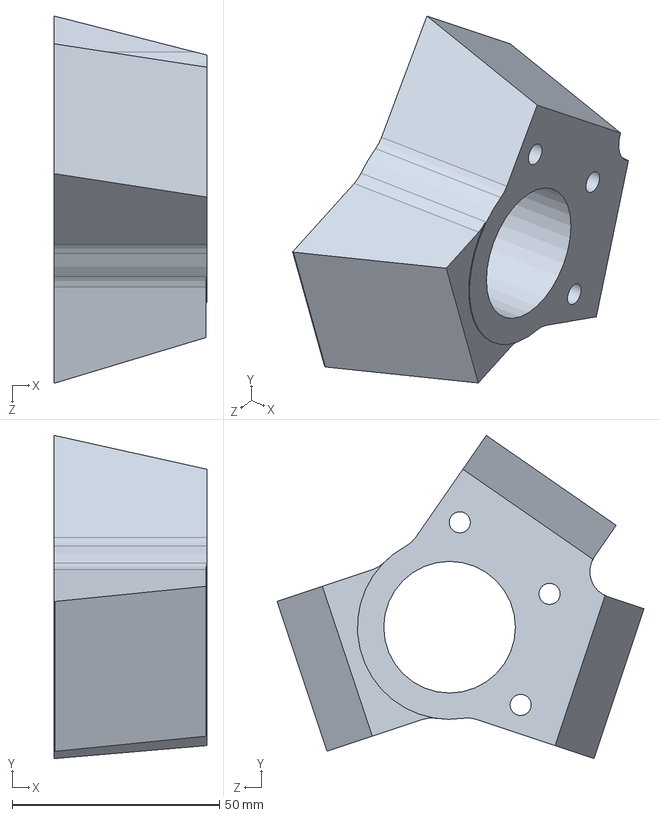
[picture p170: CAD file, 2013-12-05]
Pre-2016/Suspension/King Joint.SLDPRT
36.8 x 77.9 x 88.5 mm
