ISU-MAVRIC/MAVRIC_Hardware/Pre-2016/Arm/Arm Design 2013-2014/actuator mount.SLDPRT

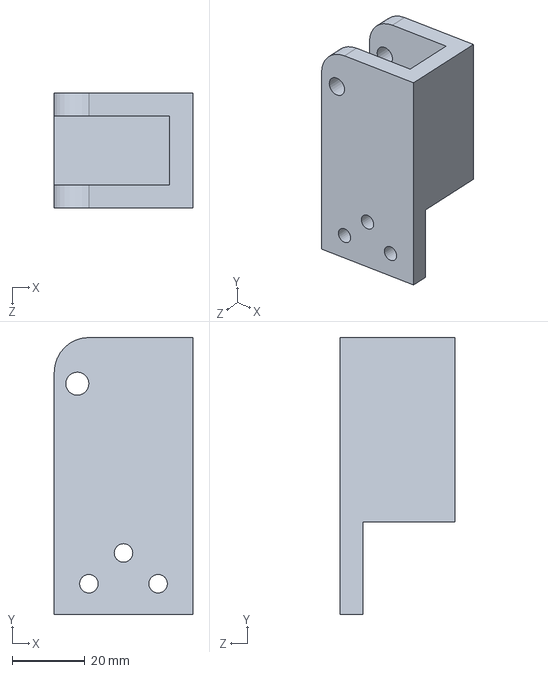
[picture p171: CAD file, 2014-04-26]
Pre-2016/Arm/Arm Design 2013-2014/actuator mount.SLDPRT
38.1 x 76.2 x 31.8 mm
