ISU-MAVRIC/MAVRIC_Hardware/Pre-2016/Camera/Camera Anchor.SLDPRT

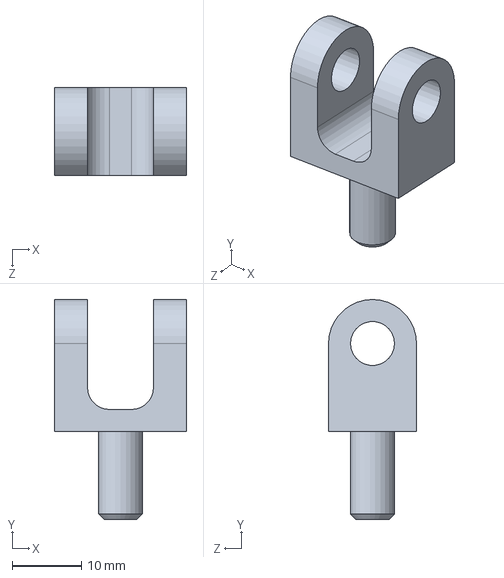
[picture p172: CAD file, 2013-12-05]
Pre-2016/Camera/Camera Anchor.SLDPRT
19.1 x 31.8 x 12.7 mm
