ISU-MAVRIC/MAVRIC_Hardware/Pre-2016/Electrical/M Cell Battery.SLDPRT

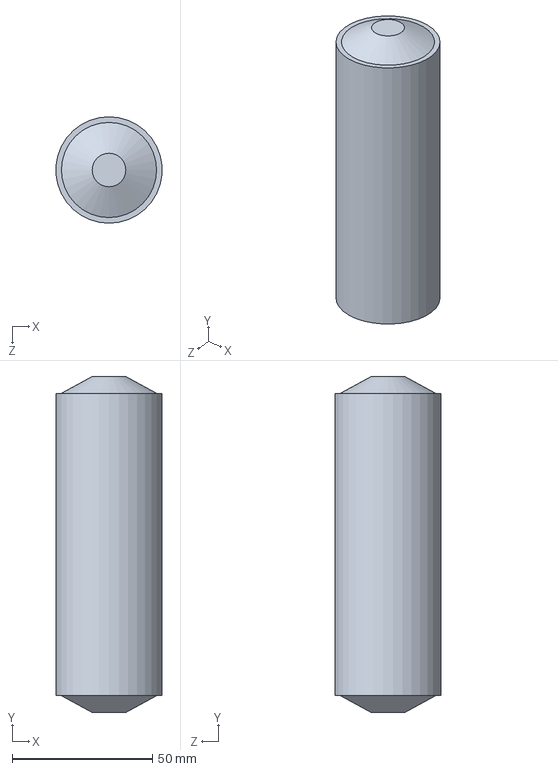
[picture p173: CAD file, 2013-10-17]
Pre-2016/Electrical/M Cell Battery.SLDPRT
37.8 x 120.0 x 38.0 mm
