ISU-MAVRIC/MAVRIC_Hardware/Pre-2016/Payload/Payload Bottom Member.SLDPRT

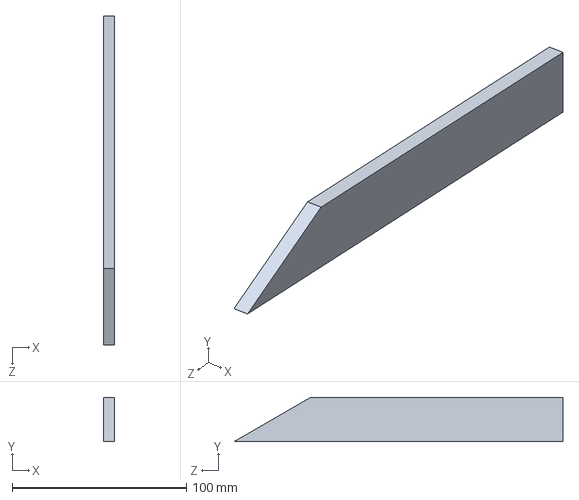
[picture p174: CAD file, 2013-12-05]
Pre-2016/Payload/Payload Bottom Member.SLDPRT
6.35 x 25.4 x 188.7 mm
