ISU-MAVRIC/MAVRIC_Hardware/Pre-2016/Soil Sample Tool/soilssamplehouseingtopnewfall2013.SLDPRT

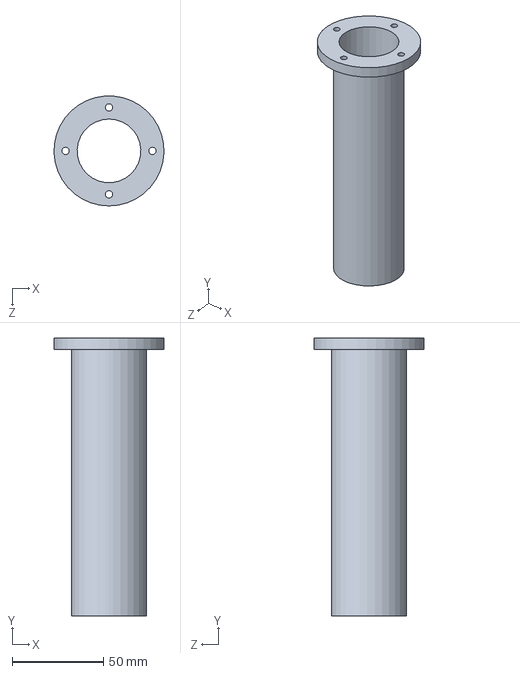
[picture p175: CAD file, 2013-11-14]
Pre-2016/Soil Sample Tool/soilssamplehouseingtopnewfall2013.SLDPRT
60.3 x 152.4 x 60.2 mm
