ISU-MAVRIC/MAVRIC_Hardware/Pre-2016/Steering Gearbox/Dual Stage Housing.SLDPRT

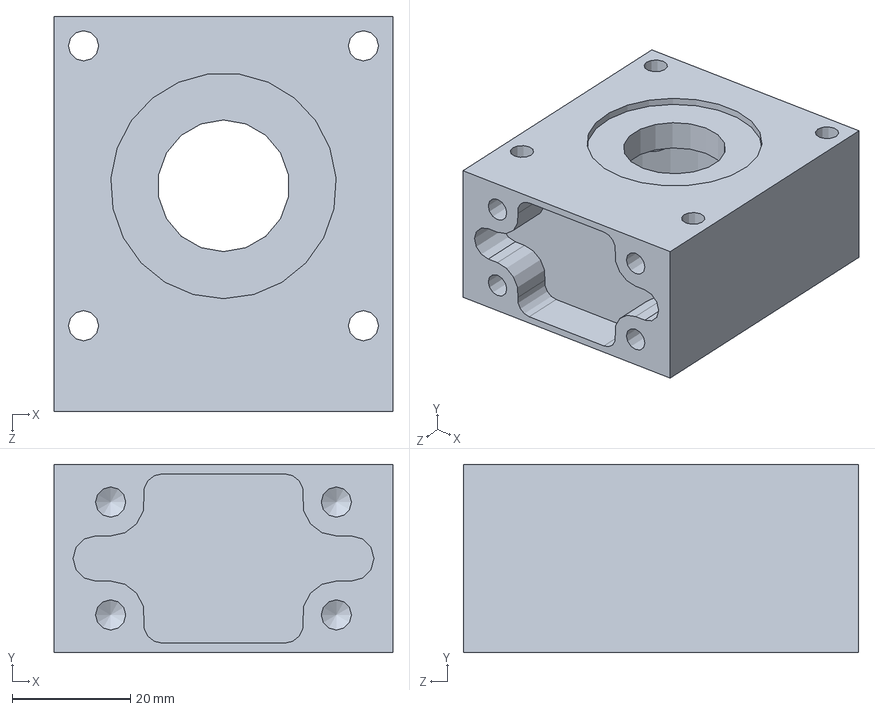
[picture p176: CAD file, 2013-12-04]
Pre-2016/Steering Gearbox/Dual Stage Housing.SLDPRT
57.1 x 31.8 x 66.7 mm
