ISU-MAVRIC/MAVRIC_Hardware/Pre-2016/Suspension/Bogie-Rocker Joint.SLDPRT

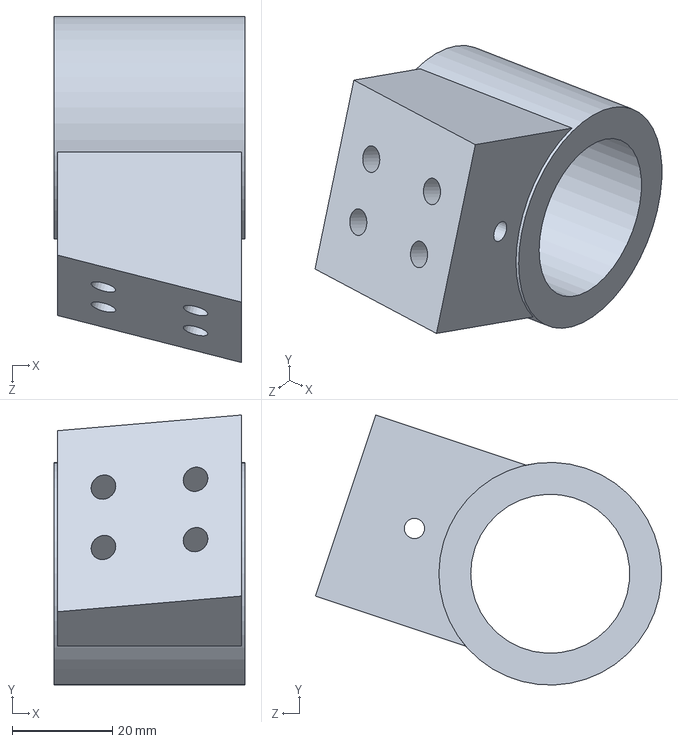
[picture p177: CAD file, 2013-12-05]
Pre-2016/Suspension/Bogie-Rocker Joint.SLDPRT
38.1 x 53.9 x 69.1 mm
