ISU-MAVRIC/MAVRIC_Hardware/Pre-2016/Suspension/Fixturing/Wheel Joint (Modified for CAM).SLDPRT

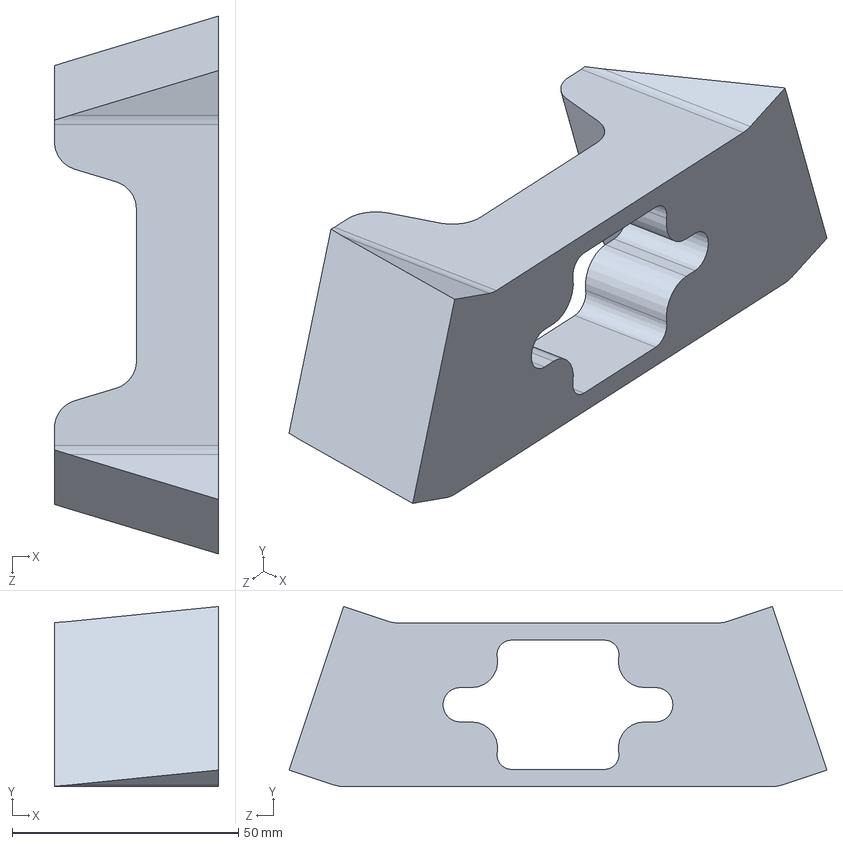
[picture p178: CAD file, 2013-12-13]
Pre-2016/Suspension/Fixturing/Wheel Joint (Modified for CAM).SLDPRT
36.3 x 39.8 x 118.9 mm
