ISU-MAVRIC/MAVRIC_Hardware/Pre-2016/Wheel Pod/Wheel Fixturing Wedge2.SLDPRT

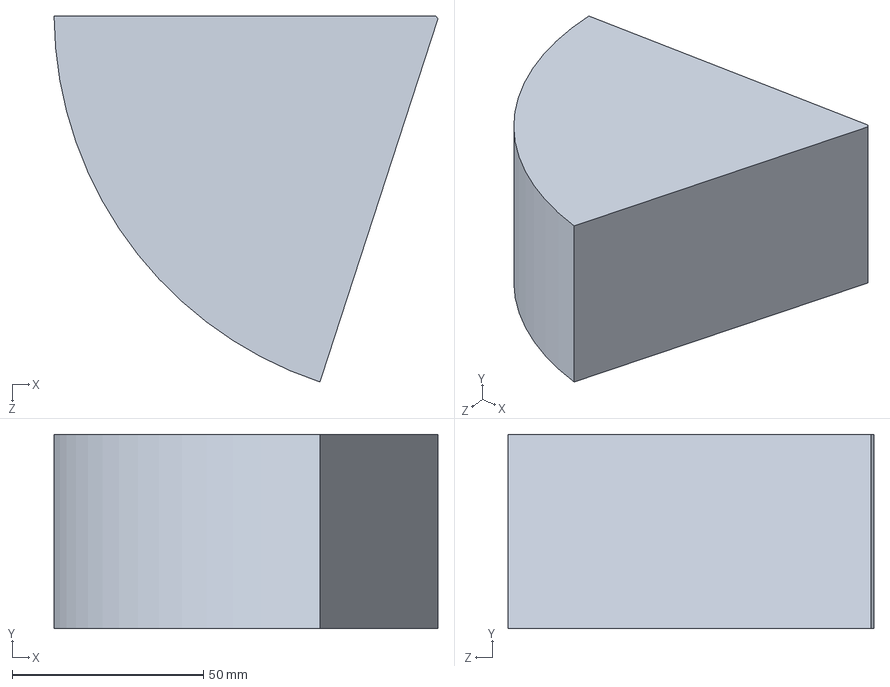
[picture p179: CAD file, 2013-11-14]
Pre-2016/Wheel Pod/Wheel Fixturing Wedge2.SLDPRT
100.5 x 50.8 x 95.8 mm
