ISU-MAVRIC/MAVRIC_Hardware/Pre-2016/Camera/Servo Frame.SLDPRT

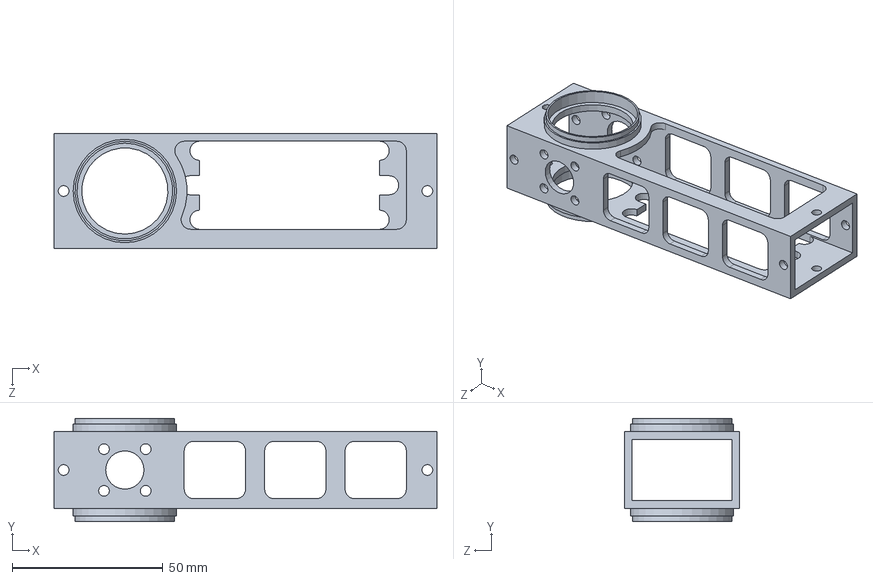
[picture p180: CAD file, 2013-12-05]
Pre-2016/Camera/Servo Frame.SLDPRT
127.0 x 34.3 x 38.1 mm
