ISU-MAVRIC/MAVRIC_Hardware/Pre-2016/Electrical/Cell Holder.SLDPRT

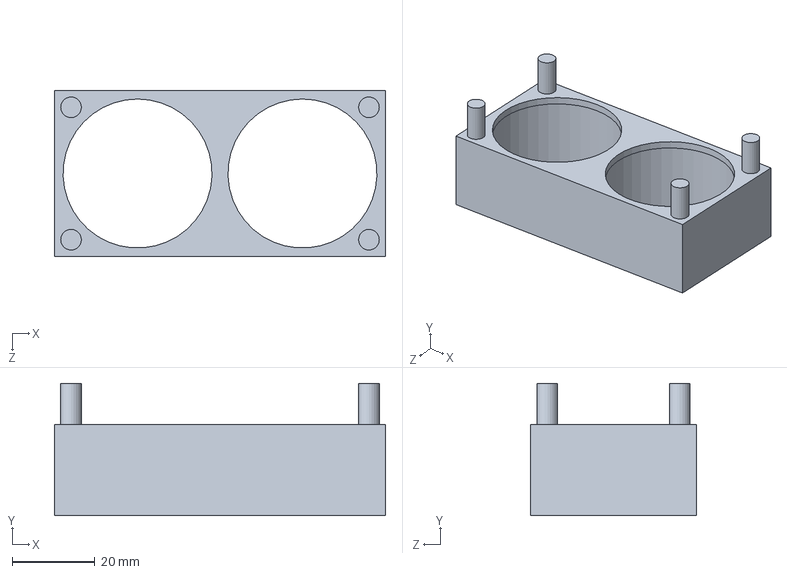
[picture p181: CAD file, 2013-10-17]
Pre-2016/Electrical/Cell Holder.SLDPRT
80.0 x 32.0 x 40.0 mm
