ISU-MAVRIC/MAVRIC_Hardware/Pre-2016/Steering Gearbox/Cover.SLDPRT

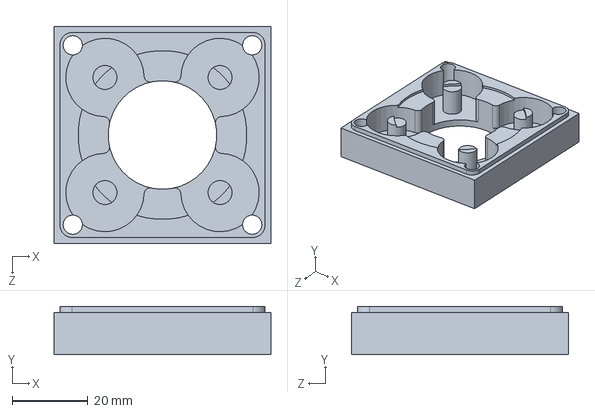
[picture p182: CAD file, 2013-11-25]
Pre-2016/Steering Gearbox/Cover.SLDPRT
57.1 x 12.7 x 57.1 mm
