ISU-MAVRIC/MAVRIC_Hardware/Pre-2016/Suspension/Rocker Rear Leg.SLDPRT

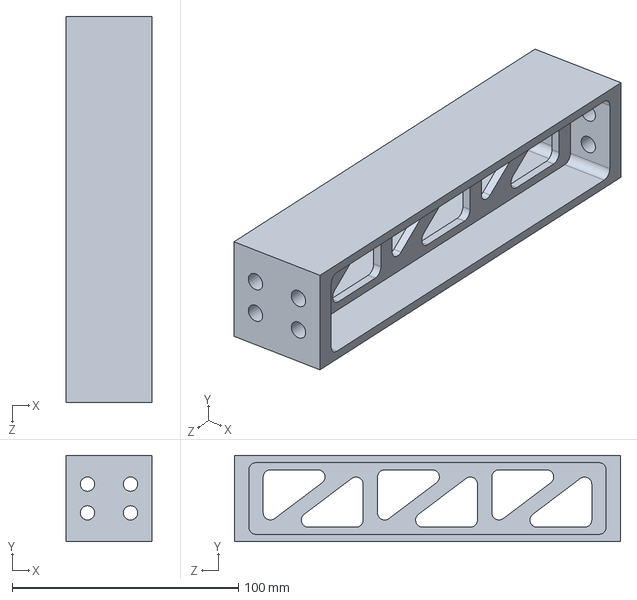
[picture p183: CAD file, 2013-12-05]
Pre-2016/Suspension/Rocker Rear Leg.SLDPRT
38.1 x 38.1 x 170.7 mm
