ISU-MAVRIC/MAVRIC_Hardware/Pre-2016/Arm/Arm Design 2013-2014/gear mount.SLDPRT

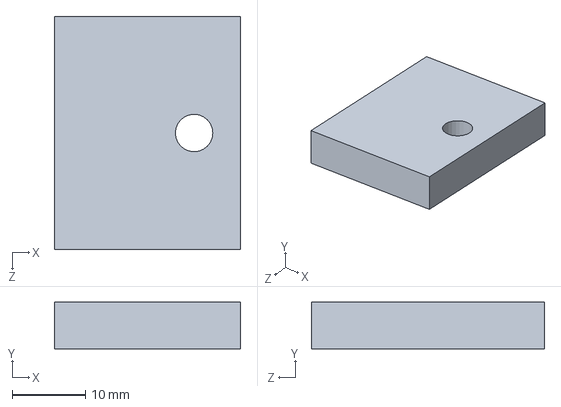
[picture p184: CAD file, 2014-04-17]
Pre-2016/Arm/Arm Design 2013-2014/gear mount.SLDPRT
25.4 x 6.35 x 31.8 mm
