ISU-MAVRIC/MAVRIC_Hardware/Pre-2016/Camera/Side Leg.SLDPRT

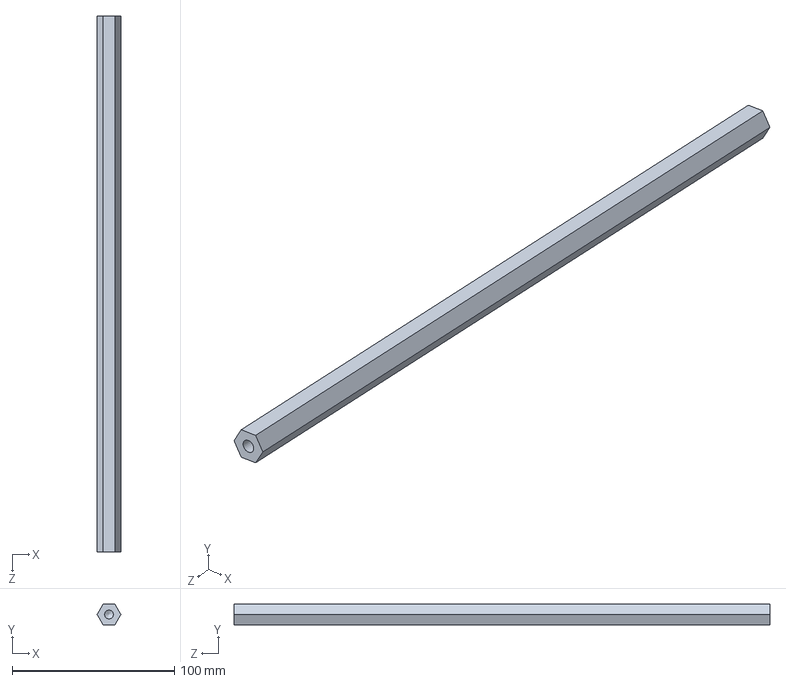
[picture p185: CAD file, 2013-12-05]
Pre-2016/Camera/Side Leg.SLDPRT
14.7 x 12.7 x 330.2 mm
