ISU-MAVRIC/MAVRIC_Hardware/Pre-2016/End Effector/Servo Assembly Components/Bracket (s2 to s3).SLDPRT

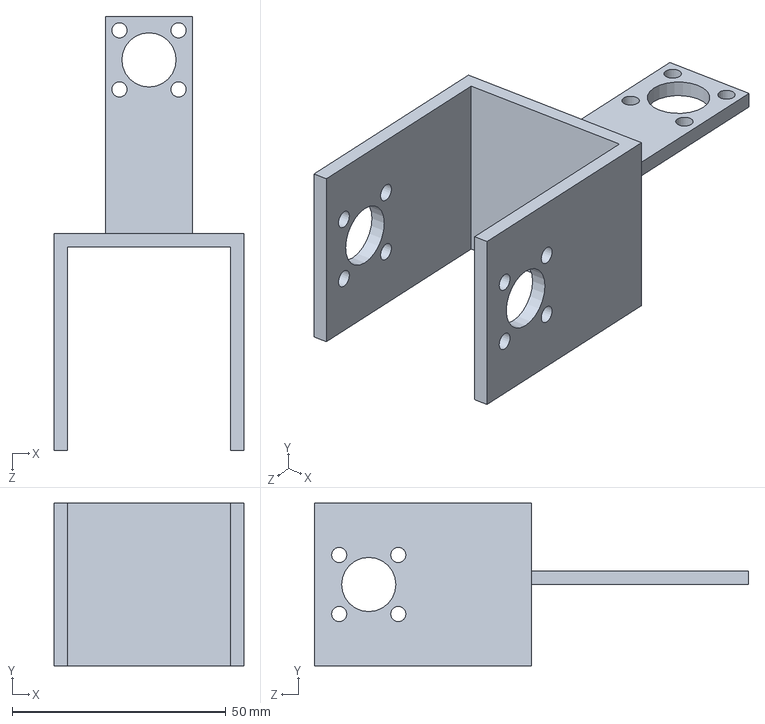
[picture p186: CAD file, 2014-03-13]
Pre-2016/End Effector/Servo Assembly Components/Bracket (s2 to s3).SLDPRT
44.5 x 38.1 x 101.6 mm
