ISU-MAVRIC/MAVRIC_Hardware/Pre-2016/Payload/Payload Frame.SLDPRT

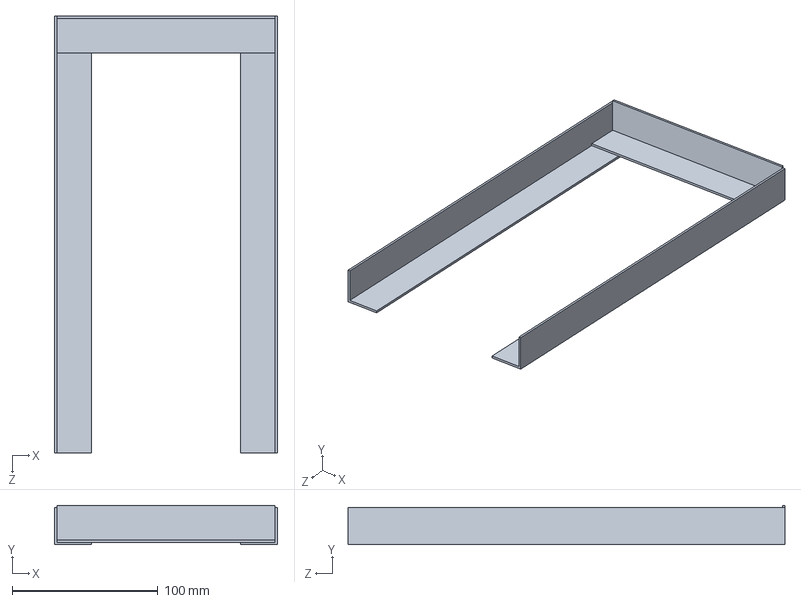
[picture p187: CAD file, 2013-12-04]
Pre-2016/Payload/Payload Frame.SLDPRT
153.2 x 27.0 x 300.0 mm
