ISU-MAVRIC/MAVRIC_Hardware/Pre-2016/Suspension/Fixturing/Bogie Joint Fixturing Plate.SLDPRT

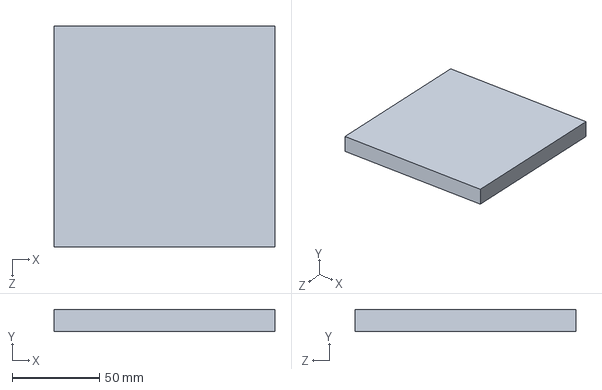
[picture p188: CAD file, 2013-12-11]
Pre-2016/Suspension/Fixturing/Bogie Joint Fixturing Plate.SLDPRT
127.0 x 12.7 x 127.0 mm
