ISU-MAVRIC/MAVRIC_Hardware/Pre-2016/Suspension/King Pin.SLDPRT

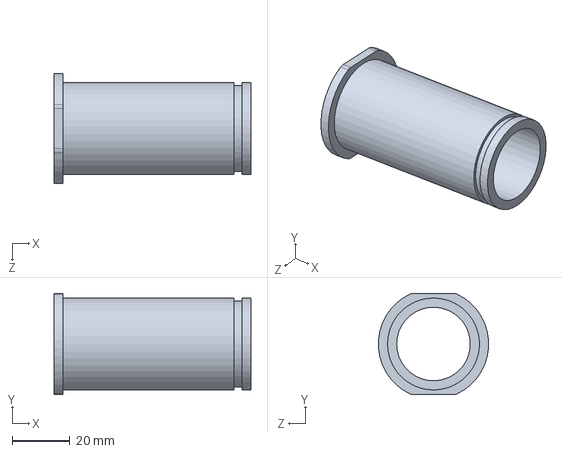
[picture p189: CAD file, 2013-11-26]
Pre-2016/Suspension/King Pin.SLDPRT
68.0 x 34.9 x 38.0 mm
