ISU-MAVRIC/MAVRIC_Hardware/Pre-2016/Arm/Arm Design 2013-2014/big gear.SLDPRT

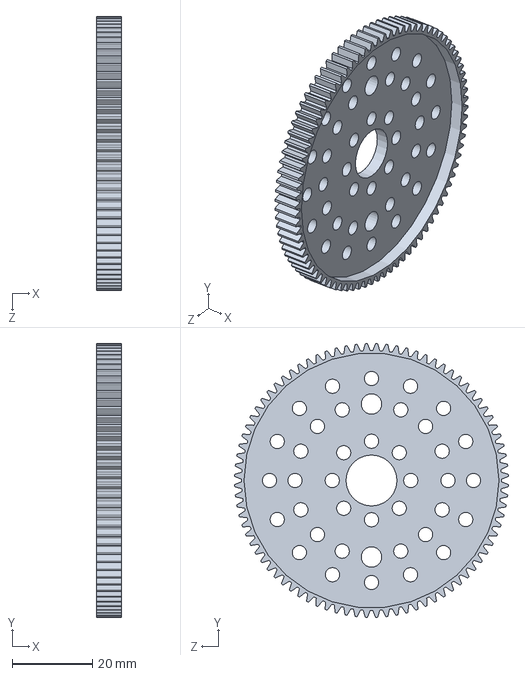
[picture p190: CAD file, 2014-04-17]
Pre-2016/Arm/Arm Design 2013-2014/big gear.SLDPRT
6.35 x 68.2 x 68.2 mm
