ISU-MAVRIC/MAVRIC_Hardware/Pre-2016/Camera/Elbow.SLDPRT

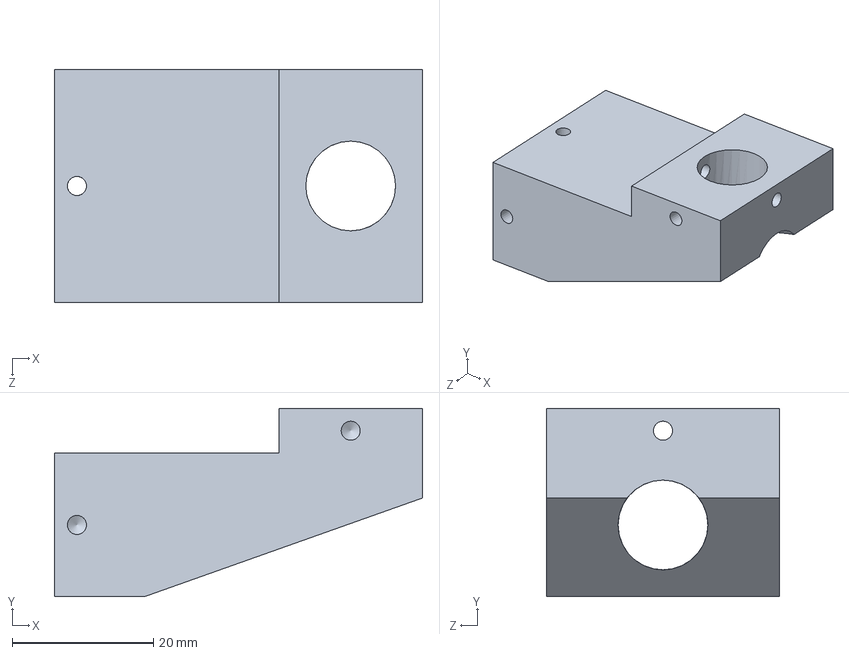
[picture p191: CAD file, 2013-12-05]
Pre-2016/Camera/Elbow.SLDPRT
52.1 x 26.7 x 33.0 mm
