ISU-MAVRIC/MAVRIC_Hardware/Pre-2016/End Effector/Servo Assembly Components/High Torque Gear Box Bracket.SLDPRT

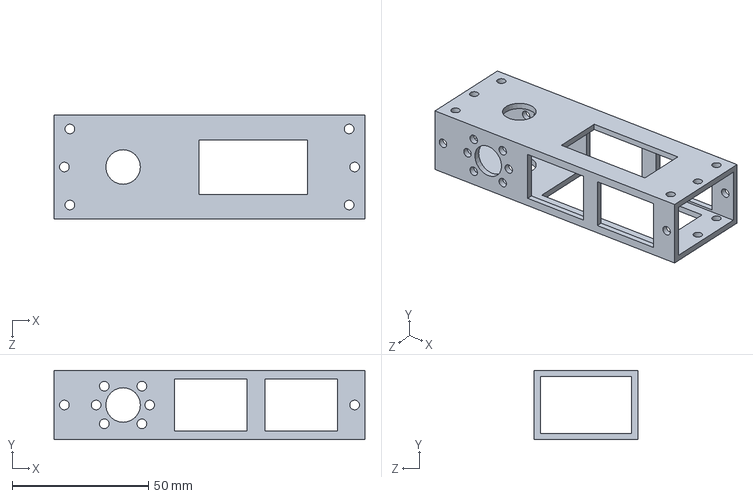
[picture p192: CAD file, 2014-03-11]
Pre-2016/End Effector/Servo Assembly Components/High Torque Gear Box Bracket.SLDPRT
114.3 x 25.4 x 38.1 mm
