ISU-MAVRIC/MAVRIC_Hardware/(list of files, cad)

Other CAD files:
Pre-2016/End Effector/Servo Assemblies/Low Torque Gear Box Assembly.SLDASM
Pre-2016/Payload/MirrorPayload Bottom Member.SLDPRT
Pre-2016/Wheel Pod/Fabrication/MAVRIC_DropPlate_Dim.DXF
Pre-2016/Chassis/Chassis 1 (Box Chassis)/Major components/Cross Bar Mount 2.sldprt
Pre-2016/Geometry Planning Sketch.SLDPRT
Pre-2016/Wheel Pod/Fabrication/MAVRIC_DropPlate_NoDim.DXF
Pre-2016/Chassis/Chassis 1 (Box Chassis)/Covers/Metal/Top Rear Cover panel.SLDPRT
Pre-2016/Payload/MirrorPayload Support Clip.SLDPRT
Pre-2016/Steering Gearbox/Dual Stage Output Disk-Reduced Diameter Version.SLDPRT
Pre-2016/Wheel Pod/Wheel Fixturing Wedge1.SLDPRT
Pre-2016/Payload/MirrorPayload Bottom Clip.SLDPRT
Pre-2016/Steering Gearbox/First Stage Cycloidal Profile-Reduced Diameter Version.SLDPRT
Pre-2016/Wheel Pod/Wheel.SLDPRT
Pre-2016/Steering Gearbox/Second Stage Cycloidal Profile-Reduced Diamter Version.SLDPRT
Pre-2016/Arm/Arm Design 2013-2014/axis for base.SLDPRT
Pre-2016/Arm/Arm Design 2013-2014/chassis mount 2.SLDPRT
Pre-2016/Arm/Arm Design 2013-2014/chassis mount.SLDPRT
Pre-2016/Arm/Arm Design 2013-2014/lower arm (1.5in Thick).SLDPRT
Pre-2016/Arm/Arm Design 2013-2014/lower arm 2014.SLDPRT
Pre-2016/Arm/Arm Design 2013-2014/motor mount.SLDPRT
Pre-2016/Arm/Arm Design 2013-2014/small gear.sldprt
Pre-2016/Camera/Camera Board.SLDPRT
Pre-2016/Camera/Commercial Parts/90156A259.SLDPRT
Pre-2016/Camera/FCB EX1020.SLDPRT
Pre-2016/Camera/HS785HB Servo.SLDPRT
Pre-2016/Camera/Servo Axle.SLDPRT
Pre-2016/Chassis/Chassis 1 (Box Chassis)/Purchased/98585A109.SLDPRT
Pre-2016/Chassis/Chassis 1 (Box Chassis)/Purchased/Ball Joint Assembly.SLDASM
Pre-2016/Chassis/Chassis 1 (Box Chassis)/Purchased/Ball Joint Ball.SLDPRT
Pre-2016/Chassis/Chassis 1 (Box Chassis)/Purchased/Ball Joint Housing.SLDPRT
Pre-2016/End Effector/Servo Assembly Components/Bracket (s1 to s2).SLDPRT
Pre-2016/End Effector/Servo Assembly Components/Gear Box Bracket.SLDPRT
Pre-2016/End Effector/Servo Assembly Components/High Torque Gear Box Bracket2.SLDPRT
Pre-2016/End Effector/Servo Assembly Components/High Torque Servo.SLDPRT
Pre-2016/End Effector/Servo Assembly Components/Large Spindle.SLDPRT
Pre-2016/End Effector/Servo Assembly Components/Low Torque Gear Box Bracket.SLDPRT
Pre-2016/End Effector/Servo Assembly Components/Low Torque Servo.SLDPRT
Pre-2016/End Effector/Servo Assembly Components/Small Gear.SLDPRT
Pre-2016/End Effector/Servo Assembly Components/Small Spindle.SLDPRT
Pre-2016/Steering Gearbox/Commercial/5905K230 Roller Bearing.SLDPRT
Pre-2016/Steering Gearbox/Commercial/5909K370.SLDPRT
Pre-2016/Steering Gearbox/Commercial/6383K120.SLDPRT
Pre-2016/Steering Gearbox/Commercial/6383K140 Input bearing.SLDPRT
Pre-2016/Steering Gearbox/Dual Stage Eccentric Cam.SLDPRT
Pre-2016/Suspension/Bogie Leg.SLDPRT
Pre-2016/Suspension/Drawings/Front Bar Holes.SLDDRW
Pre-2016/Suspension/Drawings/King Pin.SLDDRW
Pre-2016/Suspension/Fixturing/Bogie Joint (Modified for CAM).SLDPRT
Pre-2016/Suspension/Fixturing/Bogie-Rocker Joint (Modified for Cam).SLDPRT
Pre-2016/Suspension/Fixturing/King Joint Fixturing plate.SLDPRT
Pre-2016/Suspension/Joint Pin.SLDPRT
Pre-2016/Suspension/Purchased Parts/98585A121.SLDPRT
Pre-2016/Suspension/Purchased Parts/98585A127.SLDPRT
Pre-2016/Suspension/Rocker Leg.SLDPRT
Pre-2016/Suspension/Suspension Mount.SLDPRT
Pre-2016/Wheel Pod/Fabrication/Drop Plate Waterjet.SLDDRW
