ISU-MAVRIC/MAVRIC_Hardware/Pre-2016/Arm/Mavrick Weight Evaluation.docx

C

Actuator (2)

Actuator (1)

Weight on hand

Sum of Distributed Load

A
