ISU-MAVRIC/MAVRIC_Hardware/Pre-2016/Wheel Pod/Fabrication/Drop Plate Waterjet.PDF

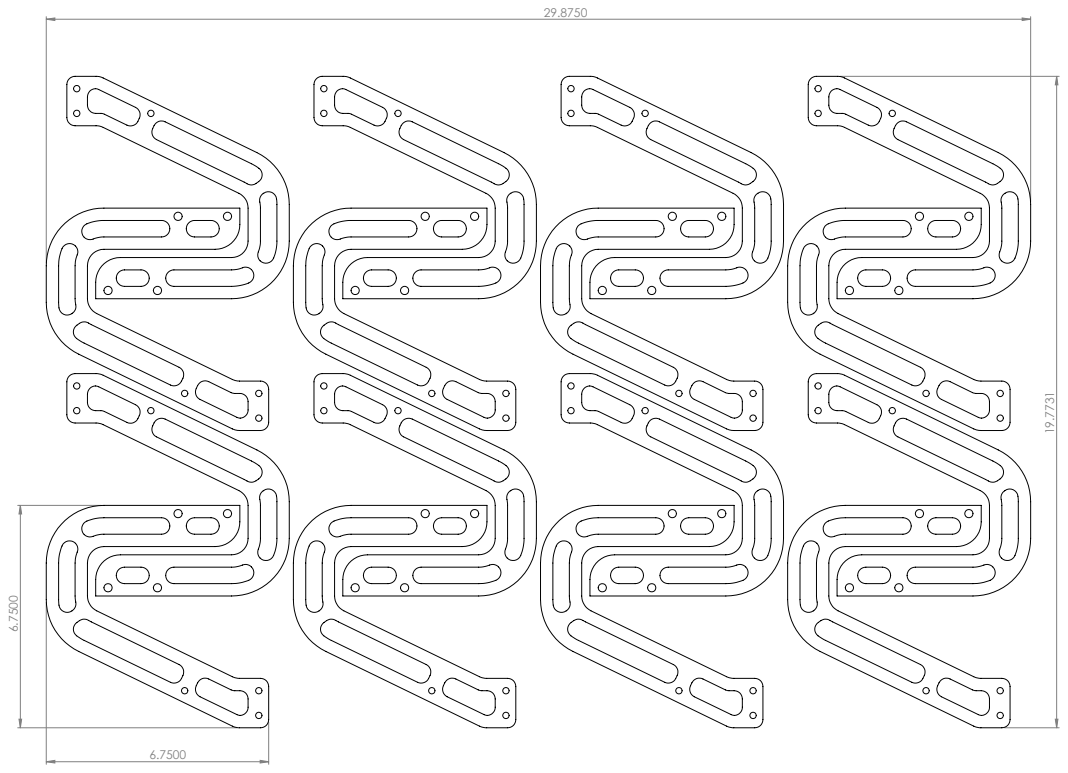
[picture p194: page 1]
SCALE:1:2; SHEET 1 OF 1; DO NOT SCALE DRAWING; REVISION; DEBUR AND BREAK SHARP; UNLESS OTHERWISE SPECIFIED:; FINISH:

DIMENSIONS ARE IN MILLIMETERS
SURFACE FINISH:
TOLERANCES:
LINEAR:
ANGULAR:

NAME | SIGNATURE | DATE | | | | TITLE:
Q.A | | | | MATERIAL: | Drop Plate Waterjet WEIGHT: DWG NO. | A1

DRAWN
CHK'D
APPV'D
MFG
