ISU-MAVRIC/MAVRIC_Hardware/2017/STM32 Motherboard/STM32Motherboard.kicad_pcb

## KiCad design z80_computer.sch

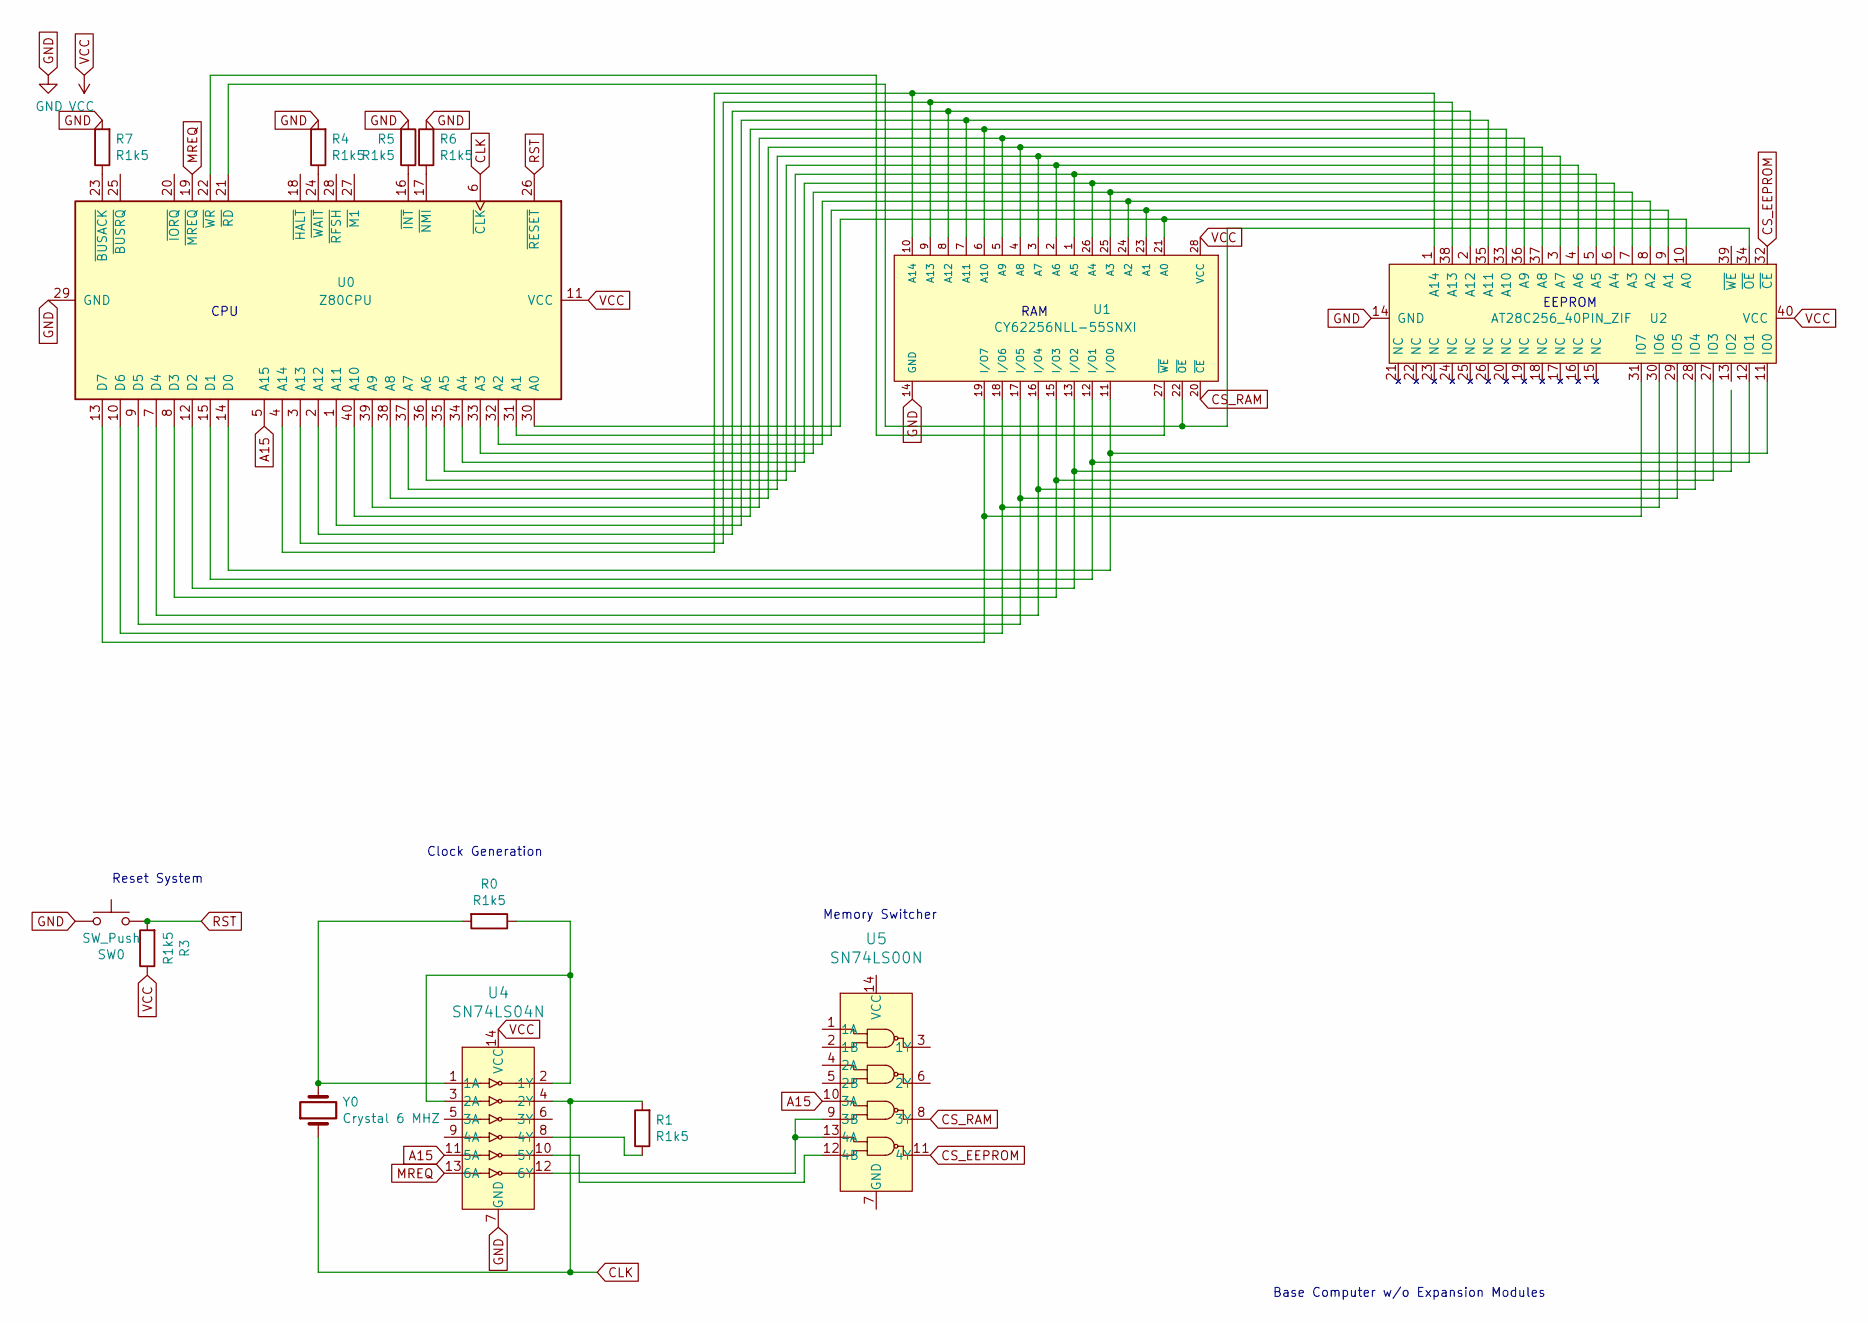
[picture p195: schematic z80_computer.sch]

Parts:
R0, R1, R3, R4, R5, R6, R7: R1k5
SW0: SW_Push
U0: Z80CPU
U1: CY62256NLL-55SNXI; Cypress-51-85092-0-E-*; mouser part number 727-CY62256NLL55SNXI; digikey description IC SRAM 256KBIT 55NS 28SOIC
U2: AT28C256_40PIN_ZIF
U4: SN74LS04N; DIP-14_W3mm; MPN SN74LS04N; Digi-Key_PN 296-1629-5-ND
U5: SN74LS00N; DIP-14_W3mm; MPN SN74LS00N; Digi-Key_PN 296-1626-ND
Y0: Crystal 6 MHZ

Connections:
A15: U0.5 (A15), U4.11 (5A), U5.10 (3A)
CLK: R1.2, U0.6 (~CLK~), U4.4 (2Y), Y0.1
CS_EEPROM: U2.32 (~CE), U5.11 (4Y)
CS_RAM: U1.20 (~CE~), U5.8 (3Y)
GND: R4.2, R5.2, R6.2, R7.2, SW0.1, U0.29 (GND), U1.14 (GND), U2.14 (GND), U4.7 (GND)
MREQ: U0.19 (~MREQ~), U4.13 (6A)
unnamed: R0.1, U4.2 (1Y), U4.3 (2A)
unnamed: R0.2, U4.1 (1A), Y0.2
unnamed: R1.1, U4.8 (4Y)
unnamed: R4.1, U0.24 (~WAIT~)
unnamed: R5.1, U0.16 (~INT~)
unnamed: R6.1, U0.17 (~NMI~)
unnamed: R7.1, U0.23 (~BUSACK~)
unnamed: U0.1 (A11), U1.7 (A11), U2.35 (A11)
unnamed: U0.2 (A12), U1.8 (A12), U2.2 (A12)
unnamed: U0.3 (A13), U1.9 (A13), U2.38 (A13)
unnamed: U0.4 (A14), U1.10 (A14), U2.1 (A14)
unnamed: U0.7 (D4), U1.16 (I/O4), U2.28 (IO4)
unnamed: U0.8 (D3), U1.15 (I/O3), U2.27 (IO3)
unnamed: U0.9 (D5), U1.17 (I/O5), U2.29 (IO5)
unnamed: U0.10 (D6), U1.18 (I/O6), U2.30 (IO6)
unnamed: U0.12 (D2), U1.13 (I/O2)
unnamed: U0.13 (D7), U1.19 (I/O7), U2.31 (I07)
unnamed: U0.14 (D0), U1.11 (I/O0), U2.11 (IO0)
unnamed: U0.15 (D1), U1.12 (I/O1), U2.12 (IO1)
unnamed: U0.21 (~RD~), U1.22 (~OE~), U2.34 (~OE)
unnamed: U0.22 (~WR~), U1.27 (~WE~)
unnamed: U0.30 (A0), U1.21 (A0), U2.10 (A0)
unnamed: U0.31 (A1), U1.23 (A1), U2.9 (A1)
unnamed: U0.32 (A2), U1.24 (A2), U2.8 (A2)
unnamed: U0.33 (A3), U1.25 (A3), U2.7 (A3)
unnamed: U0.34 (A4), U1.26 (A4), U2.6 (A4)
unnamed: U0.35 (A5), U1.1 (A5), U2.5 (A5)
unnamed: U0.36 (A6), U1.2 (A6), U2.4 (A6)
unnamed: U0.37 (A7), U1.3 (A7), U2.3 (A7)
unnamed: U0.38 (A8), U1.4 (A8), U2.37 (A8)
unnamed: U0.39 (A9), U1.5 (A9), U2.36 (A9)
unnamed: U0.40 (A10), U1.6 (A10), U2.33 (A10)
unnamed: U4.10 (5Y), U5.12 (4B)
unnamed: U4.12 (6Y), U5.9 (3B), U5.13 (4A)
RST: R3.2, SW0.2, U0.26 (~RESET~)
VCC: R3.1, U0.11 (VCC), U1.28 (VCC), U2.40 (VCC), U4.14 (VCC)

Notes on the sheet:
RAM
EEPROM
Clock Generation
Reset System
Base Computer w/o Expansion Modules
Memory Switcher
CPU
