ISU-MAVRIC/MAVRIC_Hardware/(commit log)

2013-11-02 Start over
    [5905K230 Roller Bearing.SLDPRT, 5905K280.SLDPRT, 5909K370.SLDPRT, 6383K120.SLDPRT, 6383K140 Input bearing.SLDPRT, Battery Bar.SLDPRT, Bogie-Rocker Joint.SLDPRT, Cell Battery Assembly.SLDASM]
2013-11-02 File Upload
    [5905K230 Roller Bearing.SLDPRT, 5905K280.SLDPRT, 5909K370.SLDPRT, 6383K120.SLDPRT, 6383K140 Input bearing.SLDPRT, Battery Bar.SLDPRT, Bogie Member.SLDPRT, Bogie-Rocker Joint Updated.SLDPRT]
2013-11-03 Starting New Suspension Geometry
    [Geometry Planning Sketch.SLDPRT]
2013-11-04 New King Joint, Geometry Planning
    [Dual Stage Housing.SLDPRT, Geometry Planning Sketch.SLDPRT, King Joint.SLDPRT, Rocker Leg.SLDPRT, Suspension Assembly.SLDASM, Wheel Joint.SLDPRT]
2013-11-05 New parts for the updated Suspension Design
    [Bogie Joint.SLDPRT, Bogie Leg.SLDPRT, Bogie Member.SLDPRT, Bogie-Rocker Joint Updated.SLDPRT, Bogie-Rocker Joint.SLDPRT, Dual Stage Housing.SLDPRT, Geometry Planning Sketch.SLDPRT, King Joint Drilling Plate.SLDPRT]
2013-11-06 Connected rocker and bogie
    Misc changes
    [98585A121.SLDPRT, Bogie Joint.SLDPRT, Bogie Leg.SLDPRT, Bogie-Rocker Joint.SLDPRT, Dual Stage Output Disk-Reduced Diameter Version.SLDPRT, First Stage Cycloidal Profile-Reduced Diameter Version.SLDPRT, Gearbox Assembly.SLDASM, Geometry Planning Sketch.SLDPRT]
2013-11-08 Add mount holes to joints
    Add rough components for diff bar
    [Ball Joint Assembly.SLDASM, Ball Joint Ball.SLDPRT, Ball Joint Housing.SLDPRT, Ball Joint Insert.SLDPRT, Bogie Joint.SLDPRT, Bogie-Rocker Joint.SLDPRT, Diff Bar Axle.SLDPRT, Diff Bar Fastener.SLDPRT]
2013-11-09 Add differential bar
    [Ball Joint Assembly.SLDASM, Ball Joint Housing.SLDPRT, Cover Assembly.SLDASM, Diff Bar Axle.SLDPRT, Diff Bar.SLDPRT, Diff Link.SLDPRT, Diff Linkage Assembly.SLDASM, Diff Yoke.SLDPRT]
2013-11-12 Lightening Components and Misc. Stress testing
    [Bogie Joint.SLDPRT, Bogie-Rocker Joint.SLDPRT, Drop Plate.SLDPRT, Gearbox Assembly.SLDASM, MAVRIC.SLDASM, Steering Assembly.SLDASM, Suspension Assembly.SLDASM, Suspension Mirror.SLDASM]
2013-11-13 Weight reduction
    [Bogie Joint.SLDPRT, Bogie Leg.SLDPRT, Bogie-Rocker Joint.SLDPRT, Cover Assembly.SLDASM, King Joint.SLDPRT, MAVRIC.SLDASM, Rocker Leg.SLDPRT, Rocker Rear Leg.SLDPRT]
2013-11-13 Further weight reduction
    By Ethan
    [Bogie Joint.SLDPRT, Bogie-Rocker Joint.SLDPRT, Drop Plate.SLDPRT, King Joint.SLDPRT, MAVRIC.SLDASM, Rocker Rear Leg.SLDPRT, Suspension Assembly.SLDASM, Suspension Mirror.SLDASM]
2013-11-13 Weight reduction and chassis
    [98585A127.SLDPRT, Chassis Assembly.SLDASM, Chassis Side Rail.SLDPRT, Cover Assembly.SLDASM, Cover.SLDPRT, Diff Yoke.SLDPRT, Drop Plate.SLDPRT, Dual Stage Housing.SLDPRT]
2013-11-13 Build chassis
    [Chassis Assembly.SLDASM, Chassis Side Rail-Mirror.SLDPRT, Chassis Side Rail.SLDPRT, Cross Bar.SLDPRT, Dual Stage Housing.SLDPRT, King Pin.SLDPRT, MAVRIC.SLDASM, Suspension Assembly.SLDASM]
2013-11-14 Temp diff fitting
    [5905K280.SLDPRT, 98585A109.SLDPRT, Ball Joint Assembly.SLDASM, Ball Joint Ball.SLDPRT, Ball Joint Housing.SLDPRT, Ball Joint Insert.SLDPRT, Chassis Assembly.SLDASM, Diff Bar Axle.SLDPRT]
2013-11-14 Differential mates
    [Chassis Assembly.SLDASM, Diff Linkage Assembly.SLDASM, MAVRIC.SLDASM]
2013-11-14 Update differential geometry
    [Ball Joint Assembly.SLDASM, Chassis Assembly.SLDASM, Cover Assembly.SLDASM, Diff Linkage Assembly.SLDASM, Diff Yoke.SLDPRT, MAVRIC.SLDASM, Suspension Assembly.SLDASM, Suspension Mirror.SLDASM]
2013-11-14 Starting a secondary chassis design
    [98585A109.SLDPRT, Ball Joint Assembly.SLDASM, Ball Joint Ball.SLDPRT, Ball Joint Housing.SLDPRT, Chassis 2.SLDASM, Chassis Assembly.SLDASM, Chassis Side Rail-Mirror.SLDPRT, Chassis Side Rail.SLDPRT]
2013-11-14 Updated wheel fixturing setup
    [Chassis Assembly.SLDASM, MAVRIC.SLDASM, Wheel Cut Pattern.SLDASM, Wheel Fixturing Wedge1.SLDPRT, Wheel Fixturing Wedge2.SLDPRT, Wheel Fixturing Wedge3.SLDPRT]
2013-11-14 Uploaded soil sample tool parts
    [bottomdrillbithousingnewfall2013.SLDPRT, bottomtabssoilsamplenew2013.SLDPRT, soilssamplehouseingtopnewfall2013.SLDPRT, topfaseningpicenewsoilsample2013.SLDPRT]
2013-11-15 Adding Mastercam files for Soil Sample Tool
2013-11-19 Updated mastercam for soil sample
2013-11-22 Starting Mastercam for the King Pin Joint / Removed some lightening holes
    [Bogie Joint.SLDPRT, Bogie-Rocker Joint.SLDPRT, Dual Stage Housing.SLDPRT, Fixturing Assembly.SLDASM, Joint Pin.SLDPRT, King Joint Fixturing Assembly.SLDASM, King Joint Fixturing plate.SLDPRT, King Joint.SLDPRT]
2013-11-25 Mastercam for the King Joint
2013-11-25 Mastercam for King Joint and Updated Gearbox Components
    [Dual Stage Output Disk-Reduced Diameter Version.SLDPRT, Gearbox Assembly.SLDASM]
2013-11-25 Change output face thickness
    [Cover Assembly.SLDASM, Dual Stage Output Disk-Reduced Diameter Version.SLDPRT, Gearbox Assembly.SLDASM]
2013-11-25 Update gearbox cover
    [Cover Assembly.SLDASM, Cover.SLDPRT, Gearbox Assembly.SLDASM, Steering Assembly.SLDASM]
2013-11-25 Finished Mastercam for King Joint
2013-11-25 Updated Drill sizing on King Joint 1
2013-11-25 Add motor driver and mount to steering assembly
    [Dual Stage Output Disk-Reduced Diameter Version.SLDPRT, Steering Assembly.SLDASM, Steering Top Plate.SLDPRT, Wheel Assembly.SLDASM, Wheel Driver.SLDPRT]
2013-11-25 Change box chassis to billet side rails
    [Chassis Assembly.SLDASM, Chassis Side Rail-Mirror.SLDPRT, Chassis Side Rail.SLDPRT, Cross Bar.SLDPRT, Front Bar.SLDPRT]
2013-11-25 Rocker Rear Leg CAM and Bogie-Rocker Joint CAM
2013-11-25 Updated tools in Mastercam files/ added new Mastercam files
    [Bogie-Rocker Joint.SLDPRT, King Joint Fixturing plate.SLDPRT]
2013-11-26 Add servo assembly components
    [HS785HB Servo.SLDPRT, Servo Assembly.SLDASM, Servo Axle.SLDPRT, Servo Frame.SLDPRT]
2013-11-26 Add gear to servo axle
    [Servo Assembly.SLDASM, Servo Axle.SLDPRT]
2013-11-26 Mastercam Files and Fixturing Setups
    [Bogie Joint.SLDPRT, Bogie-Rocker Fixture.SLDASM, Bogie-Rocker Joint (Modified for Cam).SLDPRT]
2013-11-26 Camera assembly
    [Camera Assembly.SLDASM, Elbow.SLDPRT, Servo Assembly.SLDASM, Servo Frame.SLDPRT]
2013-11-26 Modify suspension assembly to mate with new chassis
    [Bogie Joint.SLDPRT, Bogie-Rocker Joint.SLDPRT, King Joint.SLDPRT, MAVRIC.SLDASM, Rocker Rear Leg.SLDPRT, Suspension Assembly.SLDASM, Suspension Mirror.SLDASM, Wheel Joint.SLDPRT]
2013-11-26 Update diff link to correct length
    [Diff Link.SLDPRT, MAVRIC.SLDASM]
2013-11-26 Fix solidworks fubar
    [Chassis Assembly.SLDASM, King Pin.SLDPRT, MAVRIC.SLDASM, Suspension Assembly.SLDASM, Suspension Mirror.SLDASM]
2013-11-26 Add antennas to overall assembly
    [Chassis Assembly.SLDASM, Data Antenna.SLDPRT, MAVRIC.SLDASM, Video Antenna.SLDPRT]
2013-11-26 Lightening diff bar
    [Chassis Assembly.SLDASM, Diff Bar.SLDPRT, MAVRIC.SLDASM]
2013-11-26 Mount batteries in overall assembly
    [MAVRIC.SLDASM]
2013-11-26 Mastercam for Rocker Leg and Bogie Leg
2013-11-26 Add stepper driver
    [Bottom Cover.SLDPRT, Front Cover.SLDPRT, Gearbox Assembly.SLDASM, MAVRIC.SLDASM, Steering Assembly.SLDASM, Stepper Driver.SLDPRT, Suspension Assembly.SLDASM, Suspension Mirror.SLDASM]
2013-12-03 Crossbar weight reduction
    [Cross Bar.SLDPRT, MAVRIC.SLDASM, Steering Assembly.SLDASM, Suspension Assembly.SLDASM, Suspension Mirror.SLDASM]
2013-12-04 Side Rail weight reduction
    [Chassis Assembly.SLDASM, Chassis Side Rail.SLDPRT, MAVRIC.SLDASM]
2013-12-04 Reduce crossbar flange thickness
    [Chassis Assembly.SLDASM, Chassis Side Rail.SLDPRT, Cross Bar.SLDPRT, MAVRIC.SLDASM]
2013-12-04 Reduce Front Bar flange thickness
    [Chassis Assembly.SLDASM, Front Bar.SLDPRT, MAVRIC.SLDASM]
2013-12-04 Reduce Front Bar cutout offset
    [Chassis Assembly.SLDASM, Front Bar.SLDPRT]
2013-12-04 Update camera assembly
    Fix FCB EX1020 hole patterns.
    Add camera control board.
    [Camera Assembly.SLDASM, Camera Board.SLDPRT, Elbow.SLDPRT, FCB EX1020.SLDPRT, HS785HB Servo.SLDPRT, Servo Assembly.SLDASM]
2013-12-04 Add concept arm
    [Arm Assembly.SLDASM, Chassis Assembly.SLDASM, Dual Stage Housing.SLDPRT, Firgelli Base.SLDPRT, Firgelli Extension.SLDPRT, Firgelli Linear.SLDASM, Gearbox Assembly.SLDASM, Gearbox Mount.SLDPRT]
2013-12-04 Fix intercut spacing on Front Bar
    [Front Bar.SLDPRT]
2013-12-04 Update global assembly
    [Chassis Assembly.SLDASM, MAVRIC.SLDASM]
2013-12-04 Concept payload components
    [Large Payload.SLDPRT, Payload Frame.SLDPRT]
2013-12-05 FIX STUPID MATE CRAP!
    [Bogie Joint.SLDPRT, Bogie-Rocker Joint.SLDPRT, King Joint.SLDPRT, MAVRIC.SLDASM, Rocker Rear Leg.SLDPRT, Steering Assembly.SLDASM, Suspension Assembly.SLDASM, Suspension Mirror.SLDASM]
2013-12-05 Added Payload System into Assembly
    [Bogie Joint.SLDPRT, Bogie-Rocker Joint.SLDPRT, Cell Battery Assembly.SLDASM, Drop Plate.SLDPRT, King Joint.SLDPRT, Large Payload.SLDPRT, MAVRIC.SLDASM, MirrorPayload Bottom Clip.SLDPRT]
2013-12-05 Create camera mount system
    [Camera Anchor.SLDPRT, Camera Assembly.SLDASM, Camera Leg.SLDPRT, Camera Mount.SLDPRT, Elbow.SLDPRT, Servo Frame.SLDPRT, Side Leg.SLDPRT]
2013-12-05 Mount camera system
    [Camera Assembly.SLDASM, Camera Mount.SLDPRT, Chassis Side Rail.SLDPRT]
2013-12-05 New stuff
    [98416A211.SLDPRT]
2013-12-05 Fix camera anchor
    [Camera Anchor.SLDPRT, Camera Assembly.SLDASM]
2013-12-05 Added Photo
    [Camera Anchor.SLDPRT, Camera Assembly.SLDASM]
2013-12-06 Added Ordering Forms
    [MAVRIC McMaster Order 12-6-13.xlsx]
2013-12-09 Updated Ordering Forms
    [MAVRIC Amazon Order 12-6-13.xlsx, MAVRIC McMaster 12-6-13.xlsx, MAVRIC McMaster Order 12-6-13.xlsx, MAVRIC OnlineMetalsOrder 12-6-13.xlsx]
2013-12-09 Updated Mastercam for Rocker to Bogie Joint
2013-12-10 Moved Reports to Dropbox
    [MAVRIC Amazon Order 12-6-13.xlsx, MAVRIC McMaster 12-6-13.xlsx, MAVRIC OnlineMetalsOrder 12-6-13.xlsx]
2013-12-11 Added New mastercam files for Bogie Joint / Misc. New fixturing parts
    [Bogie Joint (Modified for CAM).SLDPRT, Bogie Joint Fixturing Assembly.SLDASM, Bogie Joint Fixturing Plate.SLDPRT, King Joint Fixturing plate.SLDPRT]
2013-12-11 Updated Bogie Joint Mastercam file
2013-12-13 Updated Tools in Mastercam files / Added Wheel Joint Mastercam
    [Wheel Joint (Modified for CAM).SLDPRT, Wheel Joint Fixturing Assembly.SLDASM, Wheel Joint Fixturing Plate.SLDPRT, Wheel Joint.SLDPRT]
2013-12-29 Updated Mastercam for Wheel Joint
2013-12-30 upper and lower arm (weight down)
    took a good amount of the weight down on both pieces
    [Lower Arm.SLDPRT, Upper Arm.SLDPRT]
2014-01-03 Migrating Files From CNC Machine
    [Hole Fixturing Plate.SLDPRT, Hole Plate Assembly.SLDASM, Wheel Joint Hole Pattern.SLDASM, Wheel Joint Hole Plate.SLDPRT, Yoke Fixture Plate.SLDPRT]
2014-01-03 Fab drawing
    [King Pin.SLDDRW]
2014-01-06 Add missing machining relief fillet
    [Camera Mount.SLDPRT]
2014-01-06 Propagate changes to assemblies
    [Camera Assembly.SLDASM, Suspension Assembly.SLDASM, Suspension Mirror.SLDASM]
2014-01-06 Update steering plate thickness
    Increase tearout distance in drop plates.
    Increase thickness of steering plate to fit
    [Drop Plate.SLDPRT, Steering Assembly.SLDASM, Steering Top Plate.SLDPRT, Suspension Assembly.SLDASM, Suspension Mirror.SLDASM, Wheel Assembly.SLDASM]
2014-01-06 Add fabrication drawings for drop plates
    [Drop Plate Waterjet.SLDASM, Drop Plate Waterjet.SLDDRW, MAVRIC_DropPlate_Dim.DXF, MAVRIC_DropPlate_NoDim.DXF]
2014-01-06 Upper and Lower Arm
    Rebuild them the right way, they look a lot better now. (also simpler)
    [Lower Arm.SLDPRT, Upper Arm.SLDPRT]
2014-01-06 Upper and lower
    [Lower Arm.SLDPRT, Upper Arm.SLDPRT]
2014-01-06 Update side rail height
    Stock problem, need to reduce height to less than 4"
    [Chassis Assembly.SLDASM, Chassis Side Rail.SLDPRT]
2014-01-08 Updated Mastercam for King Joint and Chassis
2014-01-08 Deleted unneeded Chassis Parts/Added Mastercam for Cross Bar
    [98585A109.SLDPRT, Ball Joint Assembly.SLDASM, Ball Joint Ball.SLDPRT, Ball Joint Housing.SLDPRT, Chassis 2.SLDASM, Cross Member.SLDPRT, Diff Bar Axle.SLDPRT, Diff Bar.SLDPRT]
2014-01-08 Update camera mount to use premade clevis pins
    [90156A259.SLDPRT, 98416A211.SLDPRT, Camera Assembly.SLDASM, Camera Mount.SLDPRT]
2014-01-08 Reduce crossbar thickness
    Neck down the middle of the crossbar to fix intersection with top cover
    and battery assembly introduced in
    23dd18734d2d7d3443c654bee0143aaf699bfa82
    [Chassis Assembly.SLDASM, Cross Bar.SLDPRT]
2014-01-09 Update bogie joint to as built
    [Bogie Joint.SLDPRT]
2014-01-09 soil sample tool Mastercam
    [bottomfixturingplate.SLDASM, bottomtabssoilsamplenew2013.SLDPRT, fixturing plate.SLDPRT, topfaseningpicenewsoilsample2013.SLDPRT]
2014-01-09 Added And Updated Mastercam Files
    [Cross Bar.SLDPRT]
2014-01-09 Fix broken mate
    [Suspension Assembly.SLDASM, Suspension Mirror.SLDASM]
2014-01-09 Add turn table
    [Turn Table Assembly.SLDASM, Turn Table Bottom.SLDPRT, Turn Table Top.SLDPRT]
2014-01-10 Add turn table to arm assembly as placeholder
    [Arm Assembly.SLDASM, Rotary Plate.SLDPRT]
2014-01-10 Added New Wheel Design
    [alexWheel.SLDPRT]
2014-01-10 Updated Diff Bar Design for Fabrication
    [Diff Bar.SLDPRT]
2014-01-11 Updated Folder Route and Added Mastercam Files
    [Diff Bar.SLDPRT]
2014-01-11 Updated Chassis Front Bar CAD and CAM and the main Assembly
    [Front Bar.SLDPRT]
2014-01-15 Update drive gearbox to correct hole pattern and length
    [Drop Plate.SLDPRT, P60_64_Gearbox.SLDPRT, Wheel Assembly.SLDASM]
2014-01-21 New drawings
    [MAVRIC_DropPlate_Dim.DXF, MAVRIC_DropPlate_NoDim.DXF]
2014-01-21 Apparently this needed to be rebuilt
    [Camera Assembly.SLDASM, Servo Assembly.SLDASM]
2014-01-26 Uploaded Drawing From Boyd's Computer
    [Front Bar Holes.SLDDRW]
2014-01-29 arm assembly 2014
    this is the new raw design of the new arm, there are still some
    constrains and some errors, but it's starting to look useful
    [Rotary Plate.SLDPRT, arm assembly 2014.SLDASM, lower arm 2014.SLDPRT, upper arm 2014.SLDPRT]
2014-01-29 arm assembly
    just found a better position for the bracket in the lower arm, there are
    3 small interferences, easy to fix.
    [arm assembly 2014.SLDASM, lower arm 2014.SLDPRT]
2014-02-04 Added battery bracket
    [Battery Bracket.SLDPRT]
2014-02-04 Added End Effector Parts
    [End Effector Assembly.SLDASM, Servo Bracket.SLDPRT, U bracket.SLDPRT]
2014-02-06 arm with lots of upgrades
    this new arm has a bracket for the actuator, and all the positions of
    the joints have been tested for its maximum efficiency. The base of the
    arm counts with a set of gears and a motor to spin the the base.
    [Rotary Plate.SLDPRT, arm assembly 2014.SLDASM, lower arm 2014.SLDPRT, lower arm side bracket.SLDPRT, lower gear small.SLDPRT, lower gear.SLDPRT, upper arm 2014.SLDPRT]
2014-02-06 Updated End Effector
    [End Effector Assembly.SLDASM]
2014-02-07 added L bracket
    [L bracket.SLDPRT]
2014-02-07 added and updated end effector parts
    [End Effector Assembly.SLDASM, L bracket.SLDPRT, Servo Bracket.SLDPRT]
2014-02-07 Added Soil Sample tool (Bucket)
    [Bucket.SLDPRT]
2014-02-09 Updated Gearbox components and Gearbox assembly
    [Cover Assembly.SLDASM, Dual Stage Output Disk-Reduced Diameter Version.SLDPRT, Dual Stage Output Disk.SLDPRT, First Stage Cycloidal Profile.SLDPRT, Second Stage Cycloidal Profile.SLDPRT]
2014-02-10 Fixed Main Assembly and added a few Rendered Photos
    [Arm Assembly.SLDASM, Chassis Assembly.SLDASM, Gearbox Assembly.SLDASM, Steering Assembly.SLDASM, Suspension Assembly.SLDASM, Suspension Mirror.SLDASM]
2014-02-11 arm ready for design review
    the arm has the gears selected for the base, there's also a base plate
    I've made to attach to the chassis. I've also taken down a lot of
    weight. This thing looks fantastic.
    [Drive Motor.SLDPRT, Rotary Plate.SLDPRT, Turn Table Bottom.SLDPRT, actuator mount.SLDPRT, arm assembly 2014.SLDASM, base.SLDPRT, lower arm 2014.SLDPRT, lower arm side bracket.SLDPRT]
2014-02-12 Added general design and servo part
    [Big Gear.SLDPRT, End Effector Assembly 2.SLDASM, Test Servo.SLDPRT]
2014-02-12 Updated Chassis and End Effector
    [Chassis Assembly.SLDASM, End Effector Assembly.SLDASM]
2014-02-12 Added servo assembly and parts
    [Big Gear Hub.SLDPRT, Big Gear.SLDPRT, Servo Assembly.SLDASM]
2014-02-13 Updated design of Battery Bracket
    [Battery Bracket.SLDPRT]
2014-02-14 added small gear assembly and parts
    [Small Gear Assembly.SLDASM, Small Gear.SLDPRT, Spindle.SLDPRT]
2014-02-18 arm weight reduction
    started to do weight reduction, many of the tap-holes are already made,
    looking pretty good.
    [Rotary Plate.SLDPRT, actuator mount.SLDPRT, arm assembly 2014.SLDASM, arm weight reduc.SLDASM, lower actuator mount.SLDPRT, lower arm 2014.SLDPRT, lower arm mount.SLDPRT, rotary plate new.SLDPRT]
2014-02-19 Bottom Chassis cover
    Initial upload, in process of completion
    [Chassis cover Bottom.SLDPRT]
2014-02-19 Added a lot of servo work
    [Big Gear Assembly.SLDASM, Big Gear Hub.SLDPRT, Big Gear.SLDPRT, End Effector Assembly 2.SLDASM, End Effector Assembly.SLDASM, Gear Box Bracket.SLDPRT, High Torque Gear Box Assembly.SLDASM, High Torque Gear Box Bracket.SLDPRT]
2014-02-19 started working on the arm base bracket
    pain in the butt, but i'm getting there.
    [arm weight reduc.SLDASM, base.SLDPRT, rotary plate new.SLDPRT]
2014-02-20 Differential Bar CAM and Camera Fixture Work
    [Camera CAM Mount Assembly.SLDASM, Camera Fixture 2.SLDPRT]
2014-02-21 almost fixed a new location for the motor drive
    if you open the arm weight reduc file, you can see a mount where the
    motor is resting. I am still trying to find a better spot, I will get it
    soon.
    [Drive Motor.SLDPRT, arm weight reduc.SLDASM, axis for base.SLDPRT, base.SLDPRT, rotary plate new.SLDPRT]
2014-02-22 created the end effector assembly for review
    [End Effector Assembly 2.SLDASM, End Effector Assembly 3.SLDASM, High Torque Gear Box Assembly.SLDASM, Low Torque Gear Box Assembly.SLDASM]
2014-02-25 mounts for the cross-bar, good motor location
    finally came up with a good location for the motor, started working on
    some brackets for the cross-bar
    [arm weight reduc.SLDASM, base.SLDPRT, cross-bar mount.SLDPRT, rotary plate new.SLDPRT]
2014-02-26 end effector assembly work added
    [Big Gear Assembly.SLDASM, Big Gear Hub.SLDPRT, Bracket (s1 to s2).SLDPRT, Bracket (s2 to s3).SLDPRT, End Effector Assembly 3.SLDASM, High Torque Gear Box Assembly.SLDASM, Low Torque Gear Box Assembly.SLDASM]
2014-02-26 deleted unnecessary file
    [Bracket (s2 to s3).SLDPRT]
2014-02-27 added work on servo bracket
    [Bracket (s1 to s2).SLDPRT, End Effector Assembly 3.SLDASM]
2014-02-27 added bracket work
    [Bracket (s1 to s2).SLDPRT, Bracket (s2 to s3).SLDPRT, End Effector Assembly 3.SLDASM]
2014-02-27 changed the second bracket
    [Bracket (s2 to s3).SLDPRT, End Effector Assembly 3.SLDASM]
2014-02-28 add version 1 of end effector assembly + brackets
    [End Effector Assembly 3.SLDASM]
2014-03-03 Added slots for grooves for bottom track
    [Chassis cover Bottom.SLDPRT]
2014-03-03 Top covers made
    Center cover needs hole cut for arm
    Front panel cover will be same as rear except for arm hole
    [Chassis Center cover.SLDPRT, Top Rear Cover panel.SLDPRT]
2014-03-04 Diff Yoke Updated
    [Diff Yoke.SLDPRT]
2014-03-04 Changed pattern on bottom cover to fit into bottom support
    [Chassis cover Bottom.SLDPRT]
2014-03-04 Fixed dimensions
    [Chassis Center cover.SLDPRT]
2014-03-04 Fixed more dimensions
    [Top Rear Cover panel.SLDPRT]
2014-03-05 added new bracket
    [bracket1-2.SLDPRT]
2014-03-06 Added bracket to connect servo 1 and 2
    [End Effector Assembly 3.SLDASM, Low Torque Gear Box Assembly.SLDASM, bracket1-2.SLDPRT]
2014-03-06 fixed bracket
    [End Effector Assembly 3.SLDASM, bracket1-2.SLDPRT]
2014-03-07 added stress test to end effector
    [Big Gear Assembly.SLDASM, Big Gear Hub.SLDPRT, Big Gear.SLDPRT, Bracket (s2 to s3).SLDPRT, End Effector Assembly 3.SLDASM, High Torque Gear Box Assembly.SLDASM, High Torque Gear Box Bracket.SLDPRT, High Torque Servo.SLDPRT]
2014-03-07 New ppt file and rendering for chassis bottom cover
    [Chassis cover Bottom.SLDPRT]
2014-03-08 Work on photo render for powerpoint
    [End Effector Assembly 3.SLDASM, High Torque Gear Box Assembly.SLDASM, Low Torque Gear Box Assembly.SLDASM, Small Gear Assembly.SLDASM, Small Gear and High Torque Servo Assembly.SLDASM, Small Gear and Low Torque Servo Assembly.SLDASM]
2014-03-08 Added end effector power point portion
    [End Effector Assembly 3.SLDASM, High Torque Gear Box Assembly.SLDASM, Low Torque Gear Box Assembly.SLDASM]
2014-03-08 Updates and made top front cover from copy of rear top
    [Chassis cover Bottom.SLDPRT, Top Front Cover panel.SLDPRT, Top Rear Cover panel.SLDPRT]
2014-03-08 added corrected low torque servo assembly
    [Big Gear Assembly.SLDASM, Big Gear Hub.SLDPRT, Big Gear.SLDPRT, Large Spindle.SLDPRT, Low Torque Gear Box Assembly.SLDASM, Low Torque Gear Box Bracket.SLDPRT, Low Torque Servo.SLDPRT, Small Gear Assembly.SLDASM]
2014-03-08 Fixed hole locations to fit chassis assembly
    [Chassis Center cover.SLDPRT, Chassis cover Bottom.SLDPRT, Top Front Cover panel.SLDPRT, Top Rear Cover panel.SLDPRT]
2014-03-08 Updated end effector assembly with corrections
    [End Effector Assembly 3.SLDASM, End Effector Assembly 4.SLDASM, High Torque Gear Box Assembly.SLDASM, Small Gear and High Torque Servo Assembly.SLDASM]
2014-03-08 updated bracket and powerpoint
    Put a chamfer on the bracket and did more of the powerpoint
    [Battery Bracket.SLDPRT]
2014-03-11 added updated gearbox brackets
    [High Torque Gear Box Bracket.SLDPRT, High Torque Gear Box Bracket2.SLDPRT]
2014-03-12 GEARS FINALLY WORK
    After a very intense period of crying and torture, I've been able to
    find a good solution for the spinning mechanism of the arm. Almost all
    of it could be machined right now. Last thing to work on is the
    attachments to the cross-member.
    [actuator mount.SLDPRT, arm weight reduc.SLDASM, axis for base.SLDPRT, lower actuator mount.SLDPRT, lower arm 2014.SLDPRT, lower arm mount.SLDPRT, motor mount.SLDPRT, new-gear-assembly.SLDASM]
2014-03-12 Camera Mount Mastercam
2014-03-12 Camera Fixture
    [Camera Fixture.SLDPRT]
2014-03-13 added work on the end effector brackets
    [Bracket (s2 to s3).SLDPRT, End Effector Assembly 4.SLDASM, High Torque Gear Box Assembly.SLDASM, bracket1-2.SLDPRT, bracket2-3.SLDPRT]
2014-03-13 Camera Mount Fixture Mastercam
2014-03-13 added bracket for servo 2 to servo 3
    [Bracket (s2 to s3).SLDPRT, End Effector Assembly 4.SLDASM, bracket1-2.SLDPRT, bracket2-3.SLDPRT]
2014-03-13 Battery Bracket Render
2014-03-13 Chassis assembly render and Powerpoint
2014-03-13 added servo bracket (needs revision and testing)
    [End Effector Assembly 4.SLDASM, bracket1-2.SLDPRT, bracket2-3.SLDPRT]
2014-03-14 arm updates and power point portion
    Here's some new things on the arm, I' still deciding where to put the
    cross member mounts, but I'll get there today. Here's also my portion of
    the pp.
    [arm weight reduc.SLDASM, cross-bar mount.SLDPRT, rotary plate new.SLDPRT]
2014-03-21 Modified Chassis Covers and Upper Arm
    [Bottom Cover Mold Top.SLDPRT, Bottom Cover Mold.SLDPRT, Bottom cover Mold Assembly.SLDASM, Chassis Assembly.SLDASM, Cross Bar.SLDPRT, Fiberglass Bottom Covers.SLDPRT, upper arm 2014.SLDPRT]
2014-03-21 Updated Arm Components
    [arm weight reduc.SLDASM, lower arm 2014.SLDPRT, new-gear-assembly.SLDASM, rotary plate new.SLDPRT]
2014-03-22 Reorganization and Misc. File Cleanup
    [Arm Assembly.SLDASM, Drive Motor.SLDPRT, Gearbox Mount.SLDPRT, Lower Arm.SLDPRT, Rotary Plate.SLDPRT, Upper Arm.SLDPRT, actuator mount.SLDPRT, arm assembly 2014.SLDASM]
2014-03-22 Updated Material Thickness on Arm / Added Mastercam for Base Plate
2014-03-22 Deleted Study Files
    [arm weight reduc.SLDASM, lower arm (1.5in Thick).SLDPRT, new-gear-assembly.SLDASM, upper arm 2014.SLDPRT]
2014-03-24 modified arm with correct mounts
    Did some modifications to the arm to work properly and also changed a
    bit the mounts to accommodate the new size of it.
    [actuator mount.SLDPRT, arm weight reduc.SLDASM, axis for base.SLDPRT, lower arm (1.5in Thick).SLDPRT, lower arm mount.SLDPRT, new-gear-assembly.SLDASM, rotary plate new.SLDPRT]
2014-03-27 finished base bracket design
    [End Effector Assembly 4.SLDASM, Small Gear Assembly.SLDASM, Small Gear and High Torque Servo Assembly.SLDASM, Small Gear and Low Torque Servo Assembly.SLDASM, bracket1-2.SLDPRT, bracket2-3.SLDPRT]
2014-03-27 Cover Panels for Rover
    [Bottom Cover Mold Top.SLDPRT, Bottom Cover Mold.SLDPRT, Bottom cover Mold Assembly.SLDASM, Center composite panel.SLDPRT, Chassis Assembly.SLDASM, Chassis Top Right Composite.SLDPRT, Fiberglass Bottom Covers.SLDPRT]
2014-04-01 Organized
    It was messy, fixed also update chassis top right cover panel
    [Battery Bracket.SLDPRT, Bottom Cover Mold Top.SLDPRT, Bottom Cover Mold.SLDPRT, Bottom Cover.SLDPRT, Bottom cover Mold Assembly.SLDASM, Center composite panel.SLDPRT, Chassis Assembly.SLDASM, Chassis Center cover.SLDPRT]
2014-04-03 work on weight reduction of bracket
    [bracket2-3.SLDPRT]
2014-04-03 weight reduction of bracket 2-3 "completed"
    [End Effector Assembly 4.SLDASM, bracket2-3.SLDPRT]
2014-04-03 Upper Arm Cam
2014-04-03 Molds done
    [Chassis Top Right Composite.SLDPRT]
2014-04-08 fixed a hub on the servos
    [Big Gear Assembly.SLDASM, Big Gear.SLDPRT, End Effector Assembly 4.SLDASM, bracket2-3.SLDPRT]
2014-04-08 weight recud end effector bracket corrected
    just some minor adjustments
    [End Effector Assembly 4.SLDASM, bracket2-3.SLDPRT]
2014-04-08 weight reduc end effector bracket recorrected
    some weight reduction was made and also some stress tests to make sure
    it worked properly.
    [Big Gear Assembly.SLDASM, End Effector Assembly 4.SLDASM, bracket2-3.SLDPRT]
2014-04-10 changes to brackets
    [End Effector Assembly 4.SLDASM, bracket2-3.SLDPRT]
2014-04-10 big gear hub radius fixed
    [Big Gear Hub.SLDPRT]
2014-04-10 finished bracket 2-3
    [bracket2-3.SLDPRT]
2014-04-10 weight reduction of end effector
    [Big Gear Assembly.SLDASM, End Effector Assembly 4.SLDASM, bracket1-2.SLDPRT]
2014-04-11 weight reduction continued
    [End Effector Assembly 4.SLDASM, bracket1-2.SLDPRT, bracket2-3.SLDPRT]
2014-04-11 (finally) finished end effector model
    [End Effector Assembly 4.SLDASM, bracket1-2.SLDPRT, bracket2-3.SLDPRT]
2014-04-11 Added fillets
    [bracket2-3.SLDPRT]
2014-04-11 Reduce weight
    [bracket1-2.SLDPRT]
2014-04-15 tying up loose ends with model
    [End Effector Assembly 4.SLDASM, bracket1-2.SLDPRT, bracket2-3.SLDPRT]
2014-04-17 new chassis mounts
    did some major cleaning on the folder, created the brackets to hold the
    arm to the chassis
    [Cross Bar Mount 2.sldprt, Cross Bar.SLDPRT, Gearbox Mount.SLDPRT, Mold Cavity.SLDASM, Turn Table Bottom.SLDPRT, arm assembly 2014.SLDASM, arm weight reduc.SLDASM, arm.SLDASM]
2014-04-26 Updated MAVRIC Assembly with new subsystems
    [Camera Assembly.SLDASM, Cell Battery Assembly.SLDASM, Center composite panel.SLDPRT, Chassis Assembly.SLDASM, Chassis Top Right Composite.SLDPRT, Cover Assembly.SLDASM, Drive Motor.SLDPRT, Fiberglass Bottom Covers.SLDPRT]
2014-05-02 Chassis report (needs pictures)
2015-01-25 MAVRIC KiCad Component Library Created
    Will contain all custom parts for the MAVRIC PCBs
2015-01-25 Added AZ34063UMTR-G1 to KiCad Lib
    Voltage regulator
2015-01-25 Added ST485CDR to KiCad Lib
    RS485 to RS422 Transceiver
2015-01-25 Added 485 and Battery connectors
    Still need footprints, but that's to be decided
2015-01-26 Added AP65552SP-13 Regulator
    Higher current regulator for servos on arm board
2015-01-26 Added AOZ1280CI Regulator
    Lower current for less intensive use cases (micro)
2015-01-26 Added servo plug
2015-01-26 Renamed incorrectly named STM32F401
2015-01-26 Added SyRen serial connector
2015-01-26 Added raspberry pi power connector
2015-01-28 Added 74LVCH244APW buffer
    Planned use for long PWM lines coming from arm board
2015-01-28 Added UIM240XX stepper connector
    All six pins in one connector for now
2015-01-28 Added connector for linear actuator feedback
2015-01-28 Added SWD Connector
2015-01-29 added MAVRIC footprint library
2015-01-30 added footprints for MicroSMP diode and inductor
    first time footprinting, may be some mistakes
2015-01-30 Added header footprints
2015-01-30 Fixed pins numbered 0, added wire pad
    Wire pad for power on arm board but will be replaced
2015-01-31 changed package pad of AP regulator to pin 9
    matches the footprint now
2015-02-07 Added ZXCT1107 Current Sense Part
    Also added .db files to gitignore because thumbs.db
2015-02-08 Fixed STM32 Part
    Deleted VSS and VDD that didn't exist. Added PD2
2015-02-18 Add ground to 485, add 232 header
2015-02-19 Update serial headers to 3pin (w/ gnd)
2015-03-05 Add plated mounting hole
2015-03-06 Add Molex RJ45 Jack footprint
    ISU-MAVRIC/MAVRIC_WheelPod#5
2015-03-07 Add 6 pad solder pad footprint
2016-09-24 Add AP6503 Regulator
    New 5v 3A regulator
2016-10-01 Rearranged folder
    [5905K230 Roller Bearing.SLDPRT, 5909K370.SLDPRT, 6383K120.SLDPRT, 6383K140 Input bearing.SLDPRT, 90156A259.SLDPRT, 98585A109.SLDPRT, 98585A121.SLDPRT, 98585A127.SLDPRT]
2016-11-04 Add Arduino Practice Board
    Arduino board to practice soldering as a fun project to newbs. Contains
    ordering information and reciepts.
    [ArduinoPracticeBoard BOM.xlsx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]
2016-11-07 Init commit of Motherboard
    New motherboard using MSP432 as communication and periphrial controller
    [ArduinoPracticeBoard.kicad_pcb, Motherboard.kicad_pcb, Motherboard.sch]
2017-01-03 Add Card LEDs to the board
    [Motherboard.sch]
2017-01-06 Motherboard - Correct PINOUT to match TI pinmux, add HF X, create PCIe_36 footprint, add temperature sensor, create and assign netlist, BOM
    [Motherboard BOM.xlsx, Motherboard.sch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]
2017-01-08 Start layout of motherboard
    [Motherboard BOM.xlsx, Motherboard.sch]
2017-01-10 Finish Mobo v1.0
    Add XT60 power conector, add mounting holes, finish layout of
    Motherboard v1.0
    [Motherboard.kicad_pcb, Motherboard.sch]
2017-01-10 Create and Finish ControlCard v1.0
    The control board has 16 PWM outputs and 4 ADC inputs intended or
    feedback
    [ControlCard.kicad_pcb, ControlCard.sch, Motherboard BOM.xlsx]
2017-01-10 Add new connectors
2017-02-15 Soil Science board initial commit
    This is the science board without the edge card slot, motor controller,
    laser power supply, or any additional features to show up in the final
    design.
    [SoilBoard.kicad_pcb, SoilBoard.sch]
2017-05-24 Init commit mobo stm32
    Add the schematic for the STM32
    [STM32Motherboard.kicad_pcb, STM32Motherboard.sch]
